KN-Breadboard-Computing/computer/schematics/final-cu/final-cu.jpg

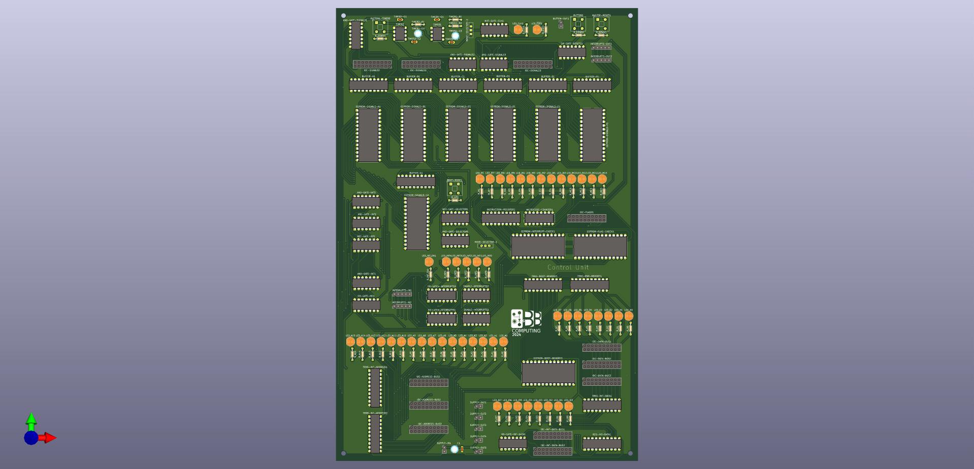
schematics/final-cu/final-cu.jpg
