KN-Breadboard-Computing/computer/schematics/final-alu/final-alu.jpg

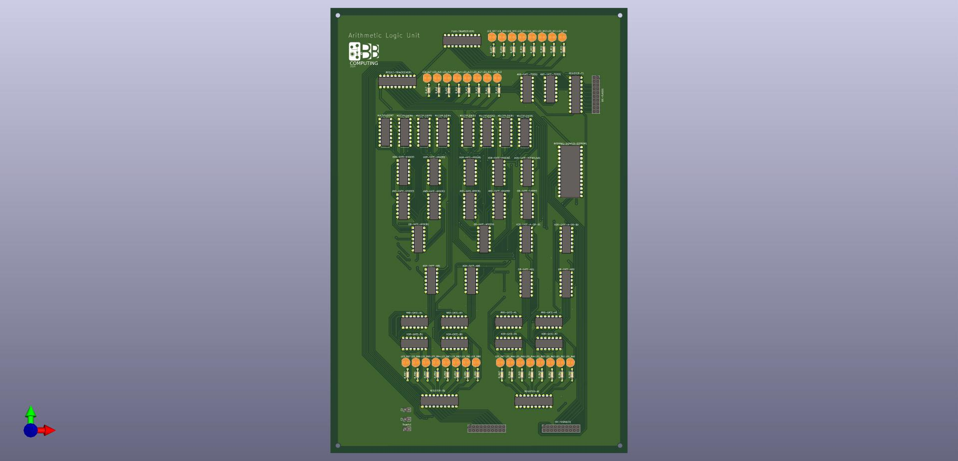
schematics/final-alu/final-alu.jpg
