KN-Breadboard-Computing/computer/eeproms-design/visualisations/MOVAIMM-MOVBA-MOVBIMM-MOVAB-MOVBIMM.html

0 | LOAD_PC_TO_MAR
1 | LOAD_MEM[MAR]_TO_IR_AND_MBR_PC++
2 | LOAD_PC_TO_MAR
3 | LOAD_MEM[MAR]_TO_A_PC++
4 | RST_MC
5 | LOAD_PC_TO_MAR
6 | LOAD_MEM[MAR]_TO_IR_AND_MBR_PC++
7 | LOAD_A_TO_B
8 | RST_MC
9 | LOAD_PC_TO_MAR
10 | LOAD_MEM[MAR]_TO_IR_AND_MBR_PC++
11 | LOAD_PC_TO_MAR
12 | LOAD_MEM[MAR]_TO_B_PC++
13 | RST_MC
14 | LOAD_PC_TO_MAR
15 | LOAD_MEM[MAR]_TO_IR_AND_MBR_PC++
16 | LOAD_B_TO_A
17 | RST_MC
18 | LOAD_PC_TO_MAR
19 | LOAD_MEM[MAR]_TO_IR_AND_MBR_PC++
20 | LOAD_PC_TO_MAR
21 | LOAD_MEM[MAR]_TO_B_PC++
22 | RST_MC

LOAD works on LOW to HIGH tick

TICK works on LOW to HIGH tick

EEPROM->REGS LATCHes are connected to CLK

signal name | init | | 0 | | | 1 | | | 2 | | | 3 | | | 4 | | | 5 | | | 6 | | | 7 | | | 8 | | | 9 | | | 10 | | | 11 | | | 12 | | | 13 | | | 14 | | | 15 | | | 16 | | | 17 | | | 18 | | | 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
CLK | L | | H | L | | H | L | | H | L | | H | L | | H | L | | H | L | | H | L | | H | L | | H | L | | H | L | | H | L | | H | L | | H | L | | H | L | | H | L | | H | L | | H | L | | H | L | | H | L | | 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
~CLK | H | | L | H | | L | H | | L | H | | L | H | | L | H | | L | H | | L | H | | L | H | | L | H | | L | H | | L | H | | L | H | | L | H | | L | H | | L | H | | L | H | | L | H | | L | H | | L | H | | 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
REG_A_LOAD (&~CLK) | L | | L | L | | L | L | | L | L | | L | H | | L | L | | L | L | | L | L | | L | L | | L | L | | L | L | | L | L | | L | L | | L | L | | L | L | | L | L | | L | L | | L | H | | L | L | | L | L | | 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
REG_B_LOAD (&~CLK) | L | | L | L | | L | L | | L | L | | L | L | | L | L | | L | L | | L | L | | L | H | | L | L | | L | L | | L | L | | L | L | | L | H | | L | L | | L | L | | L | L | | L | L | | L | L | | L | L | | 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
ALU_OPC_0 | L | | L | L | | L | L | | L | L | | L | L | | L | L | | L | L | | L | L | | L | L | | L | L | | L | L | | L | L | | L | L | | L | L | | L | L | | L | L | | L | L | | H | H | | L | L | | L | L | | 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
ALU_OPC_1 | L | | L | L | | L | L | | L | L | | L | L | | L | L | | L | L | | L | L | | L | L | | L | L | | L | L | | L | L | | L | L | | L | L | | L | L | | L | L | | L | L | | H | H | | L | L | | L | L | | 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
ALU_OPC_2 | L | | L | L | | L | L | | L | L | | L | L | | L | L | | L | L | | L | L | | H | H | | L | L | | L | L | | L | L | | L | L | | L | L | | L | L | | L | L | | L | L | | L | L | | L | L | | L | L | | 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
ALU_OPC_3 | L | | L | L | | L | L | | L | L | | L | L | | L | L | | L | L | | L | L | | L | L | | L | L | | L | L | | L | L | | L | L | | L | L | | L | L | | L | L | | L | L | | L | L | | L | L | | L | L | | 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
ALU_OPC_4 | L | | L | L | | L | L | | L | L | | L | L | | L | L | | L | L | | L | L | | L | L | | L | L | | L | L | | L | L | | L | L | | L | L | | L | L | | L | L | | L | L | | L | L | | L | L | | L | L | | 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
REG_F_LOAD (&~CLK) | L | | L | L | | L | L | | L | L | | L | L | | L | L | | L | L | | L | L | | L | L | | L | L | | L | L | | L | L | | L | L | | L | L | | L | L | | L | L | | L | L | | L | L | | L | L | | L | L | | 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
~REG_F_OUT | H | | H | H | | H | H | | H | H | | H | H | | H | H | | H | H | | H | H | | H | H | | H | H | | H | H | | H | H | | H | H | | H | H | | H | H | | H | H | | H | H | | H | H | | H | H | | H | H | | 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
~ALU_OUT | H | | H | H | | H | H | | H | H | | H | H | | H | H | | H | H | | H | H | | L | L | | H | H | | H | H | | H | H | | H | H | | H | H | | H | H | | H | H | | H | H | | L | L | | H | H | | H | H | | 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
REG_TMPH_LOAD (&~CLK) | L | | L | L | | L | L | | L | L | | L | L | | L | L | | L | L | | L | L | | L | L | | L | L | | L | L | | L | L | | L | L | | L | L | | L | L | | L | L | | L | L | | L | L | | L | L | | L | L | | 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
REG_TMPL_LOAD (&~CLK) | L | | L | L | | L | L | | L | L | | L | L | | L | L | | L | L | | L | L | | L | L | | L | L | | L | L | | L | L | | L | L | | L | L | | L | L | | L | L | | L | L | | L | L | | L | L | | L | L | | 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
~REG_TMPH_OUT | H | | H | H | | H | H | | H | H | | H | H | | H | H | | H | H | | H | H | | H | H | | H | H | | H | H | | H | H | | H | H | | H | H | | H | H | | H | H | | H | H | | H | H | | H | H | | H | H | | 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
~REG_TMPL_OUT | H | | H | H | | H | H | | H | H | | H | H | | H | H | | H | H | | H | H | | H | H | | H | H | | H | H | | H | H | | H | H | | H | H | | H | H | | H | H | | H | H | | H | H | | H | H | | H | H | | 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
~MCC_RST | H | | H | H | | H | H | | H | H | | H | H | | L | L | | H | H | | H | H | | H | H | | L | L | | H | H | | H | H | | H | H | | H | H | | L | L | | H | H | | H | H | | H | H | | L | L | | H | H | | 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
