KN-Breadboard-Computing/computer/photos/breadboards/alu-module.jpg

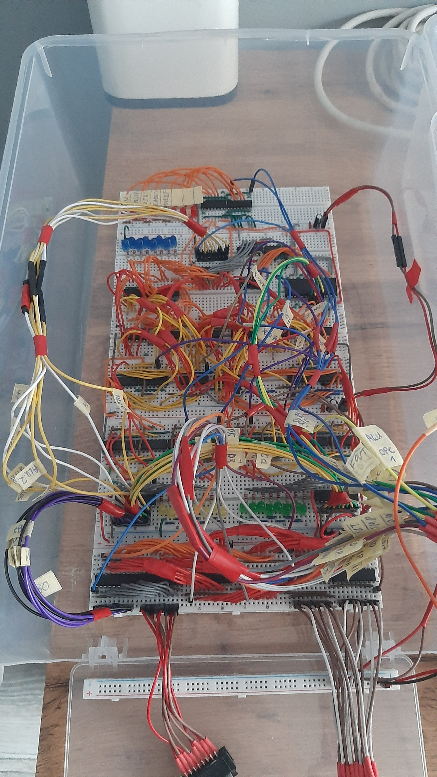
photos/breadboards/alu-module.jpg
