KN-Breadboard-Computing/computer/photos/breadboards/control-unit-clock-module.jpg

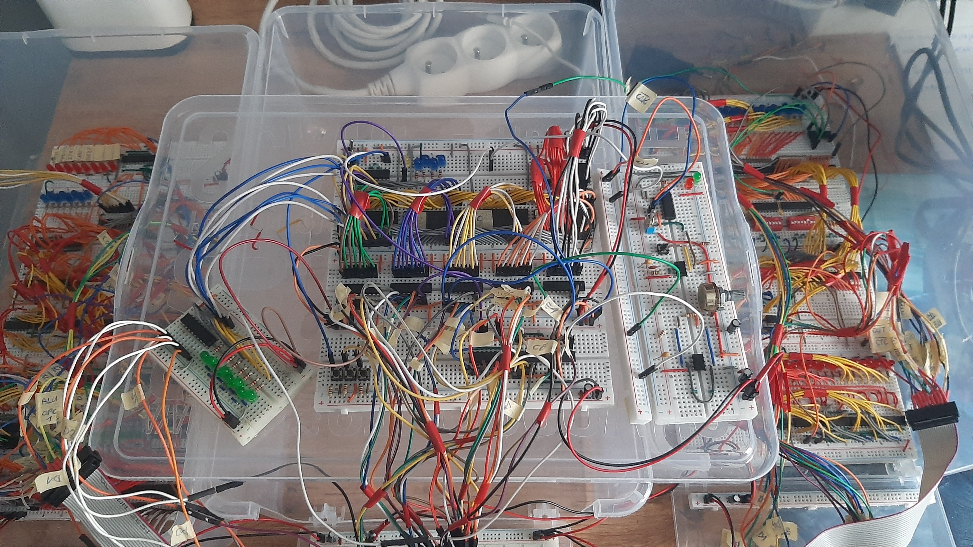
photos/breadboards/control-unit-clock-module.jpg
