KN-Breadboard-Computing/computer/photos/breadboards/linked-modules.jpg

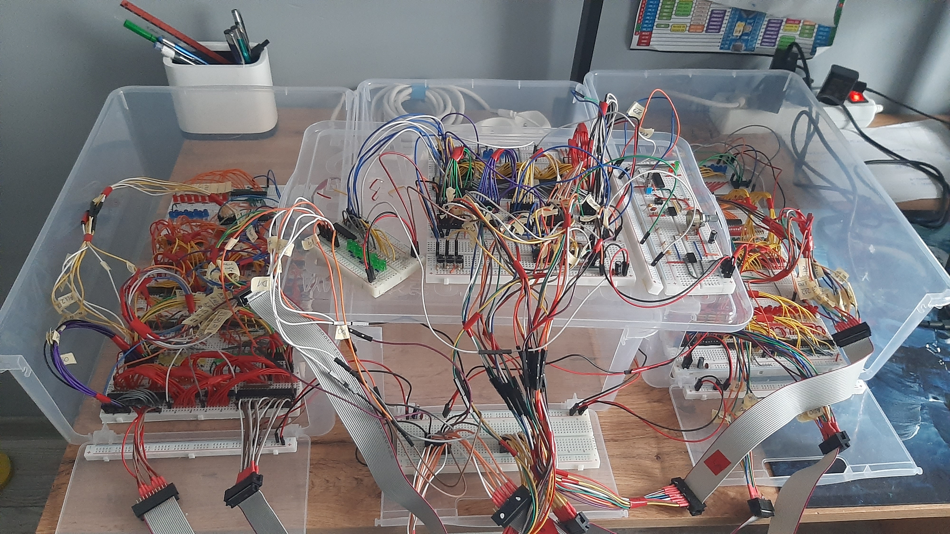
photos/breadboards/linked-modules.jpg
