KN-Breadboard-Computing/computer/photos/breadboards/memory-counters-module.jpg

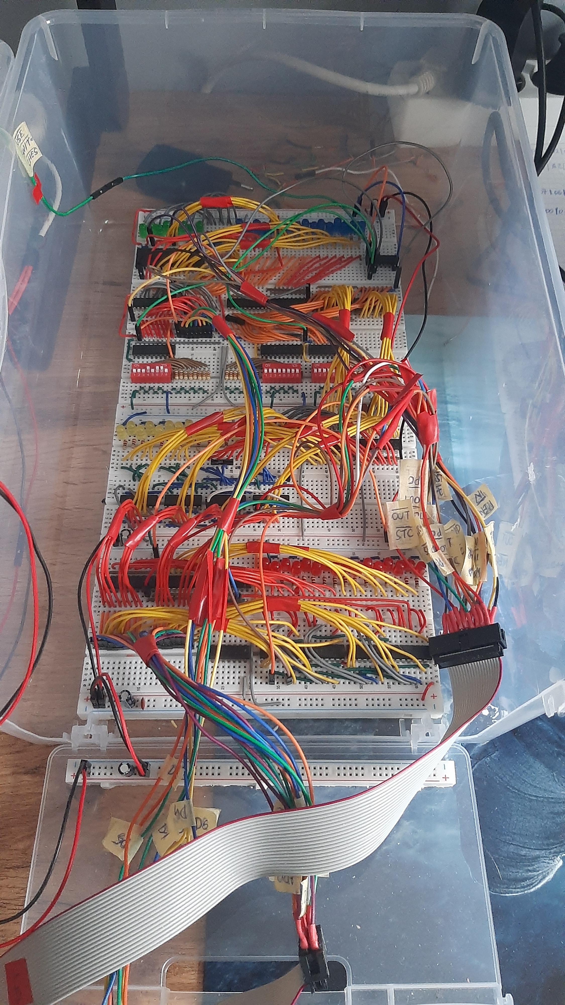
photos/breadboards/memory-counters-module.jpg
