KN-Breadboard-Computing/computer/photos/breadboards/powered-up-cpu-1.jpg

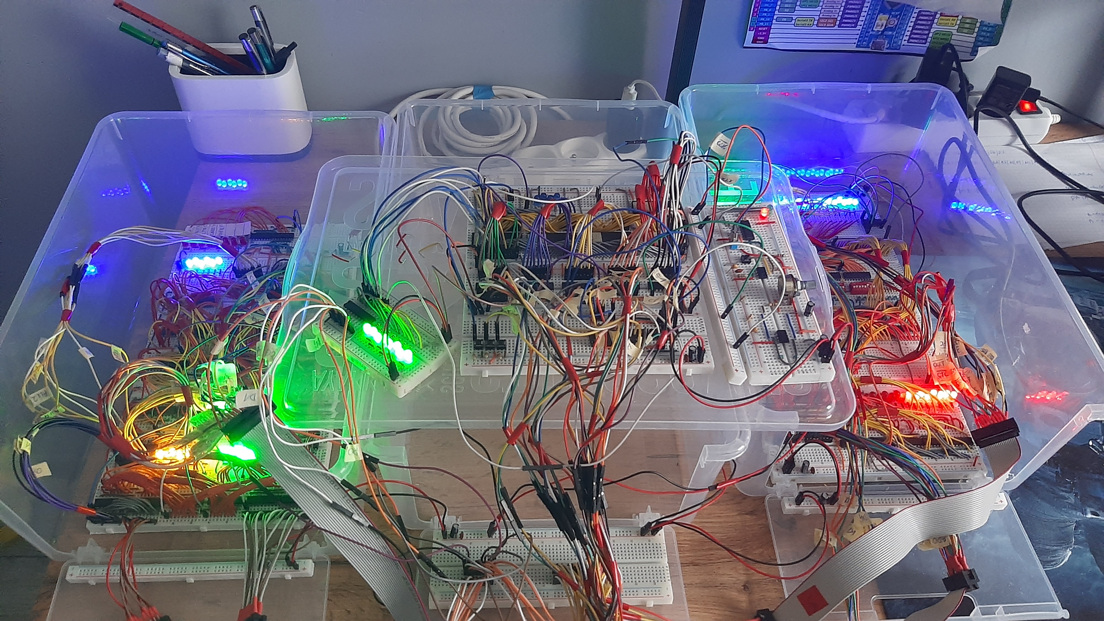
photos/breadboards/powered-up-cpu-1.jpg
