KN-Breadboard-Computing/computer/photos/breadboards/powered-up-cpu-2.jpg

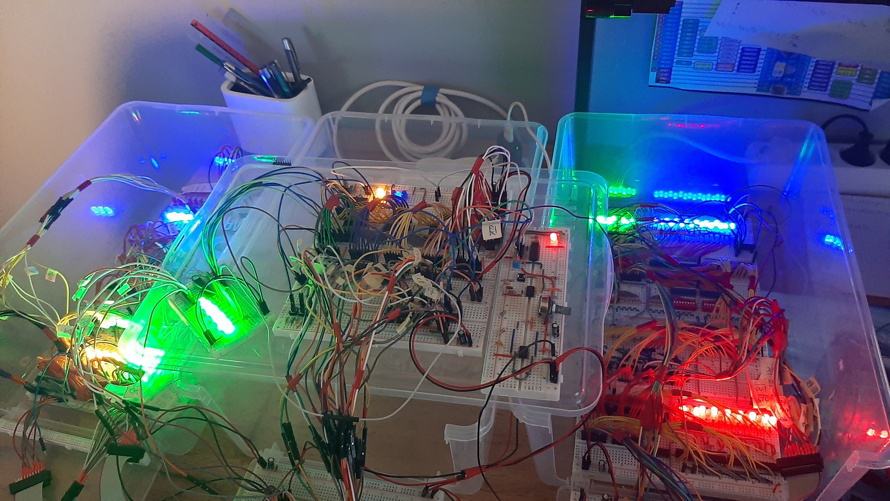
photos/breadboards/powered-up-cpu-2.jpg
