KN-Breadboard-Computing/computer/photos/diy_pcbs/20240428_120138.jpg

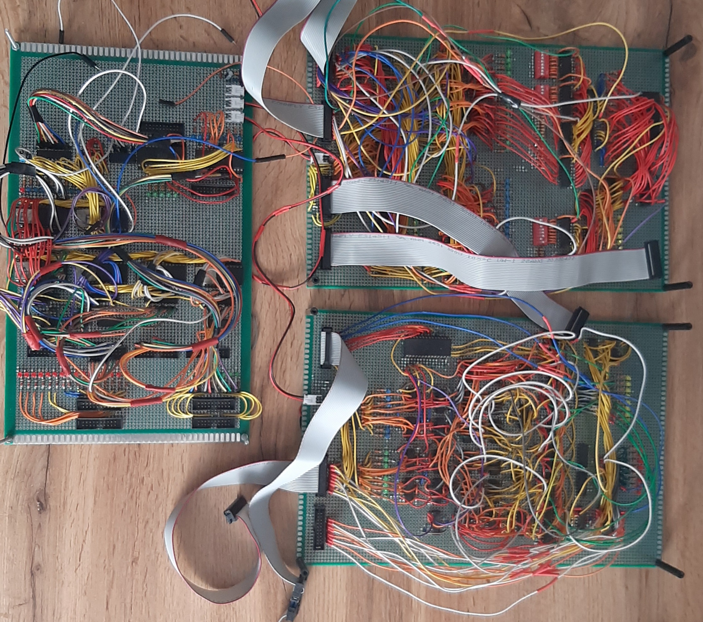
photos/diy_pcbs/20240428_120138.jpg
