KN-Breadboard-Computing/computer/photos/diy_pcbs/20240428_120143.jpg

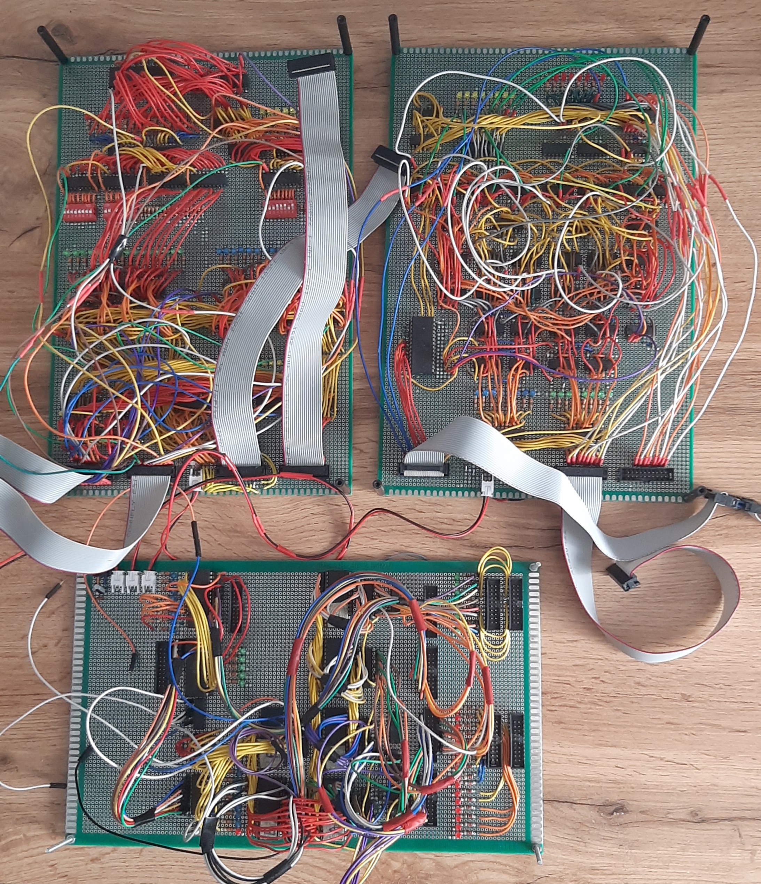
photos/diy_pcbs/20240428_120143.jpg
