KN-Breadboard-Computing/computer/photos/diy_pcbs/20240428_122211.jpg

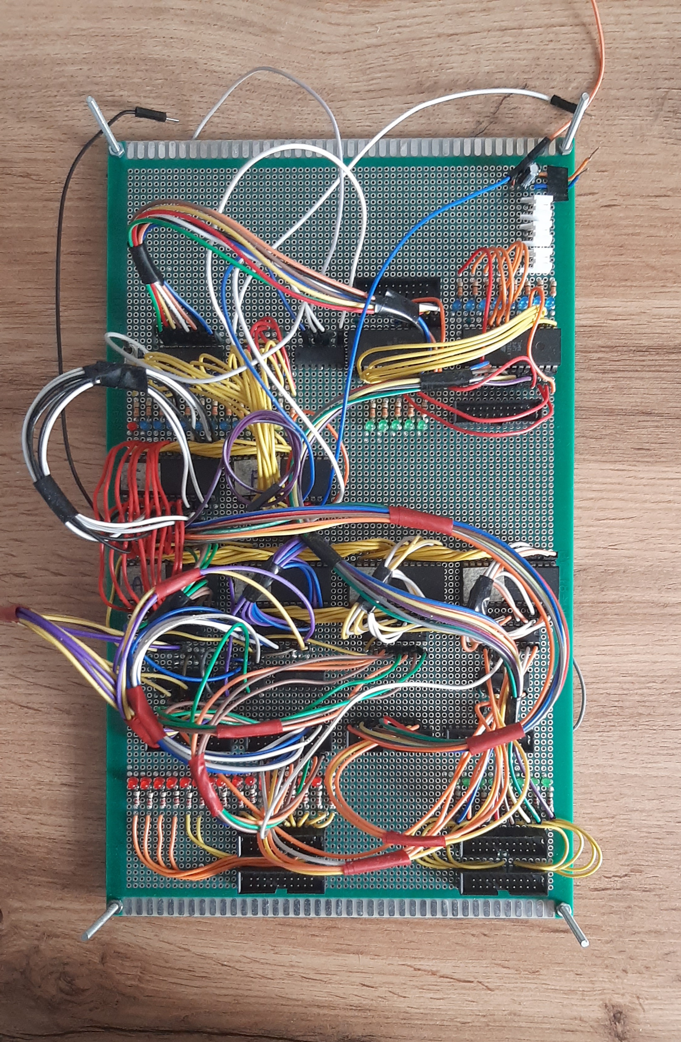
photos/diy_pcbs/20240428_122211.jpg
