KN-Breadboard-Computing/computer/schematics/additional-libraries/toggle-switch-47.snapshot.2/toggle_switch_3P.png

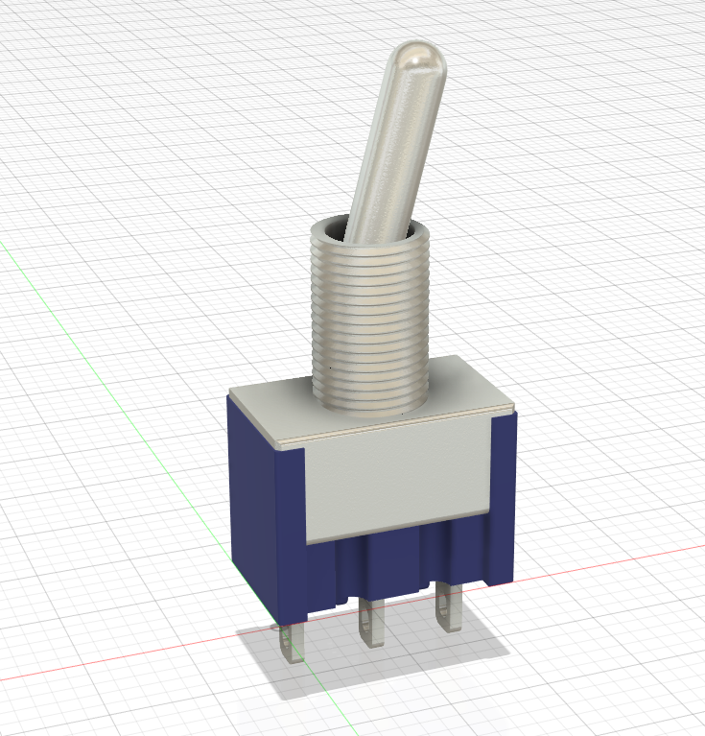
schematics/additional-libraries/toggle-switch-47.snapshot.2/toggle_switch_3P.png
