KN-Breadboard-Computing/computer/schematics/final-memory/final-memory.jpg

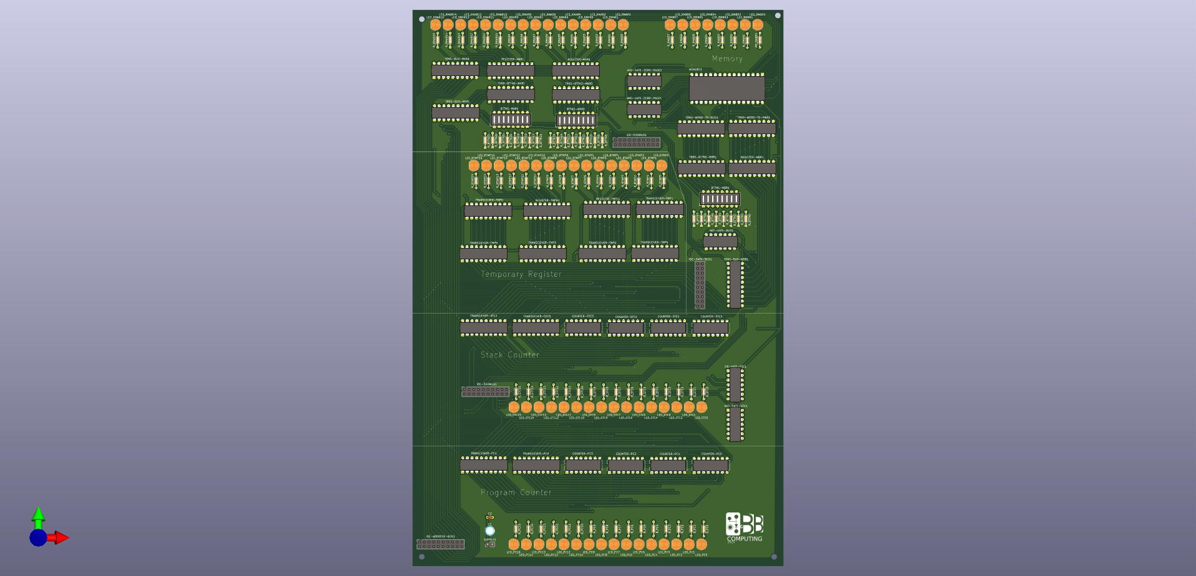
schematics/final-memory/final-memory.jpg
