KN-Breadboard-Computing/computer/schematics/additional-libraries/LIB_AT28C64B-15PU/AT28C64B-15PU/3D/AT28C64B-15PU.stp

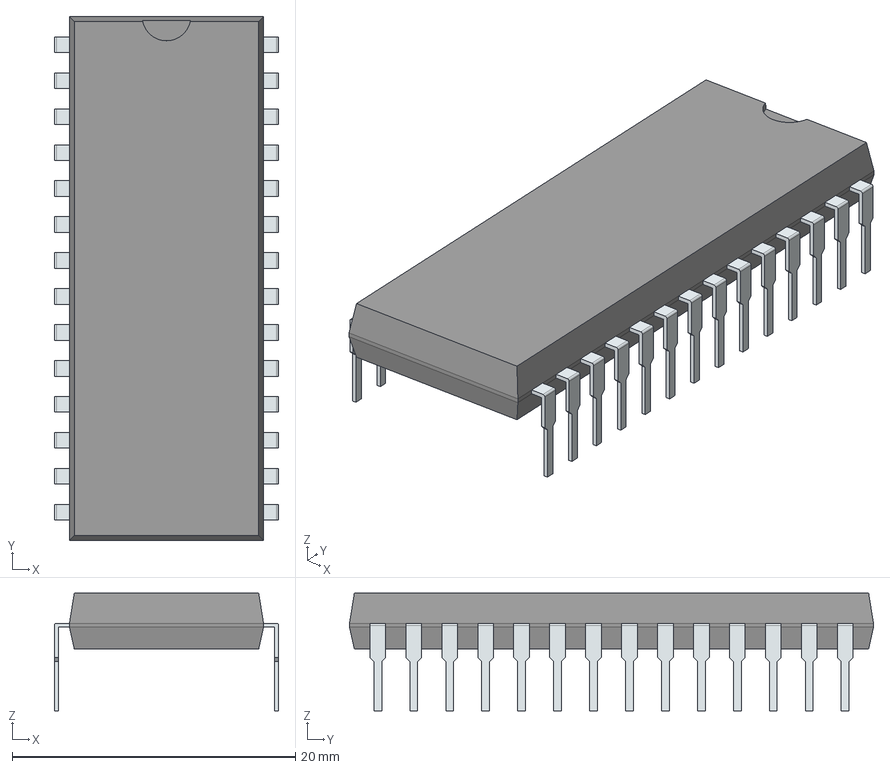
[picture p17: CAD file, 2024-05-19]
schematics/additional-libraries/LIB_AT28C64B-15PU/AT28C64B-15PU/3D/AT28C64B-15PU.stp
15.8 x 37.0 x 8.33 mm
PinsArrayLR
