KN-Breadboard-Computing/computer/schematics/additional-libraries/LIB_CD4030BEE4/CD4030BEE4/3D/CD4030BEE4.stp

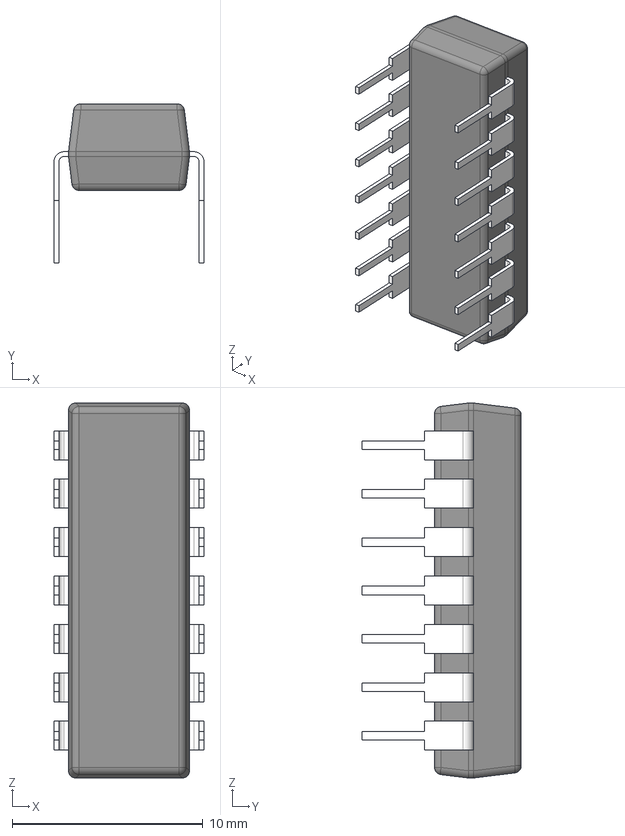
[picture p18: CAD file, 2024-05-19]
schematics/additional-libraries/LIB_CD4030BEE4/CD4030BEE4/3D/CD4030BEE4.stp
7.87 x 8.37 x 19.7 mm
BODY_N0014A_AF0
LEAD_N0014A_AF1
LEAD_N0014A x 10
LEAD_N0014A_AF3
LEAD_N0014A_AF0
LEAD_N0014A_AF2
