KN-Breadboard-Computing/computer/schematics/additional-libraries/LIB_CD4043BEE4/CD4043BEE4/3D/CD4043BEE4.stp

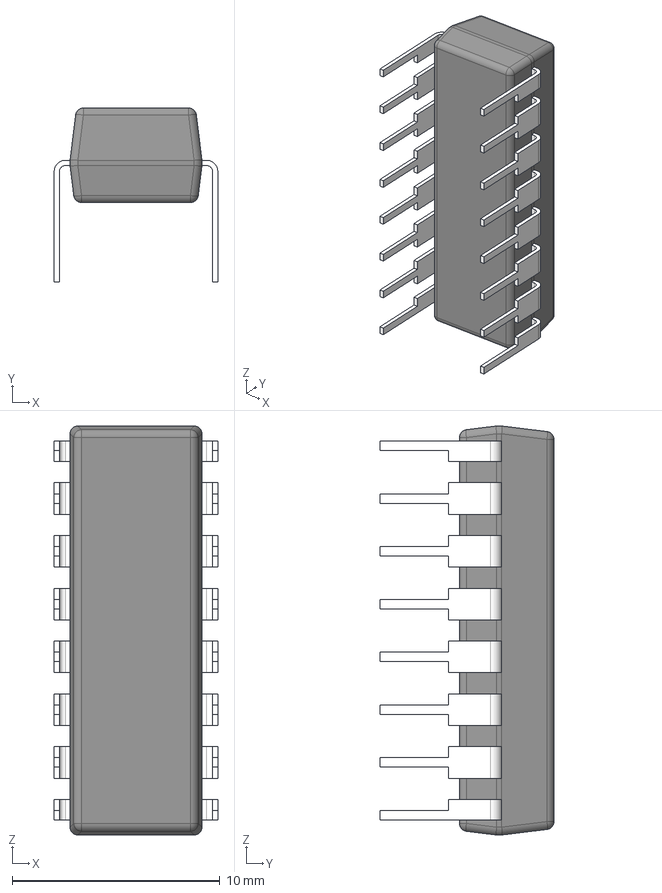
[picture p19: CAD file, 2024-05-19]
schematics/additional-libraries/LIB_CD4043BEE4/CD4043BEE4/3D/CD4043BEE4.stp
7.87 x 8.37 x 19.7 mm
BODY_N0016A_AF0
LEAD_N0016A_AF1
LEAD_N0016A x 10
LEAD_N0016A_AF3
LEAD_N0016A_AF5
LEAD_N0016A_AF0
LEAD_N0016A_AF2
LEAD_N0016A_AF4
