KN-Breadboard-Computing/computer/schematics/additional-libraries/LIB_DS1013-20SSIB1-B-0/DS1013-20SSIB1-B-0/3D/DS1013-20SSIB1-B-0.stp

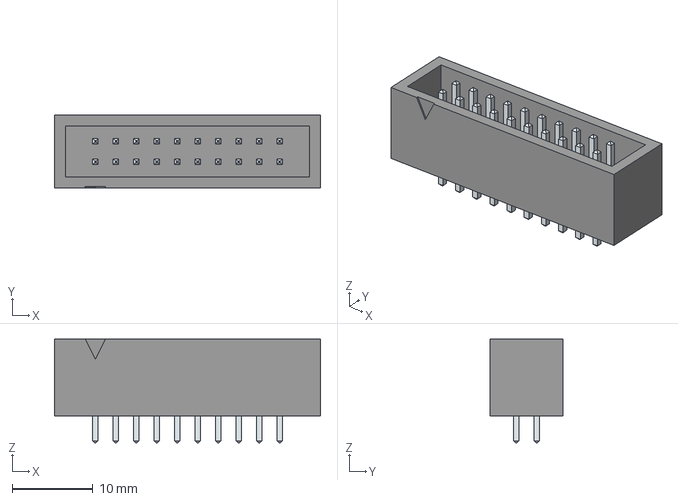
[picture p20: CAD file, 2024-05-19]
schematics/additional-libraries/LIB_DS1013-20SSIB1-B-0/DS1013-20SSIB1-B-0/3D/DS1013-20SSIB1-B-0.stp
33.0 x 9.10 x 12.9 mm
LeadsArray
