KN-Breadboard-Computing/computer/schematics/additional-libraries/LIB_SN74AC245N/SN74AC245N/3D/SN74AC245N.stp

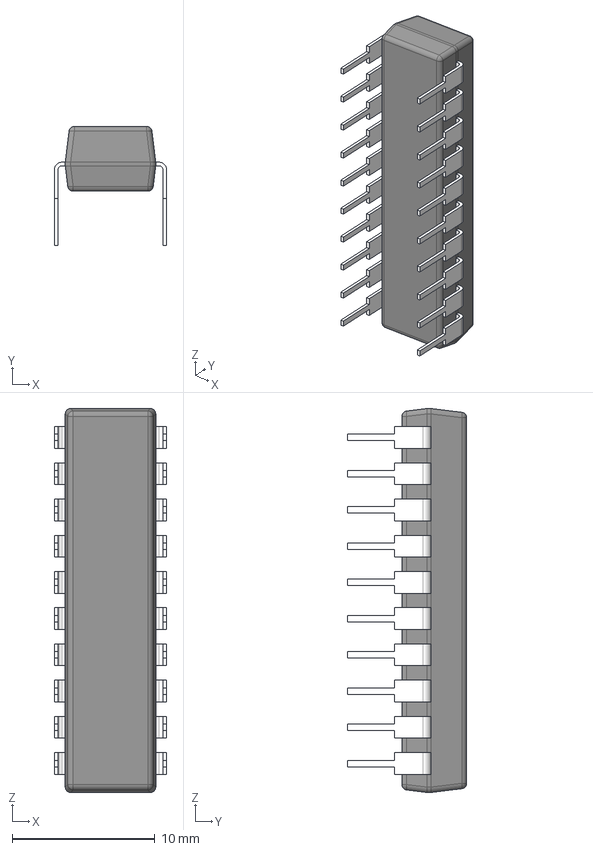
[picture p21: CAD file, 2024-05-19]
schematics/additional-libraries/LIB_SN74AC245N/SN74AC245N/3D/SN74AC245N.stp
7.87 x 8.37 x 26.9 mm
BODY_N0020A_AF0
LEAD_N0020A_AF1
LEAD_N0020A x 16
LEAD_N0020A_AF3
LEAD_N0020A_AF0
LEAD_N0020A_AF2
