KN-Breadboard-Computing/computer/schematics/additional-libraries/tactile-switches-6mm-tht-1.snapshot.2/models3d/Switches/TS6-THT_H-5.0.step

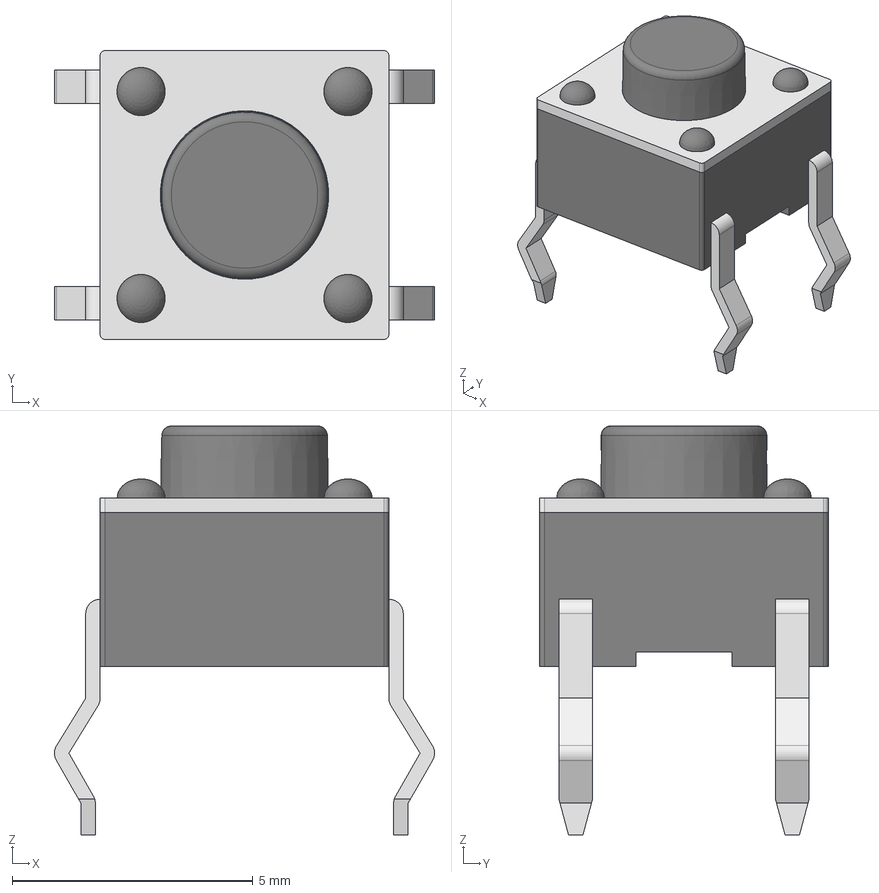
[picture p22: CAD file, 2024-05-19]
schematics/additional-libraries/tactile-switches-6mm-tht-1.snapshot.2/models3d/Switches/TS6-THT_H-5.0.step
7.90 x 6.00 x 8.50 mm
