KN-Breadboard-Computing/computer/schematics/additional-libraries/toggle-switch-47.snapshot.2/toggle_switch.step

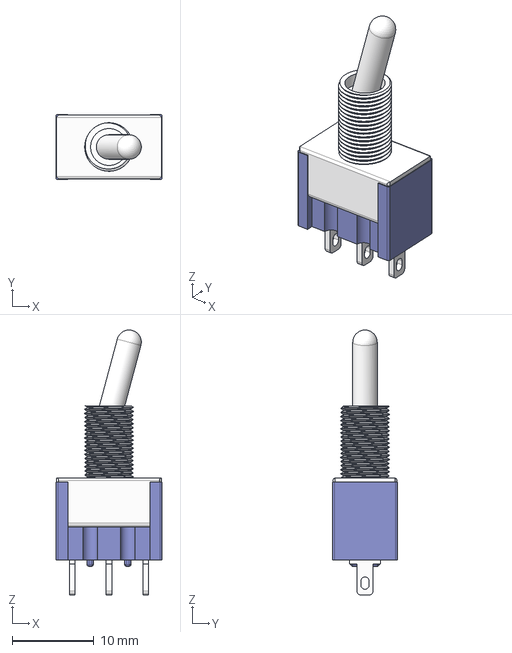
[picture p23: CAD file, 2024-05-19]
schematics/additional-libraries/toggle-switch-47.snapshot.2/toggle_switch.step
13.0 x 8.00 x 32.4 mm
