KN-Breadboard-Computing/computer/schematics/additional-libraries/tactile-switches-6mm-tht-1.snapshot.2/models3d/Switches/TS6-THT_H-20.0.step

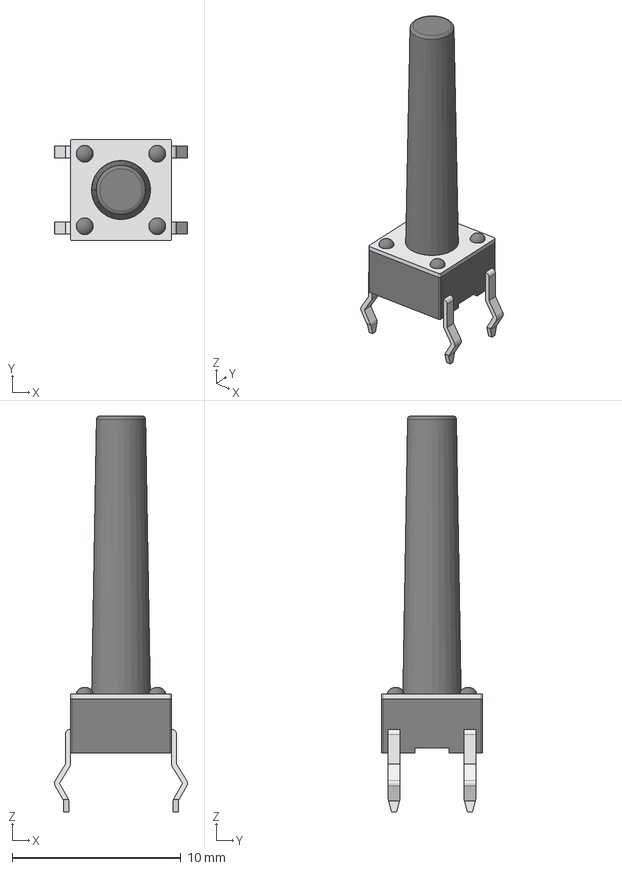
[picture p25: CAD file, 2024-05-19]
schematics/additional-libraries/tactile-switches-6mm-tht-1.snapshot.2/models3d/Switches/TS6-THT_H-20.0.step
7.90 x 6.00 x 23.5 mm
