KN-Breadboard-Computing/computer/(list of files, cad)

Other CAD files:
schematics/additional-libraries/tactile-switches-6mm-tht-1.snapshot.2/models3d/Switches/TS6-THT_H-7.5.step
schematics/additional-libraries/LIB_1825967-1/1825967-1/3D/1825967-1.stp
schematics/additional-libraries/LIB_1825967-1/1825967-1/Allegro/18259671.psm
schematics/additional-libraries/LIB_1825967-1/1825967-1/DEHDL/1825967_1/chips/chips.prt
schematics/additional-libraries/LIB_AS6C1008-55PCN/AS6C1008-55PCN/Allegro/dip254p1524x393-32.psm
schematics/additional-libraries/LIB_AS6C1008-55PCN/AS6C1008-55PCN/DEHDL/as6c1008_55pcn/chips/chips.prt
schematics/additional-libraries/LIB_AT28C64B-15PU/AT28C64B-15PU/Allegro/dip1556w56p254l3702h483q28n.psm
schematics/additional-libraries/LIB_AT28C64B-15PU/AT28C64B-15PU/DEHDL/at28c64b_15pu/chips/chips.prt
schematics/additional-libraries/LIB_CD4030BEE4/CD4030BEE4/Allegro/dip794w53p254l1930h508q14n.psm
schematics/additional-libraries/LIB_CD4030BEE4/CD4030BEE4/DEHDL/cd4030bee4/chips/chips.prt
schematics/additional-libraries/LIB_CD4043BEE4/CD4043BEE4/Allegro/dip794w53p254l1930h508q16n.psm
schematics/additional-libraries/LIB_CD4043BEE4/CD4043BEE4/DEHDL/cd4043bee4/chips/chips.prt
schematics/additional-libraries/LIB_CD4071BEE4/CD4071BEE4/Allegro/dip794w53p254l1930h508q14n.psm
schematics/additional-libraries/LIB_CD4071BEE4/CD4071BEE4/DEHDL/cd4071bee4/chips/chips.prt
schematics/additional-libraries/LIB_CD4081BEE4/CD4081BEE4/Allegro/dip794w53p254l1930h508q14n.psm
schematics/additional-libraries/LIB_CD4081BEE4/CD4081BEE4/DEHDL/cd4081bee4/chips/chips.prt
schematics/additional-libraries/LIB_CD74HC04E/CD74HC04E/Allegro/dip794w53p254l1930h508q14n.psm
schematics/additional-libraries/LIB_CD74HC04E/CD74HC04E/DEHDL/cd74hc04e/chips/chips.prt
schematics/additional-libraries/LIB_CD74HC193E/CD74HC193E/Allegro/dip794w53p254l1930h508q16n.psm
schematics/additional-libraries/LIB_CD74HC193E/CD74HC193E/DEHDL/cd74hc193e/chips/chips.prt
schematics/additional-libraries/LIB_DS1013-20SSIB1-B-0/DS1013-20SSIB1-B-0/Allegro/shdr20w69p254x254_2x10_3300x910x955p.psm
schematics/additional-libraries/LIB_DS1013-20SSIB1-B-0/DS1013-20SSIB1-B-0/DEHDL/ds1013_20ssib1_b_0/chips/chips.prt
schematics/additional-libraries/LIB_SN74AC245N/SN74AC245N/Allegro/dip794w53p254l2540h508q20n.psm
schematics/additional-libraries/LIB_SN74AC245N/SN74AC245N/DEHDL/sn74ac245n/chips/chips.prt
schematics/additional-libraries/LIB_SN74HC151N/SN74HC151N/Allegro/dip794w53p254l1930h508q16n.psm
schematics/additional-libraries/LIB_SN74HC151N/SN74HC151N/DEHDL/sn74hc151n/chips/chips.prt
schematics/additional-libraries/LIB_SN74HC574N/SN74HC574N/Allegro/dip794w53p254l2540h508q20n.psm
schematics/additional-libraries/LIB_SN74HC574N/SN74HC574N/DEHDL/sn74hc574n/chips/chips.prt
