KN-Breadboard-Computing/computer/schematics/final-cu/final-cu.pdf

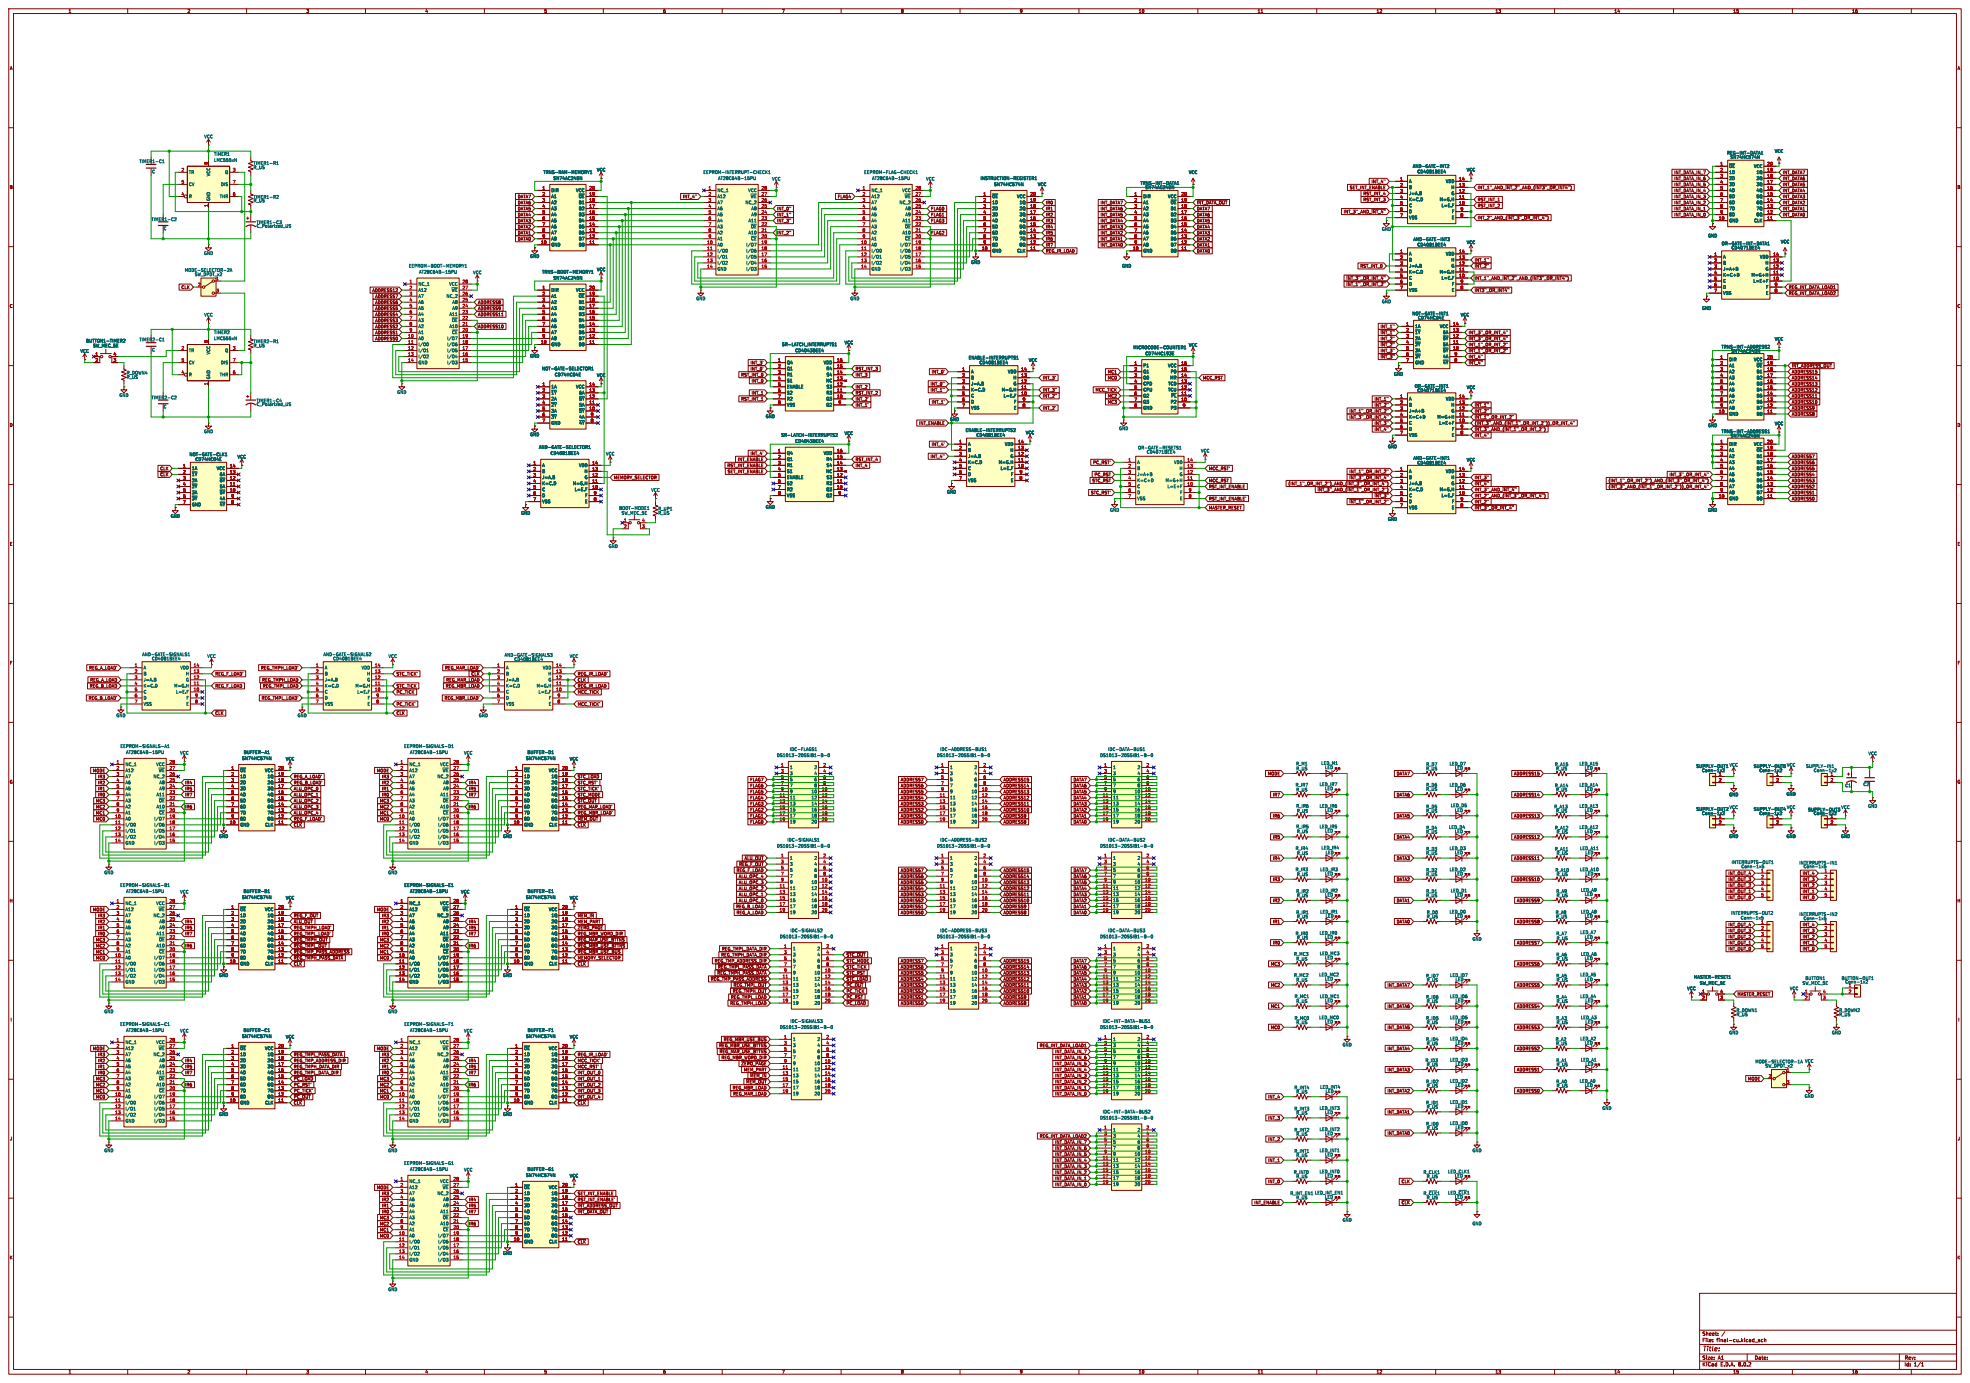
[picture p38: page 1]

9 OR-GATE-INT-DATA1 CD4071BEE4 GND

Id: 1/1 Title: File: final-cu.kicad_sch Sheet: /
