KN-Breadboard-Computing/computer/schematics/final-alu/final-alu.pdf

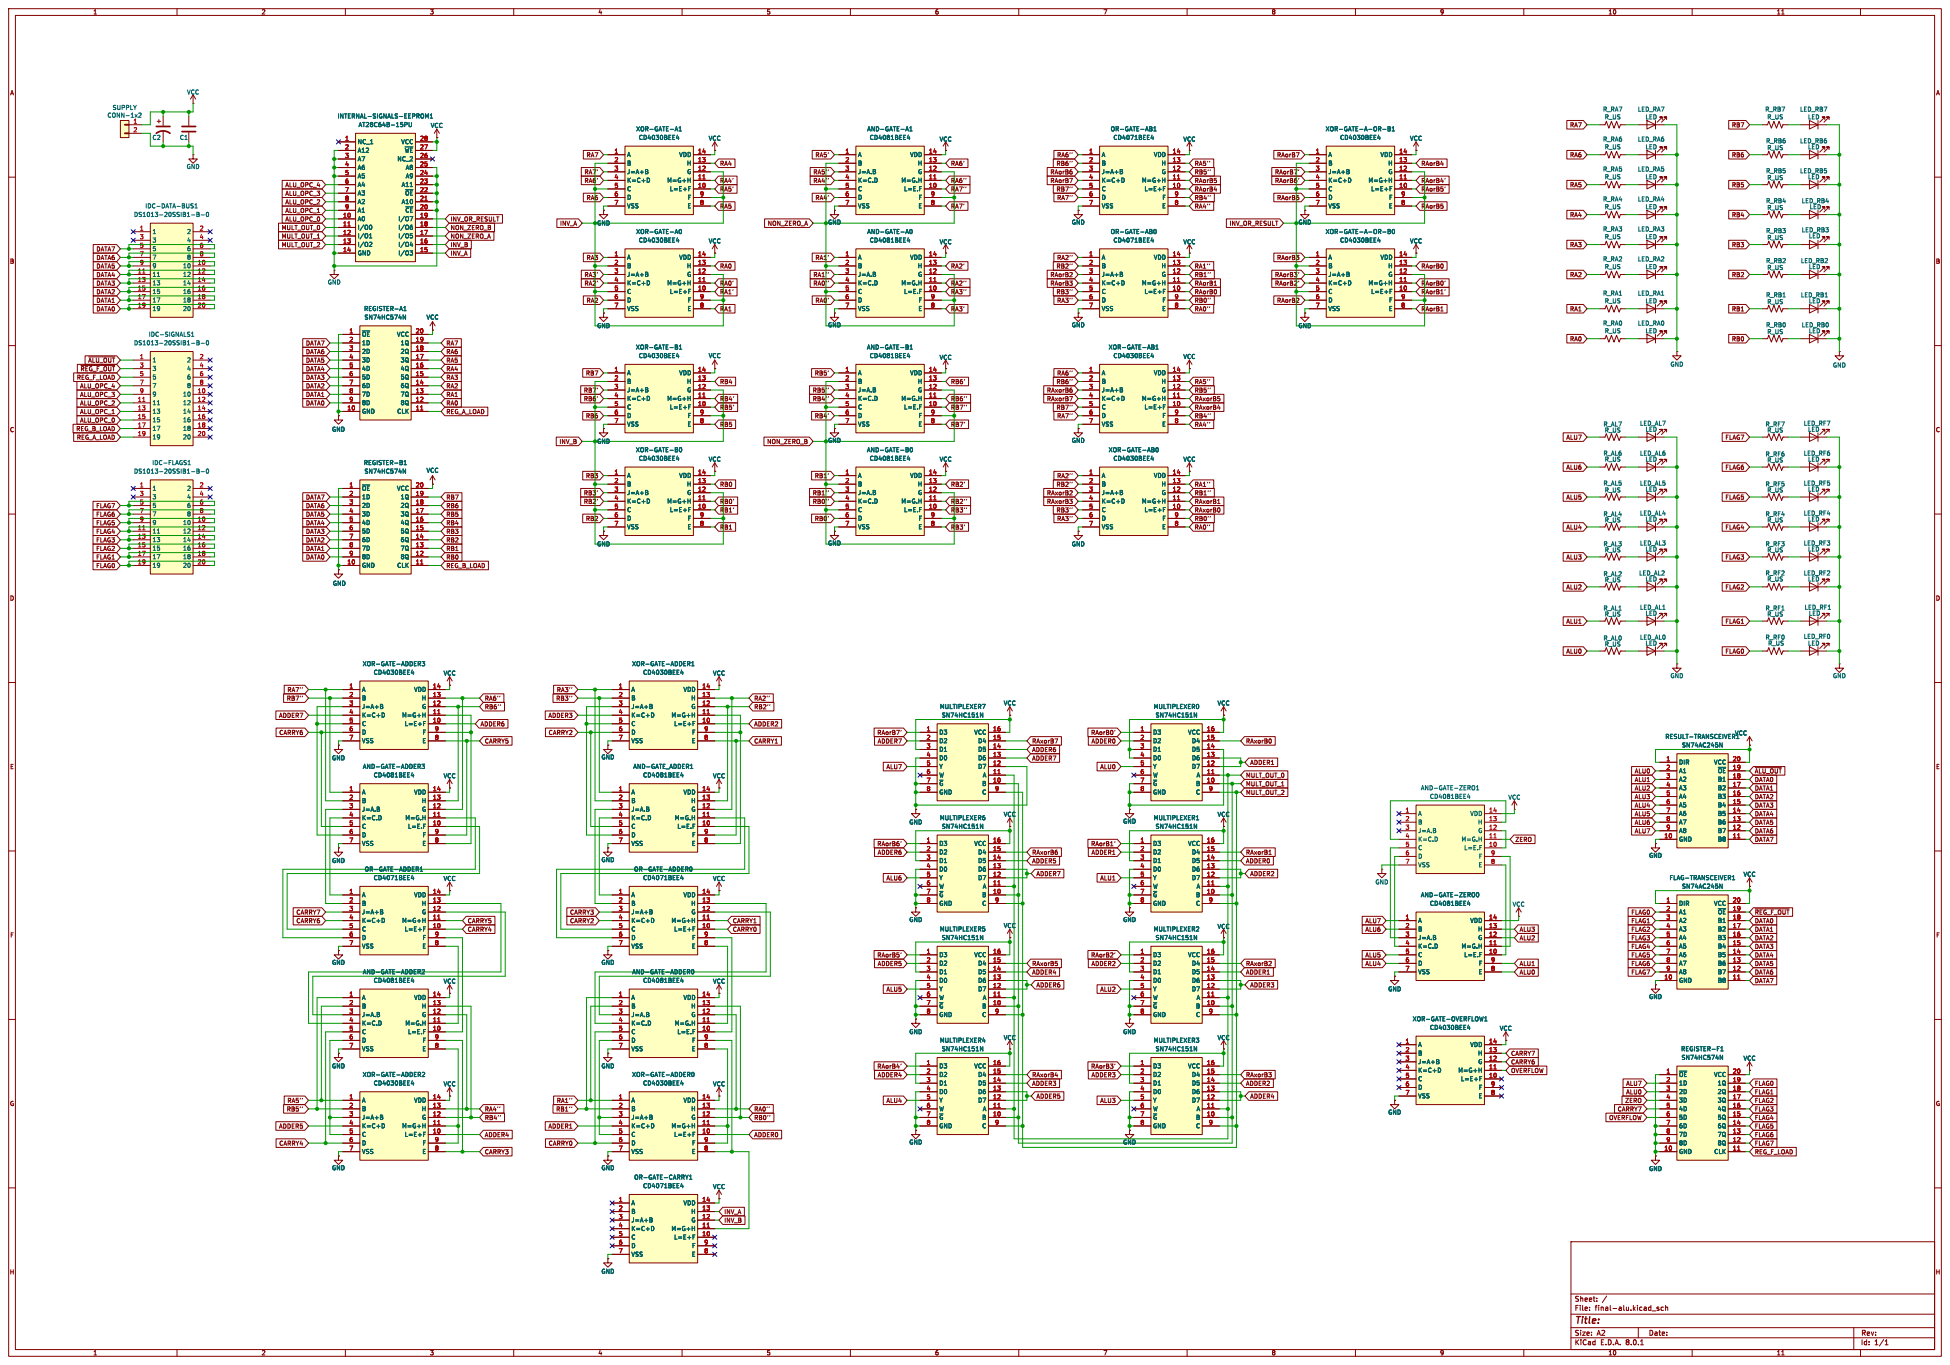
[picture p39: page 1]
