KN-Breadboard-Computing/computer/schematics/final-memory/final-memory.pdf

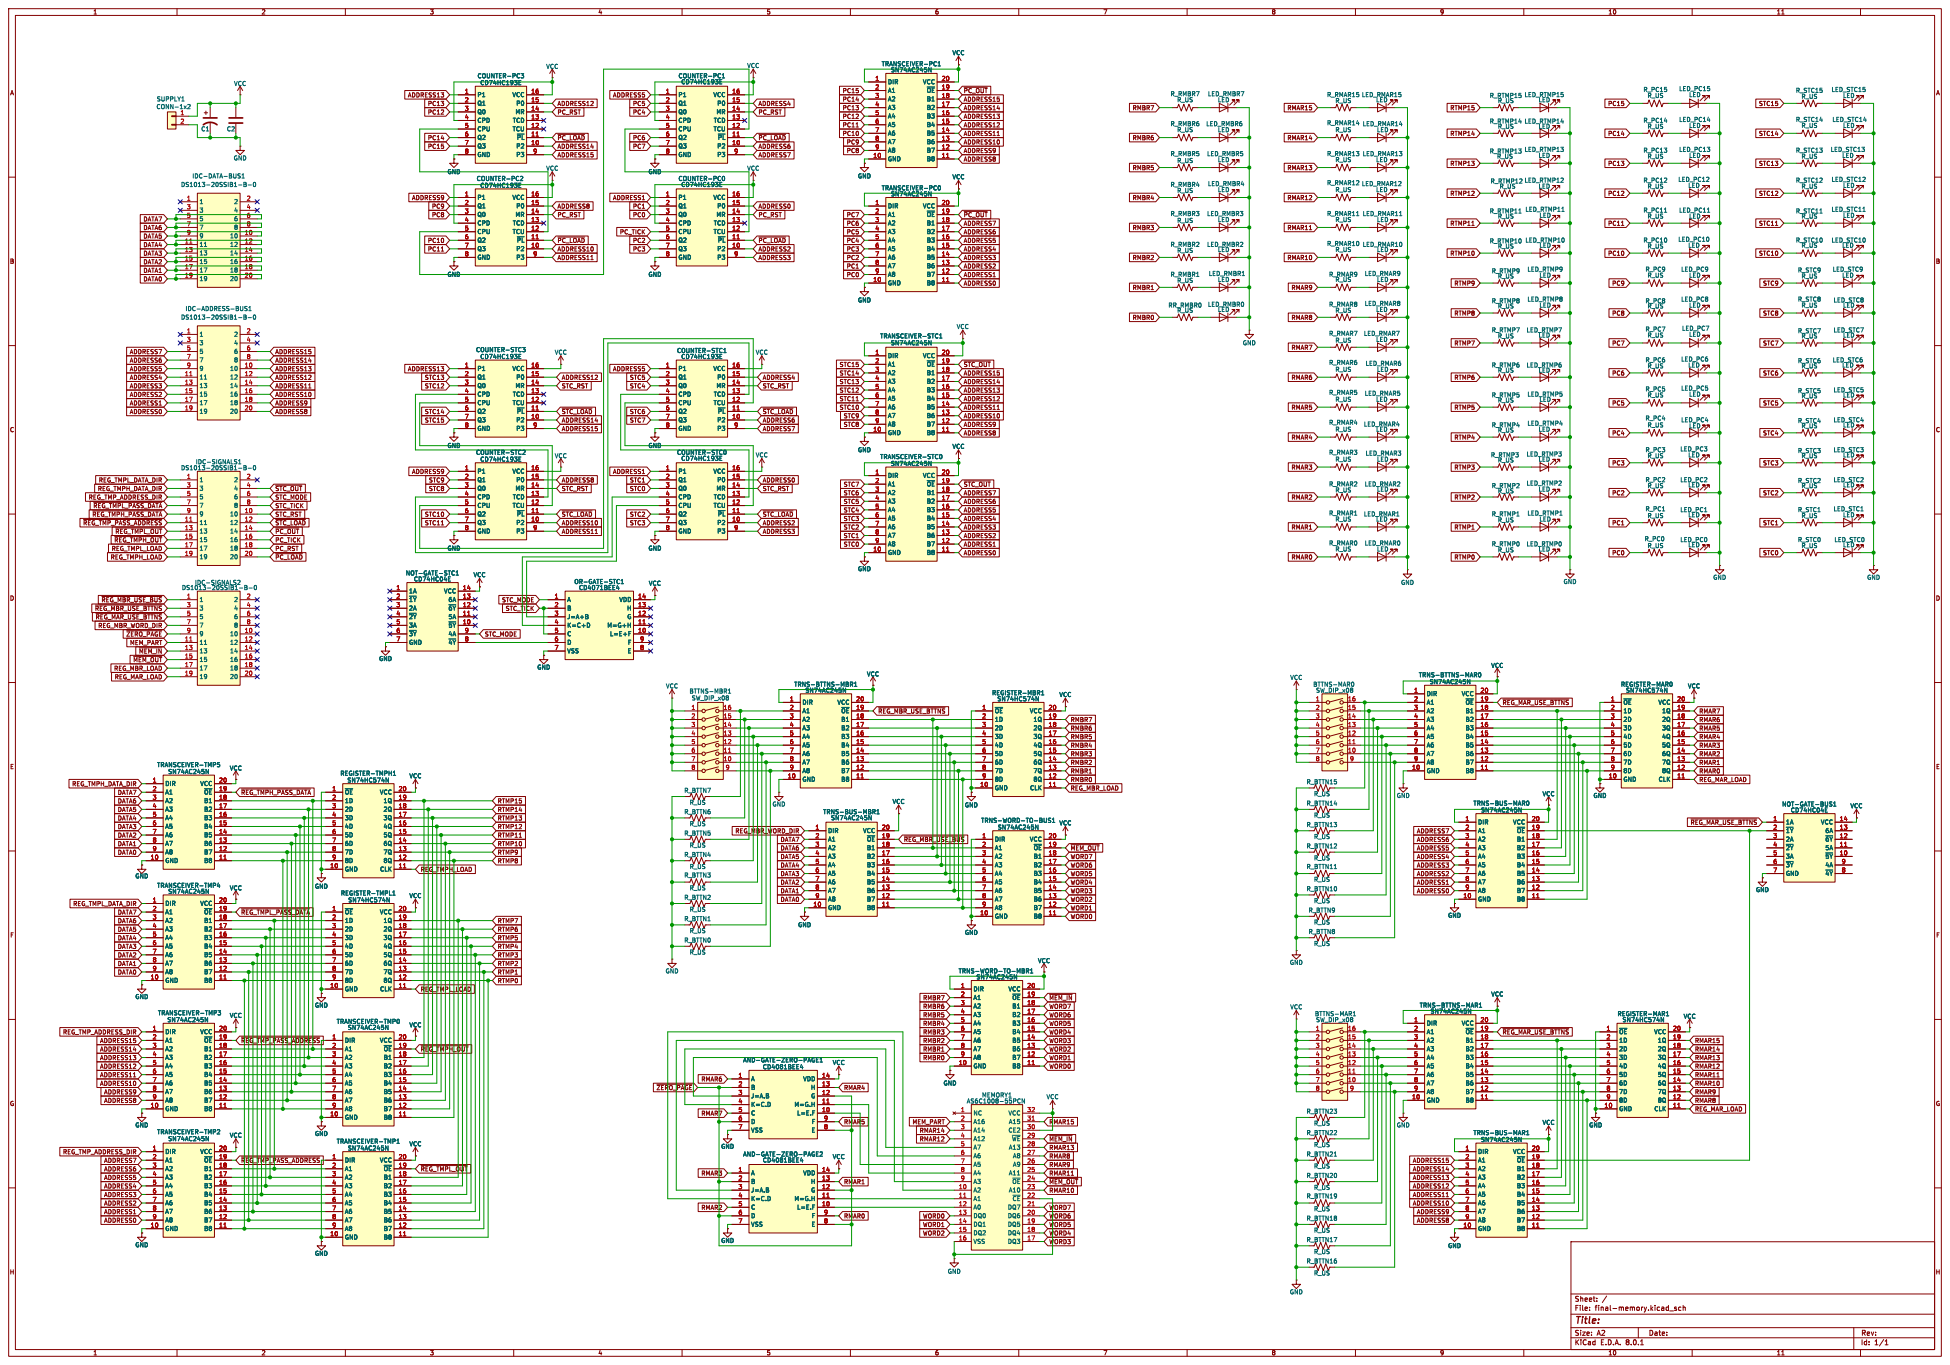
[picture p40: page 1]
