KN-Breadboard-Computing/computer/(list of files, drawings)

Other design files:
schematics/additional-libraries/LIB_AT28C64B-15PU/AT28C64B-15PU/Altium/AT28C64B-15PU.SchLib
schematics/additional-libraries/LIB_AT28C64B-15PU/AT28C64B-15PU/Altium/DIP1556W56P254L3702H483Q28N.PcbLib
schematics/additional-libraries/LIB_CD74HC04E/CD74HC04E/Altium/CD74HC04E.SchLib
schematics/additional-libraries/LIB_CD74HC04E/CD74HC04E/Altium/DIP794W53P254L1930H508Q14N.PcbLib
schematics/additional-libraries/LIB_CD4030BEE4/CD4030BEE4/Altium/CD4030BEE4.SchLib
schematics/additional-libraries/LIB_CD4030BEE4/CD4030BEE4/Altium/DIP794W53P254L1930H508Q14N.PcbLib
schematics/additional-libraries/LIB_CD4071BEE4/CD4071BEE4/Altium/CD4071BEE4.SchLib
schematics/additional-libraries/LIB_CD4071BEE4/CD4071BEE4/Altium/DIP794W53P254L1930H508Q14N.PcbLib
schematics/additional-libraries/LIB_CD4081BEE4/CD4081BEE4/Altium/CD4081BEE4.SchLib
schematics/additional-libraries/LIB_CD4081BEE4/CD4081BEE4/Altium/DIP794W53P254L1930H508Q14N.PcbLib
schematics/additional-libraries/LIB_DS1013-20SSIB1-B-0/DS1013-20SSIB1-B-0/Altium/DS1013-20SSIB1-B-0.SchLib
schematics/additional-libraries/LIB_DS1013-20SSIB1-B-0/DS1013-20SSIB1-B-0/Altium/SHDR20W69P254X254_2X10_3300X910X955P.PcbLib
schematics/additional-libraries/LIB_SN74AC245N/SN74AC245N/Altium/DIP794W53P254L2540H508Q20N.PcbLib
schematics/additional-libraries/LIB_SN74AC245N/SN74AC245N/Altium/SN74AC245N.SchLib
schematics/additional-libraries/LIB_SN74HC151N/SN74HC151N/Altium/DIP794W53P254L1930H508Q16N.PcbLib
schematics/additional-libraries/LIB_SN74HC151N/SN74HC151N/Altium/SN74HC151N.SchLib
schematics/additional-libraries/LIB_SN74HC574N/SN74HC574N/Altium/DIP794W53P254L2540H508Q20N.PcbLib
schematics/additional-libraries/LIB_SN74HC574N/SN74HC574N/Altium/SN74HC574N.SchLib
