KN-Breadboard-Computing/computer/schematics/final-alu/final-alu.kicad_pcb

## KiCad design schematics/final-alu/final-alu.kicad_pcb (2024-05-23)

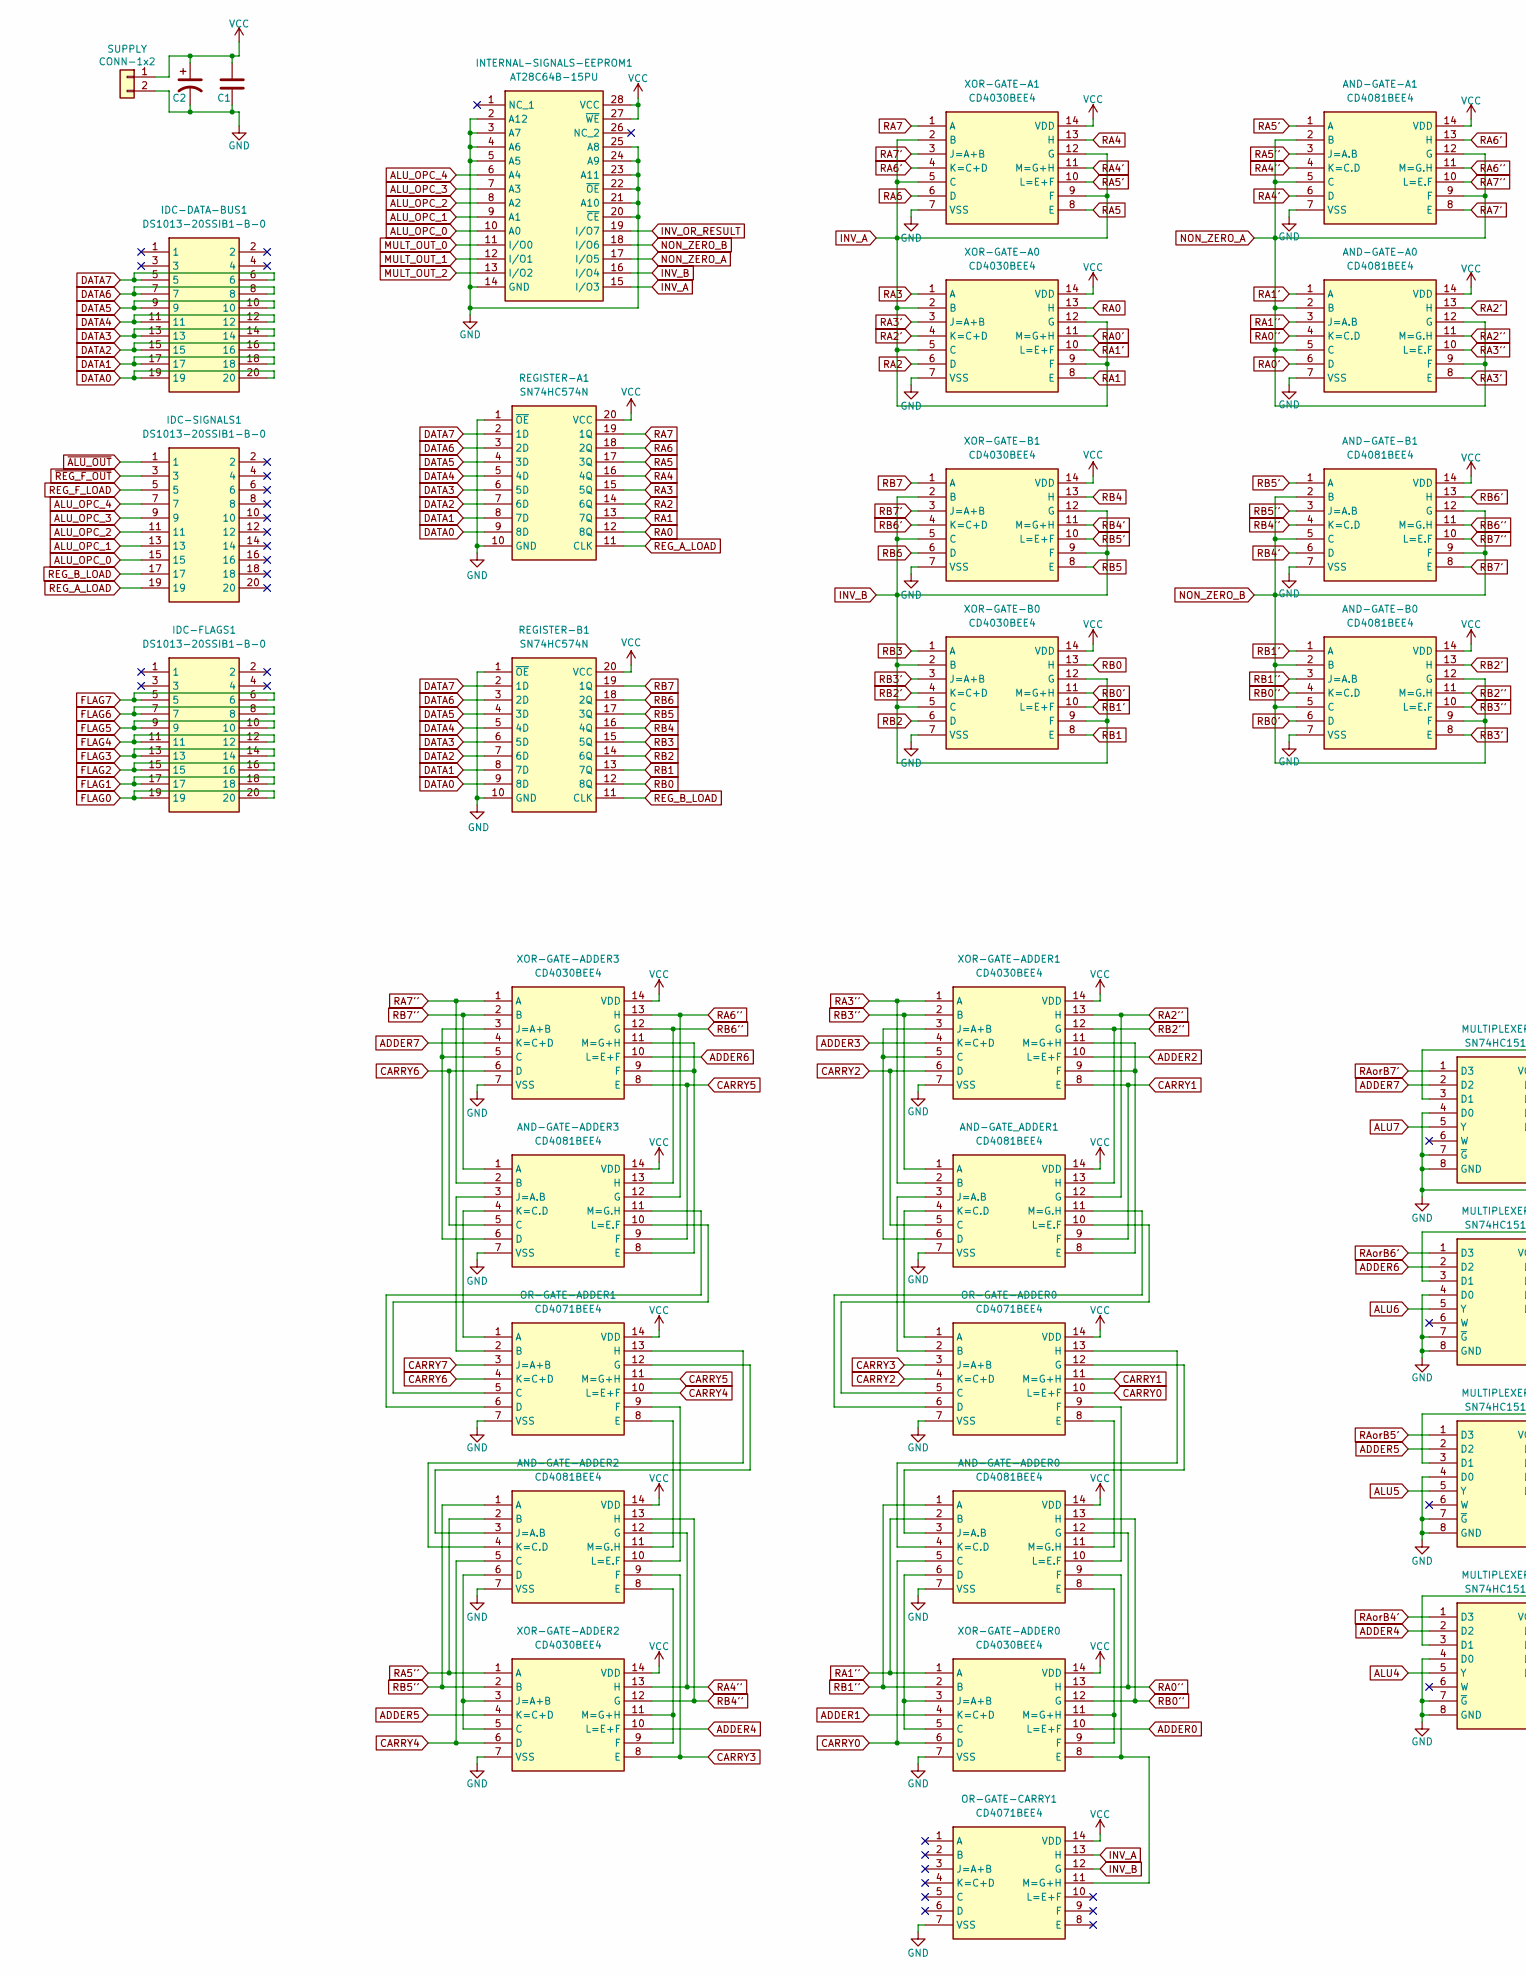
[picture p41: schematic final-alu.kicad_sch, part in row 1, column 1]

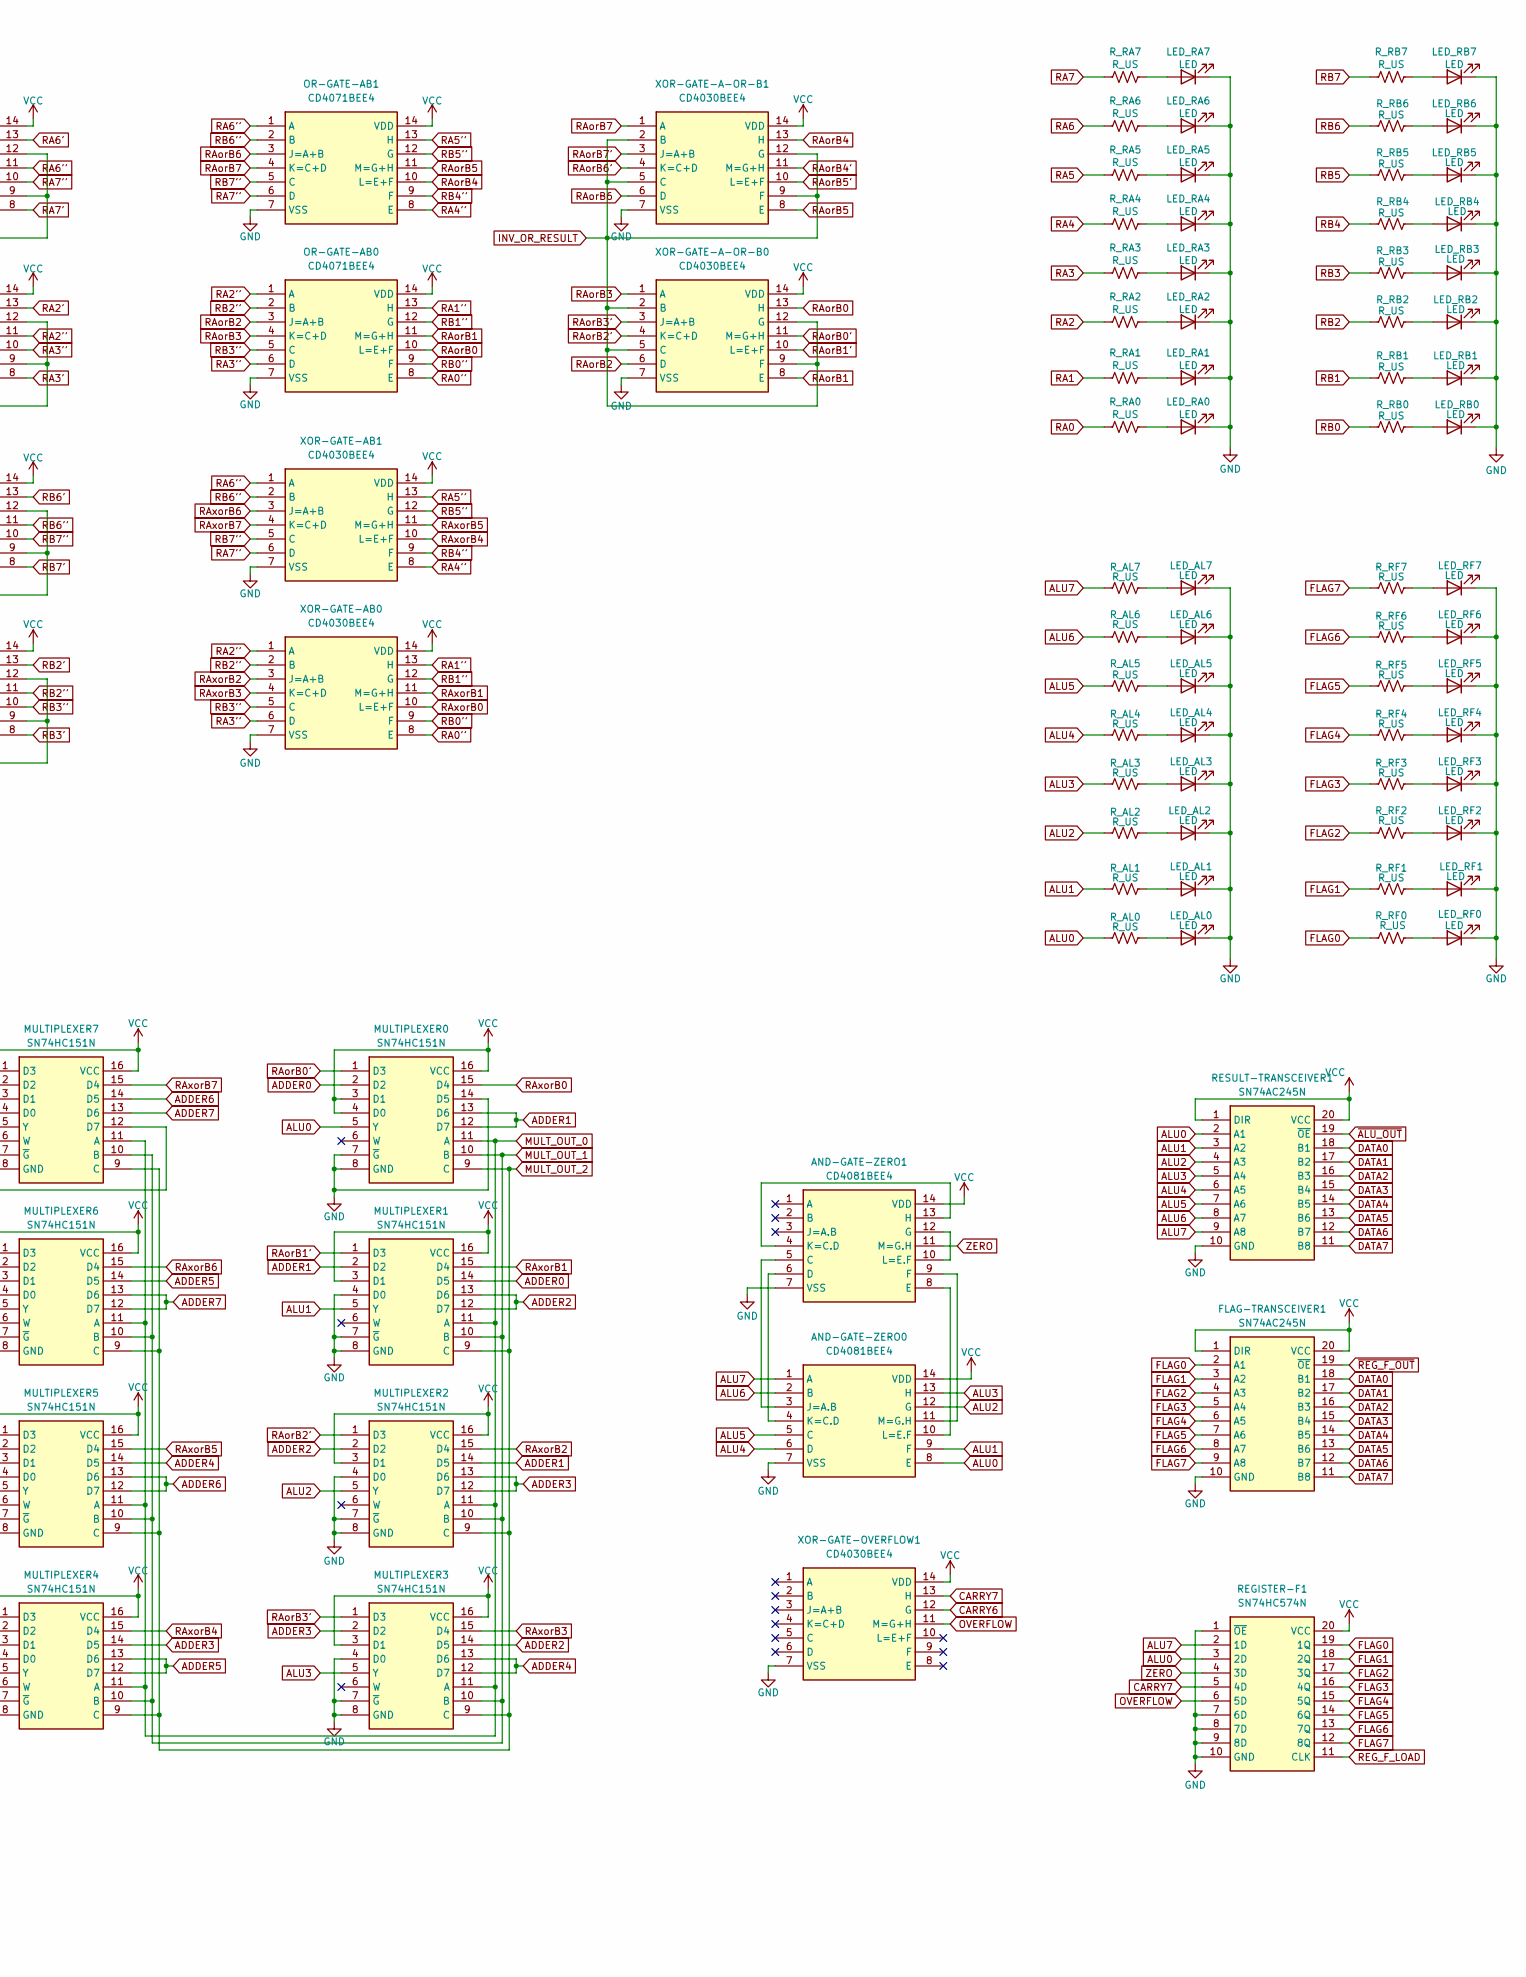
[picture p42: schematic final-alu.kicad_sch, part in row 1, column 2]

Parts:
AND-GATE-A0, AND-GATE-A1: CD4081BEE4; DIP-14_W7.62mm; Mouser Part Number 595-CD4081BEE4
AND-GATE-ADDER0, AND-GATE-ADDER2, AND-GATE-ADDER3: CD4081BEE4; DIP-14_W7.62mm; Mouser Part Number 595-CD4081BEE4
AND-GATE-B0, AND-GATE-B1: CD4081BEE4; DIP-14_W7.62mm; Mouser Part Number 595-CD4081BEE4
AND-GATE-ZERO0, AND-GATE-ZERO1: CD4081BEE4; DIP-14_W7.62mm; Mouser Part Number 595-CD4081BEE4
AND-GATE_ADDER1: CD4081BEE4; DIP-14_W7.62mm; Mouser Part Number 595-CD4081BEE4
C1: C_Disc_D3.0mm_W1.6mm_P2.50mm
C2: CP_Radial_D5.0mm_P2.50mm
FLAG-TRANSCEIVER1: SN74AC245N; DIP-20_W7.62mm; Mouser Part Number 595-SN74AC245N
IDC-DATA-BUS1: DS1013-20SSIB1-B-0; PinSocket_2x10_P2.54mm_Vertical; Manufacturer_Part_Number DS1013-20SSIB1-B-0
IDC-FLAGS1: DS1013-20SSIB1-B-0; PinSocket_2x10_P2.54mm_Vertical; Manufacturer_Part_Number DS1013-20SSIB1-B-0
IDC-SIGNALS1: DS1013-20SSIB1-B-0; PinSocket_2x10_P2.54mm_Vertical; Manufacturer_Part_Number DS1013-20SSIB1-B-0
INTERNAL-SIGNALS-EEPROM1: AT28C64B-15PU; DIP-28_W15.24mm; Mouser Part Number 556-AT28C64B15PU
LED_AL0, LED_AL1, LED_AL2, LED_AL3, LED_AL4, LED_AL5, LED_AL6, LED_AL7: LED; LED_D5.0mm_FlatTop
LED_RA0, LED_RA1, LED_RA2, LED_RA3, LED_RA4, LED_RA5, LED_RA6, LED_RA7: LED; LED_D5.0mm_FlatTop
LED_RB0, LED_RB1, LED_RB2, LED_RB3, LED_RB4, LED_RB5, LED_RB6, LED_RB7: LED; LED_D5.0mm_FlatTop
LED_RF0, LED_RF1, LED_RF2, LED_RF3, LED_RF4, LED_RF5, LED_RF6, LED_RF7: LED; LED_D5.0mm_FlatTop
MULTIPLEXER0, MULTIPLEXER1, MULTIPLEXER2, MULTIPLEXER3, MULTIPLEXER4, MULTIPLEXER5, MULTIPLEXER6, MULTIPLEXER7: SN74HC151N; DIP-16_W7.62mm; Mouser Part Number 595-SN74HC151N
OR-GATE-AB0, OR-GATE-AB1: CD4071BEE4; DIP-14_W7.62mm; Mouser Part Number 595-CD4071BEE4
OR-GATE-ADDER0, OR-GATE-ADDER1: CD4071BEE4; DIP-14_W7.62mm; Mouser Part Number 595-CD4071BEE4
OR-GATE-CARRY1: CD4071BEE4; DIP-14_W7.62mm; Mouser Part Number 595-CD4071BEE4
REGISTER-A1: SN74HC574N; DIP-20_W7.62mm; Mouser Part Number 595-SN74HC574N
REGISTER-B1: SN74HC574N; DIP-20_W7.62mm; Mouser Part Number 595-SN74HC574N
REGISTER-F1: SN74HC574N; DIP-20_W7.62mm; Mouser Part Number 595-SN74HC574N
RESULT-TRANSCEIVER1: SN74AC245N; DIP-20_W7.62mm; Mouser Part Number 595-SN74AC245N
R_AL0, R_AL1, R_AL2, R_AL3, R_AL4, R_AL5, R_AL6, R_AL7: R_US; R_Axial_DIN0204_L3.6mm_D1.6mm_P7.62mm_Horizontal
R_RA0, R_RA1, R_RA2, R_RA3, R_RA4, R_RA5, R_RA6, R_RA7: R_US; R_Axial_DIN0204_L3.6mm_D1.6mm_P7.62mm_Horizontal
R_RB0, R_RB1, R_RB2, R_RB3, R_RB4, R_RB5, R_RB6, R_RB7: R_US; R_Axial_DIN0204_L3.6mm_D1.6mm_P7.62mm_Horizontal
R_RF0, R_RF1, R_RF2, R_RF3, R_RF4, R_RF5, R_RF6, R_RF7: R_US; R_Axial_DIN0204_L3.6mm_D1.6mm_P7.62mm_Horizontal
SUPPLY: CONN-1x2; PinHeader_1x02_P2.54mm_Vertical
XOR-GATE-A0, XOR-GATE-A1: CD4030BEE4; DIP-14_W7.62mm; Mouser Part Number 595-CD4030BEE4
XOR-GATE-A-OR-B0, XOR-GATE-A-OR-B1: CD4030BEE4; DIP-14_W7.62mm; Mouser Part Number 595-CD4030BEE4
XOR-GATE-AB0, XOR-GATE-AB1: CD4030BEE4; DIP-14_W7.62mm; Mouser Part Number 595-CD4030BEE4
XOR-GATE-ADDER0, XOR-GATE-ADDER1, XOR-GATE-ADDER2, XOR-GATE-ADDER3: CD4030BEE4; DIP-14_W7.62mm; Mouser Part Number 595-CD4030BEE4
XOR-GATE-B0, XOR-GATE-B1: CD4030BEE4; DIP-14_W7.62mm; Mouser Part Number 595-CD4030BEE4
XOR-GATE-OVERFLOW1: CD4030BEE4; DIP-14_W7.62mm; Mouser Part Number 595-CD4030BEE4

Connections:
ADDER0: MULTIPLEXER0.2 (D2), MULTIPLEXER1.14 (D5), XOR-GATE-ADDER0.10 (L=E+F)
ADDER1: MULTIPLEXER0.12 (D7), MULTIPLEXER0.13 (D6), MULTIPLEXER1.2 (D2), MULTIPLEXER2.14 (D5), XOR-GATE-ADDER0.4 (K=C+D)
ADDER2: MULTIPLEXER1.12 (D7), MULTIPLEXER1.13 (D6), MULTIPLEXER2.2 (D2), MULTIPLEXER3.14 (D5), XOR-GATE-ADDER1.10 (L=E+F)
ADDER3: MULTIPLEXER2.12 (D7), MULTIPLEXER2.13 (D6), MULTIPLEXER3.2 (D2), MULTIPLEXER4.14 (D5), XOR-GATE-ADDER1.4 (K=C+D)
ADDER4: MULTIPLEXER3.12 (D7), MULTIPLEXER3.13 (D6), MULTIPLEXER4.2 (D2), MULTIPLEXER5.14 (D5), XOR-GATE-ADDER2.10 (L=E+F)
ADDER5: MULTIPLEXER4.12 (D7), MULTIPLEXER4.13 (D6), MULTIPLEXER5.2 (D2), MULTIPLEXER6.14 (D5), XOR-GATE-ADDER2.4 (K=C+D)
ADDER6: MULTIPLEXER5.12 (D7), MULTIPLEXER5.13 (D6), MULTIPLEXER6.2 (D2), MULTIPLEXER7.14 (D5), XOR-GATE-ADDER3.10 (L=E+F)
ADDER7: MULTIPLEXER6.12 (D7), MULTIPLEXER6.13 (D6), MULTIPLEXER7.2 (D2), MULTIPLEXER7.13 (D6), XOR-GATE-ADDER3.4 (K=C+D)
ALU0: AND-GATE-ZERO0.8 (E), MULTIPLEXER0.5 (Y), REGISTER-F1.3 (2D), RESULT-TRANSCEIVER1.2 (A1), R_AL0.1
ALU1: AND-GATE-ZERO0.9 (F), MULTIPLEXER1.5 (Y), RESULT-TRANSCEIVER1.3 (A2), R_AL1.1
ALU2: AND-GATE-ZERO0.12 (G), MULTIPLEXER2.5 (Y), RESULT-TRANSCEIVER1.4 (A3), R_AL2.1
ALU3: AND-GATE-ZERO0.13 (H), MULTIPLEXER3.5 (Y), RESULT-TRANSCEIVER1.5 (A4), R_AL3.1
ALU4: AND-GATE-ZERO0.6 (D), MULTIPLEXER4.5 (Y), RESULT-TRANSCEIVER1.6 (A5), R_AL4.1
ALU5: AND-GATE-ZERO0.5 (C), MULTIPLEXER5.5 (Y), RESULT-TRANSCEIVER1.7 (A6), R_AL5.1
ALU6: AND-GATE-ZERO0.2 (B), MULTIPLEXER6.5 (Y), RESULT-TRANSCEIVER1.8 (A7), R_AL6.1
ALU7: AND-GATE-ZERO0.1 (A), MULTIPLEXER7.5 (Y), REGISTER-F1.2 (1D), RESULT-TRANSCEIVER1.9 (A8), R_AL7.2
ALU_OPC_0: IDC-SIGNALS1.15, INTERNAL-SIGNALS-EEPROM1.10 (A0)
ALU_OPC_1: IDC-SIGNALS1.13, INTERNAL-SIGNALS-EEPROM1.9 (A1)
ALU_OPC_2: IDC-SIGNALS1.11, INTERNAL-SIGNALS-EEPROM1.8 (A2)
ALU_OPC_3: IDC-SIGNALS1.9, INTERNAL-SIGNALS-EEPROM1.7 (A3)
ALU_OPC_4: IDC-SIGNALS1.7, INTERNAL-SIGNALS-EEPROM1.6 (A4)
CARRY0: AND-GATE-ADDER0.5 (C), OR-GATE-ADDER0.10 (L=E+F), XOR-GATE-ADDER0.6 (D)
CARRY1: AND-GATE_ADDER1.9 (F), OR-GATE-ADDER0.11 (M=G+H), XOR-GATE-ADDER1.8 (E)
CARRY2: AND-GATE_ADDER1.5 (C), OR-GATE-ADDER0.4 (K=C+D), XOR-GATE-ADDER1.6 (D)
CARRY3: AND-GATE-ADDER2.9 (F), OR-GATE-ADDER0.3 (J=A+B), XOR-GATE-ADDER2.8 (E)
CARRY4: AND-GATE-ADDER2.5 (C), OR-GATE-ADDER1.10 (L=E+F), XOR-GATE-ADDER2.6 (D)
CARRY5: AND-GATE-ADDER3.9 (F), OR-GATE-ADDER1.11 (M=G+H), XOR-GATE-ADDER3.8 (E)
CARRY6: AND-GATE-ADDER3.5 (C), OR-GATE-ADDER1.4 (K=C+D), XOR-GATE-ADDER3.6 (D), XOR-GATE-OVERFLOW1.12 (G)
CARRY7: OR-GATE-ADDER1.3 (J=A+B), REGISTER-F1.5 (4D), XOR-GATE-OVERFLOW1.13 (H)
DATA0: FLAG-TRANSCEIVER1.18 (B1), IDC-DATA-BUS1.19, IDC-DATA-BUS1.20, REGISTER-A1.9 (8D), REGISTER-B1.9 (8D), RESULT-TRANSCEIVER1.18 (B1)
DATA1: FLAG-TRANSCEIVER1.17 (B2), IDC-DATA-BUS1.17, IDC-DATA-BUS1.18, REGISTER-A1.8 (7D), REGISTER-B1.8 (7D), RESULT-TRANSCEIVER1.17 (B2)
DATA2: FLAG-TRANSCEIVER1.16 (B3), IDC-DATA-BUS1.15, IDC-DATA-BUS1.16, REGISTER-A1.7 (6D), REGISTER-B1.7 (6D), RESULT-TRANSCEIVER1.16 (B3)
DATA3: FLAG-TRANSCEIVER1.15 (B4), IDC-DATA-BUS1.13, IDC-DATA-BUS1.14, REGISTER-A1.6 (5D), REGISTER-B1.6 (5D), RESULT-TRANSCEIVER1.15 (B4)
DATA4: FLAG-TRANSCEIVER1.14 (B5), IDC-DATA-BUS1.11, IDC-DATA-BUS1.12, REGISTER-A1.5 (4D), REGISTER-B1.5 (4D), RESULT-TRANSCEIVER1.14 (B5)
DATA5: FLAG-TRANSCEIVER1.13 (B6), IDC-DATA-BUS1.9, IDC-DATA-BUS1.10, REGISTER-A1.4 (3D), REGISTER-B1.4 (3D), RESULT-TRANSCEIVER1.13 (B6)
DATA6: FLAG-TRANSCEIVER1.12 (B7), IDC-DATA-BUS1.7, IDC-DATA-BUS1.8, REGISTER-A1.3 (2D), REGISTER-B1.3 (2D), RESULT-TRANSCEIVER1.12 (B7)
DATA7: FLAG-TRANSCEIVER1.11 (B8), IDC-DATA-BUS1.5, IDC-DATA-BUS1.6, REGISTER-A1.2 (1D), REGISTER-B1.2 (1D), RESULT-TRANSCEIVER1.11 (B8)
GND: AND-GATE-A0.7 (VSS), AND-GATE-A1.7 (VSS), AND-GATE-ADDER0.7 (VSS), AND-GATE-ADDER2.7 (VSS), AND-GATE-ADDER3.7 (VSS), AND-GATE-B0.7 (VSS), AND-GATE-B1.7 (VSS), AND-GATE-ZERO0.7 (VSS), AND-GATE-ZERO1.7 (VSS), AND-GATE_ADDER1.7 (VSS), C1.2, C2.2, FLAG-TRANSCEIVER1.10 (GND), INTERNAL-SIGNALS-EEPROM1.2 (A12), INTERNAL-SIGNALS-EEPROM1.3 (A7), INTERNAL-SIGNALS-EEPROM1.4 (A6), INTERNAL-SIGNALS-EEPROM1.5 (A5), INTERNAL-SIGNALS-EEPROM1.14 (GND), INTERNAL-SIGNALS-EEPROM1.20 (~CE), INTERNAL-SIGNALS-EEPROM1.21 (A10), INTERNAL-SIGNALS-EEPROM1.22 (~OE), INTERNAL-SIGNALS-EEPROM1.23 (A11), INTERNAL-SIGNALS-EEPROM1.24 (A9), INTERNAL-SIGNALS-EEPROM1.25 (A8), LED_AL0.1 (K), LED_AL1.1 (K), LED_AL2.1 (K), LED_AL3.1 (K), LED_AL4.1 (K), LED_AL5.1 (K), LED_AL6.1 (K), LED_AL7.1 (K), LED_RA0.1 (K), LED_RA1.1 (K), LED_RA2.1 (K), LED_RA3.1 (K), LED_RA4.1 (K), LED_RA5.1 (K), LED_RA6.1 (K), LED_RA7.1 (K), LED_RB0.1 (K), LED_RB1.1 (K), LED_RB2.1 (K), LED_RB3.1 (K), LED_RB4.1 (K), LED_RB5.1 (K), LED_RB6.1 (K), LED_RB7.1 (K), LED_RF0.1 (K), LED_RF1.1 (K), LED_RF2.1 (K), LED_RF3.1 (K), LED_RF4.1 (K), LED_RF5.1 (K), LED_RF6.1 (K), LED_RF7.1 (K), MULTIPLEXER0.7 (~G), MULTIPLEXER0.8 (GND), MULTIPLEXER0.14 (D5), MULTIPLEXER1.4 (D0), MULTIPLEXER1.7 (~G), MULTIPLEXER1.8 (GND), MULTIPLEXER2.4 (D0), MULTIPLEXER2.7 (~G), MULTIPLEXER2.8 (GND), MULTIPLEXER3.4 (D0), MULTIPLEXER3.7 (~G), MULTIPLEXER3.8 (GND), MULTIPLEXER4.4 (D0), MULTIPLEXER4.7 (~G), MULTIPLEXER4.8 (GND), MULTIPLEXER5.4 (D0), MULTIPLEXER5.7 (~G), MULTIPLEXER5.8 (GND), MULTIPLEXER6.4 (D0), MULTIPLEXER6.7 (~G), MULTIPLEXER6.8 (GND), MULTIPLEXER7.4 (D0), MULTIPLEXER7.7 (~G), MULTIPLEXER7.8 (GND), MULTIPLEXER7.12 (D7), OR-GATE-AB0.7 (VSS), OR-GATE-AB1.7 (VSS), OR-GATE-ADDER0.7 (VSS), OR-GATE-ADDER1.7 (VSS), OR-GATE-CARRY1.7 (VSS), REGISTER-A1.1 (~OE), REGISTER-A1.10 (GND), REGISTER-B1.1 (~OE), REGISTER-B1.10 (GND), REGISTER-F1.1 (~OE), REGISTER-F1.7 (6D), REGISTER-F1.8 (7D), REGISTER-F1.9 (8D), REGISTER-F1.10 (GND), RESULT-TRANSCEIVER1.10 (GND), SUPPLY.2, XOR-GATE-A0.7 (VSS), XOR-GATE-A1.7 (VSS), XOR-GATE-A-OR-B0.7 (VSS), XOR-GATE-A-OR-B1.7 (VSS), XOR-GATE-AB0.7 (VSS), XOR-GATE-AB1.7 (VSS), XOR-GATE-ADDER0.7 (VSS), XOR-GATE-ADDER1.7 (VSS), XOR-GATE-ADDER2.7 (VSS), XOR-GATE-ADDER3.7 (VSS), XOR-GATE-B0.7 (VSS), XOR-GATE-B1.7 (VSS), XOR-GATE-OVERFLOW1.7 (VSS); also elsewhere on the board
INV_A: INTERNAL-SIGNALS-EEPROM1.15 (I/O3), OR-GATE-CARRY1.13 (H), XOR-GATE-A0.2 (B), XOR-GATE-A0.5 (C), XOR-GATE-A0.9 (F), XOR-GATE-A0.12 (G), XOR-GATE-A1.2 (B), XOR-GATE-A1.5 (C), XOR-GATE-A1.9 (F), XOR-GATE-A1.12 (G)
INV_B: INTERNAL-SIGNALS-EEPROM1.16 (I/O4), OR-GATE-CARRY1.12 (G), XOR-GATE-B0.2 (B), XOR-GATE-B0.5 (C), XOR-GATE-B0.9 (F), XOR-GATE-B0.12 (G), XOR-GATE-B1.2 (B), XOR-GATE-B1.5 (C), XOR-GATE-B1.9 (F), XOR-GATE-B1.12 (G)
INV_OR_RESULT: INTERNAL-SIGNALS-EEPROM1.19 (I/O7), XOR-GATE-A-OR-B0.2 (B), XOR-GATE-A-OR-B0.5 (C), XOR-GATE-A-OR-B0.9 (F), XOR-GATE-A-OR-B0.12 (G), XOR-GATE-A-OR-B1.2 (B), XOR-GATE-A-OR-B1.5 (C), XOR-GATE-A-OR-B1.9 (F), XOR-GATE-A-OR-B1.12 (G)
MULT_OUT_0: INTERNAL-SIGNALS-EEPROM1.11 (I/O0), MULTIPLEXER0.11 (A), MULTIPLEXER1.11 (A), MULTIPLEXER2.11 (A), MULTIPLEXER3.11 (A), MULTIPLEXER4.11 (A), MULTIPLEXER5.11 (A), MULTIPLEXER6.11 (A), MULTIPLEXER7.11 (A)
MULT_OUT_1: INTERNAL-SIGNALS-EEPROM1.12 (I/O1), MULTIPLEXER0.10 (B), MULTIPLEXER1.10 (B), MULTIPLEXER2.10 (B), MULTIPLEXER3.10 (B), MULTIPLEXER4.10 (B), MULTIPLEXER5.10 (B), MULTIPLEXER6.10 (B), MULTIPLEXER7.10 (B)
MULT_OUT_2: INTERNAL-SIGNALS-EEPROM1.13 (I/O2), MULTIPLEXER0.9 (C), MULTIPLEXER1.9 (C), MULTIPLEXER2.9 (C), MULTIPLEXER3.9 (C), MULTIPLEXER4.9 (C), MULTIPLEXER5.9 (C), MULTIPLEXER6.9 (C), MULTIPLEXER7.9 (C)
NON_ZERO_A: AND-GATE-A0.2 (B), AND-GATE-A0.5 (C), AND-GATE-A0.9 (F), AND-GATE-A0.12 (G), AND-GATE-A1.2 (B), AND-GATE-A1.5 (C), AND-GATE-A1.9 (F), AND-GATE-A1.12 (G), INTERNAL-SIGNALS-EEPROM1.17 (I/O5)
NON_ZERO_B: AND-GATE-B0.2 (B), AND-GATE-B0.5 (C), AND-GATE-B0.9 (F), AND-GATE-B0.12 (G), AND-GATE-B1.2 (B), AND-GATE-B1.5 (C), AND-GATE-B1.9 (F), AND-GATE-B1.12 (G), INTERNAL-SIGNALS-EEPROM1.18 (I/O6)
unnamed: AND-GATE-ADDER0.6 (D), XOR-GATE-ADDER0.3 (J=A+B), XOR-GATE-ADDER0.5 (C)
unnamed: AND-GATE-ADDER0.8 (E), XOR-GATE-ADDER0.9 (F), XOR-GATE-ADDER0.11 (M=G+H)
unnamed: AND-GATE-ADDER0.9 (F), OR-GATE-CARRY1.11 (M=G+H), XOR-GATE-ADDER0.8 (E)
unnamed: AND-GATE-ADDER0.3 (J=A.B), OR-GATE-ADDER0.12 (G)
unnamed: AND-GATE-ADDER0.4 (K=C.D), OR-GATE-ADDER0.13 (H)
unnamed: AND-GATE-ADDER0.10 (L=E.F), OR-GATE-ADDER0.9 (F)
unnamed: AND-GATE-ADDER0.11 (M=G.H), OR-GATE-ADDER0.8 (E)
unnamed: AND-GATE-ADDER2.6 (D), XOR-GATE-ADDER2.3 (J=A+B), XOR-GATE-ADDER2.5 (C)
unnamed: AND-GATE-ADDER2.8 (E), XOR-GATE-ADDER2.9 (F), XOR-GATE-ADDER2.11 (M=G+H)
unnamed: AND-GATE-ADDER2.3 (J=A.B), OR-GATE-ADDER1.12 (G)
unnamed: AND-GATE-ADDER2.4 (K=C.D), OR-GATE-ADDER1.13 (H)
unnamed: AND-GATE-ADDER2.10 (L=E.F), OR-GATE-ADDER1.9 (F)
unnamed: AND-GATE-ADDER2.11 (M=G.H), OR-GATE-ADDER1.8 (E)
unnamed: AND-GATE-ADDER3.6 (D), XOR-GATE-ADDER3.3 (J=A+B), XOR-GATE-ADDER3.5 (C)
unnamed: AND-GATE-ADDER3.8 (E), XOR-GATE-ADDER3.9 (F), XOR-GATE-ADDER3.11 (M=G+H)
unnamed: AND-GATE-ADDER3.3 (J=A.B), OR-GATE-ADDER1.2 (B)
unnamed: AND-GATE-ADDER3.4 (K=C.D), OR-GATE-ADDER1.1 (A)
unnamed: AND-GATE-ADDER3.10 (L=E.F), OR-GATE-ADDER1.5 (C)
unnamed: AND-GATE-ADDER3.11 (M=G.H), OR-GATE-ADDER1.6 (D)
unnamed: AND-GATE-ZERO0.3 (J=A.B), AND-GATE-ZERO1.5 (C)
unnamed: AND-GATE-ZERO0.4 (K=C.D), AND-GATE-ZERO1.6 (D)
unnamed: AND-GATE-ZERO0.10 (L=E.F), AND-GATE-ZERO1.8 (E)
unnamed: AND-GATE-ZERO0.11 (M=G.H), AND-GATE-ZERO1.9 (F)
unnamed: AND-GATE-ZERO1.10 (L=E.F), AND-GATE-ZERO1.12 (G)
unnamed: AND-GATE-ZERO1.4 (K=C.D), AND-GATE-ZERO1.13 (H)
unnamed: AND-GATE_ADDER1.6 (D), XOR-GATE-ADDER1.3 (J=A+B), XOR-GATE-ADDER1.5 (C)
unnamed: AND-GATE_ADDER1.8 (E), XOR-GATE-ADDER1.9 (F), XOR-GATE-ADDER1.11 (M=G+H)
unnamed: AND-GATE_ADDER1.3 (J=A.B), OR-GATE-ADDER0.2 (B)
unnamed: AND-GATE_ADDER1.4 (K=C.D), OR-GATE-ADDER0.1 (A)
unnamed: AND-GATE_ADDER1.10 (L=E.F), OR-GATE-ADDER0.5 (C)
unnamed: AND-GATE_ADDER1.11 (M=G.H), OR-GATE-ADDER0.6 (D)
unnamed: LED_AL0.2 (A), R_AL0.2
unnamed: LED_AL1.2 (A), R_AL1.2
unnamed: LED_AL2.2 (A), R_AL2.2
unnamed: LED_AL3.2 (A), R_AL3.2
unnamed: LED_AL4.2 (A), R_AL4.2
unnamed: LED_AL5.2 (A), R_AL5.2
unnamed: LED_AL6.2 (A), R_AL6.2
unnamed: LED_AL7.2 (A), R_AL7.1
unnamed: LED_RA0.2 (A), R_RA0.2
unnamed: LED_RA1.2 (A), R_RA1.2
unnamed: LED_RA2.2 (A), R_RA2.2
unnamed: LED_RA3.2 (A), R_RA3.2
unnamed: LED_RA4.2 (A), R_RA4.2
unnamed: LED_RA5.2 (A), R_RA5.2
unnamed: LED_RA6.2 (A), R_RA6.2
unnamed: LED_RA7.2 (A), R_RA7.2
unnamed: LED_RB0.2 (A), R_RB0.2
unnamed: LED_RB1.2 (A), R_RB1.2
unnamed: LED_RB2.2 (A), R_RB2.2
unnamed: LED_RB3.2 (A), R_RB3.2
unnamed: LED_RB4.2 (A), R_RB4.2
unnamed: LED_RB5.2 (A), R_RB5.2
unnamed: LED_RB6.2 (A), R_RB6.2
unnamed: LED_RB7.2 (A), R_RB7.2
unnamed: LED_RF0.2 (A), R_RF0.2
unnamed: LED_RF1.2 (A), R_RF1.2
unnamed: LED_RF2.2 (A), R_RF2.2
unnamed: LED_RF3.2 (A), R_RF3.2
unnamed: LED_RF4.2 (A), R_RF4.1
unnamed: LED_RF5.2 (A), R_RF5.2
unnamed: LED_RF6.2 (A), R_RF6.1
unnamed: LED_RF7.2 (A), R_RF7.2
OVERFLOW: REGISTER-F1.6 (5D), XOR-GATE-OVERFLOW1.11 (M=G+H)
RA0: REGISTER-A1.12 (8Q), R_RA0.1, XOR-GATE-A0.13 (H)
RA0': AND-GATE-A0.6 (D), XOR-GATE-A0.11 (M=G+H)
RA0'': AND-GATE-A0.4 (K=C.D), AND-GATE-ADDER0.12 (G), OR-GATE-AB0.8 (E), XOR-GATE-AB0.8 (E), XOR-GATE-ADDER0.13 (H)
RA1: REGISTER-A1.13 (7Q), R_RA1.1, XOR-GATE-A0.8 (E)
RA1': AND-GATE-A0.1 (A), XOR-GATE-A0.10 (L=E+F)
RA1'': AND-GATE-A0.3 (J=A.B), AND-GATE-ADDER0.2 (B), OR-GATE-AB0.13 (H), XOR-GATE-AB0.13 (H), XOR-GATE-ADDER0.1 (A)
RA2: REGISTER-A1.14 (6Q), R_RA2.1, XOR-GATE-A0.6 (D)
RA2': AND-GATE-A0.13 (H), XOR-GATE-A0.4 (K=C+D)
RA2'': AND-GATE-A0.11 (M=G.H), AND-GATE_ADDER1.12 (G), OR-GATE-AB0.1 (A), XOR-GATE-AB0.1 (A), XOR-GATE-ADDER1.13 (H)
RA3: REGISTER-A1.15 (5Q), R_RA3.1, XOR-GATE-A0.1 (A)
RA3': AND-GATE-A0.8 (E), XOR-GATE-A0.3 (J=A+B)
RA3'': AND-GATE-A0.10 (L=E.F), AND-GATE_ADDER1.2 (B), OR-GATE-AB0.6 (D), XOR-GATE-AB0.6 (D), XOR-GATE-ADDER1.1 (A)
RA4: REGISTER-A1.16 (4Q), R_RA4.1, XOR-GATE-A1.13 (H)
RA4': AND-GATE-A1.6 (D), XOR-GATE-A1.11 (M=G+H)
RA4'': AND-GATE-A1.4 (K=C.D), AND-GATE-ADDER2.12 (G), OR-GATE-AB1.8 (E), XOR-GATE-AB1.8 (E), XOR-GATE-ADDER2.13 (H)
RA5: REGISTER-A1.17 (3Q), R_RA5.1, XOR-GATE-A1.8 (E)
RA5': AND-GATE-A1.1 (A), XOR-GATE-A1.10 (L=E+F)
RA5'': AND-GATE-A1.3 (J=A.B), AND-GATE-ADDER2.2 (B), OR-GATE-AB1.13 (H), XOR-GATE-AB1.13 (H), XOR-GATE-ADDER2.1 (A)
RA6: REGISTER-A1.18 (2Q), R_RA6.1, XOR-GATE-A1.6 (D)
RA6': AND-GATE-A1.13 (H), XOR-GATE-A1.4 (K=C+D)
RA6'': AND-GATE-A1.11 (M=G.H), AND-GATE-ADDER3.12 (G), OR-GATE-AB1.1 (A), XOR-GATE-AB1.1 (A), XOR-GATE-ADDER3.13 (H)
RA7: REGISTER-A1.19 (1Q), R_RA7.1, XOR-GATE-A1.1 (A)
RA7': AND-GATE-A1.8 (E), XOR-GATE-A1.3 (J=A+B)
RA7'': AND-GATE-A1.10 (L=E.F), AND-GATE-ADDER3.2 (B), OR-GATE-AB1.6 (D), XOR-GATE-AB1.6 (D), XOR-GATE-ADDER3.1 (A)
RAorB0: OR-GATE-AB0.10 (L=E+F), XOR-GATE-A-OR-B0.13 (H)
RAorB0': MULTIPLEXER0.1 (D3), XOR-GATE-A-OR-B0.11 (M=G+H)
RAorB1: OR-GATE-AB0.11 (M=G+H), XOR-GATE-A-OR-B0.8 (E)
RAorB1': MULTIPLEXER1.1 (D3), XOR-GATE-A-OR-B0.10 (L=E+F)
RAorB2: OR-GATE-AB0.3 (J=A+B), XOR-GATE-A-OR-B0.6 (D)
RAorB2': MULTIPLEXER2.1 (D3), XOR-GATE-A-OR-B0.4 (K=C+D)
RAorB3: OR-GATE-AB0.4 (K=C+D), XOR-GATE-A-OR-B0.1 (A)
RAorB3': MULTIPLEXER3.1 (D3), XOR-GATE-A-OR-B0.3 (J=A+B)
RAorB4: OR-GATE-AB1.10 (L=E+F), XOR-GATE-A-OR-B1.13 (H)
RAorB4': MULTIPLEXER4.1 (D3), XOR-GATE-A-OR-B1.11 (M=G+H)
RAorB5: OR-GATE-AB1.11 (M=G+H), XOR-GATE-A-OR-B1.8 (E)
RAorB5': MULTIPLEXER5.1 (D3), XOR-GATE-A-OR-B1.10 (L=E+F)
RAorB6: OR-GATE-AB1.3 (J=A+B), XOR-GATE-A-OR-B1.6 (D)
RAorB6': MULTIPLEXER6.1 (D3), XOR-GATE-A-OR-B1.4 (K=C+D)
RAorB7: OR-GATE-AB1.4 (K=C+D), XOR-GATE-A-OR-B1.1 (A)
RAorB7': MULTIPLEXER7.1 (D3), XOR-GATE-A-OR-B1.3 (J=A+B)
RAxorB0: MULTIPLEXER0.15 (D4), XOR-GATE-AB0.10 (L=E+F)
RAxorB1: MULTIPLEXER1.15 (D4), XOR-GATE-AB0.11 (M=G+H)
RAxorB2: MULTIPLEXER2.15 (D4), XOR-GATE-AB0.3 (J=A+B)
RAxorB3: MULTIPLEXER3.15 (D4), XOR-GATE-AB0.4 (K=C+D)
RAxorB4: MULTIPLEXER4.15 (D4), XOR-GATE-AB1.10 (L=E+F)
RAxorB5: MULTIPLEXER5.15 (D4), XOR-GATE-AB1.11 (M=G+H)
RAxorB6: MULTIPLEXER6.15 (D4), XOR-GATE-AB1.3 (J=A+B)
RAxorB7: MULTIPLEXER7.15 (D4), XOR-GATE-AB1.4 (K=C+D)
RB0: REGISTER-B1.12 (8Q), R_RB0.1, XOR-GATE-B0.13 (H)
RB0': AND-GATE-B0.6 (D), XOR-GATE-B0.11 (M=G+H)
RB0'': AND-GATE-ADDER0.13 (H), AND-GATE-B0.4 (K=C.D), OR-GATE-AB0.9 (F), XOR-GATE-AB0.9 (F), XOR-GATE-ADDER0.12 (G)
RB1: REGISTER-B1.13 (7Q), R_RB1.1, XOR-GATE-B0.8 (E)
RB1': AND-GATE-B0.1 (A), XOR-GATE-B0.10 (L=E+F)
RB1'': AND-GATE-ADDER0.1 (A), AND-GATE-B0.3 (J=A.B), OR-GATE-AB0.12 (G), XOR-GATE-AB0.12 (G), XOR-GATE-ADDER0.2 (B)
RB2: REGISTER-B1.14 (6Q), R_RB2.1, XOR-GATE-B0.6 (D)
RB2': AND-GATE-B0.13 (H), XOR-GATE-B0.4 (K=C+D)
RB2'': AND-GATE-B0.11 (M=G.H), AND-GATE_ADDER1.13 (H), OR-GATE-AB0.2 (B), XOR-GATE-AB0.2 (B), XOR-GATE-ADDER1.12 (G)
RB3: REGISTER-B1.15 (5Q), R_RB3.1, XOR-GATE-B0.1 (A)
RB3': AND-GATE-B0.8 (E), XOR-GATE-B0.3 (J=A+B)
RB3'': AND-GATE-B0.10 (L=E.F), AND-GATE_ADDER1.1 (A), OR-GATE-AB0.5 (C), XOR-GATE-AB0.5 (C), XOR-GATE-ADDER1.2 (B)
RB4: REGISTER-B1.16 (4Q), R_RB4.1, XOR-GATE-B1.13 (H)
RB4': AND-GATE-B1.6 (D), XOR-GATE-B1.11 (M=G+H)
RB4'': AND-GATE-ADDER2.13 (H), AND-GATE-B1.4 (K=C.D), OR-GATE-AB1.9 (F), XOR-GATE-AB1.9 (F), XOR-GATE-ADDER2.12 (G)
RB5: REGISTER-B1.17 (3Q), R_RB5.1, XOR-GATE-B1.8 (E)
RB5': AND-GATE-B1.1 (A), XOR-GATE-B1.10 (L=E+F)
RB5'': AND-GATE-ADDER2.1 (A), AND-GATE-B1.3 (J=A.B), OR-GATE-AB1.12 (G), XOR-GATE-AB1.12 (G), XOR-GATE-ADDER2.2 (B)
RB6: REGISTER-B1.18 (2Q), R_RB6.1, XOR-GATE-B1.6 (D)
RB6': AND-GATE-B1.13 (H), XOR-GATE-B1.4 (K=C+D)
RB6'': AND-GATE-ADDER3.13 (H), AND-GATE-B1.11 (M=G.H), OR-GATE-AB1.2 (B), XOR-GATE-AB1.2 (B), XOR-GATE-ADDER3.12 (G)
RB7: REGISTER-B1.19 (1Q), R_RB7.1, XOR-GATE-B1.1 (A)
RB7': AND-GATE-B1.8 (E), XOR-GATE-B1.3 (J=A+B)
RB7'': AND-GATE-ADDER3.1 (A), AND-GATE-B1.10 (L=E.F), OR-GATE-AB1.5 (C), XOR-GATE-AB1.5 (C), XOR-GATE-ADDER3.2 (B)
REG_A_LOAD: IDC-SIGNALS1.19, REGISTER-A1.11 (CLK)
REG_B_LOAD: IDC-SIGNALS1.17, REGISTER-B1.11 (CLK)
REG_F_LOAD: IDC-SIGNALS1.5, REGISTER-F1.11 (CLK)
VCC: AND-GATE-A0.14 (VDD), AND-GATE-A1.14 (VDD), AND-GATE-ADDER0.14 (VDD), AND-GATE-ADDER2.14 (VDD), AND-GATE-ADDER3.14 (VDD), AND-GATE-B0.14 (VDD), AND-GATE-B1.14 (VDD), AND-GATE-ZERO0.14 (VDD), AND-GATE-ZERO1.14 (VDD), AND-GATE_ADDER1.14 (VDD), C1.1, C2.1, FLAG-TRANSCEIVER1.1 (DIR), FLAG-TRANSCEIVER1.20 (VCC), INTERNAL-SIGNALS-EEPROM1.27 (~WE), INTERNAL-SIGNALS-EEPROM1.28 (VCC), MULTIPLEXER0.3 (D1), MULTIPLEXER0.4 (D0), MULTIPLEXER0.16 (VCC), MULTIPLEXER1.3 (D1), MULTIPLEXER1.16 (VCC), MULTIPLEXER2.3 (D1), MULTIPLEXER2.16 (VCC), MULTIPLEXER3.3 (D1), MULTIPLEXER3.16 (VCC), MULTIPLEXER4.3 (D1), MULTIPLEXER4.16 (VCC), MULTIPLEXER5.3 (D1), MULTIPLEXER5.16 (VCC), MULTIPLEXER6.3 (D1), MULTIPLEXER6.16 (VCC), MULTIPLEXER7.3 (D1), MULTIPLEXER7.16 (VCC), OR-GATE-AB0.14 (VDD), OR-GATE-AB1.14 (VDD), OR-GATE-ADDER0.14 (VDD), OR-GATE-ADDER1.14 (VDD), OR-GATE-CARRY1.14 (VDD), REGISTER-A1.20 (VCC), REGISTER-B1.20 (VCC), REGISTER-F1.20 (VCC), RESULT-TRANSCEIVER1.1 (DIR), RESULT-TRANSCEIVER1.20 (VCC), SUPPLY.1, XOR-GATE-A0.14 (VDD), XOR-GATE-A1.14 (VDD), XOR-GATE-A-OR-B0.14 (VDD), XOR-GATE-A-OR-B1.14 (VDD), XOR-GATE-AB0.14 (VDD), XOR-GATE-AB1.14 (VDD), XOR-GATE-ADDER0.14 (VDD), XOR-GATE-ADDER1.14 (VDD), XOR-GATE-ADDER2.14 (VDD), XOR-GATE-ADDER3.14 (VDD), XOR-GATE-B0.14 (VDD), XOR-GATE-B1.14 (VDD), XOR-GATE-OVERFLOW1.14 (VDD); also elsewhere on the board
ZERO: AND-GATE-ZERO1.11 (M=G.H), REGISTER-F1.4 (3D)
~ALU_OUT: IDC-SIGNALS1.1, RESULT-TRANSCEIVER1.19 (~OE)
~REG_F_OUT: FLAG-TRANSCEIVER1.19 (~OE), IDC-SIGNALS1.3

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
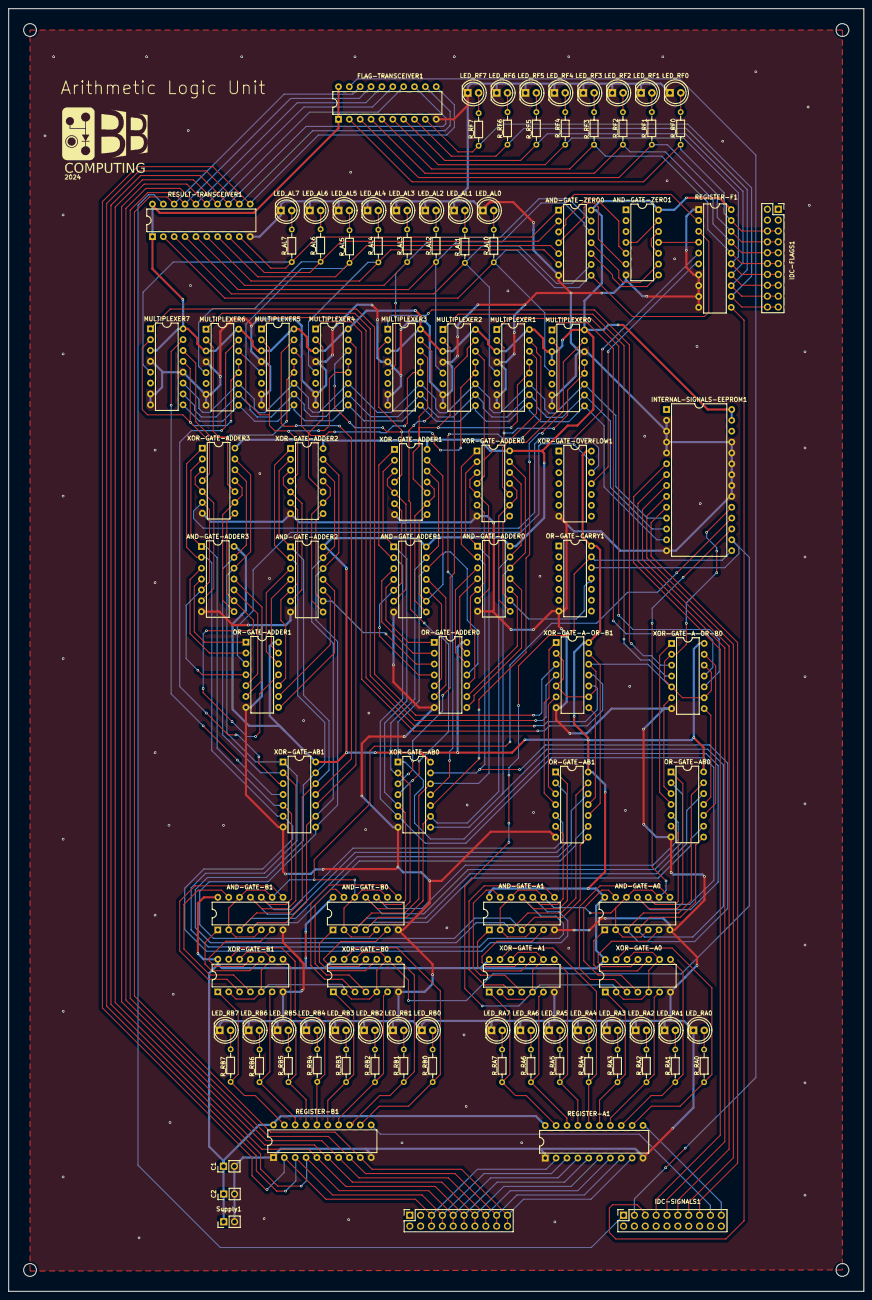
[picture p43: board final-alu.kicad_pcb from above]

Board: 2 copper layers, 200.0 x 300.0 mm, 112 parts (0 on the bottom side), 197 nets.

Other parts of the board:
Supply1: Conn2; PinHeader_1x02_P2.54mm_Vertical

Their connections:
GND: Supply1.2; also elsewhere on the board
VCC: Supply1.1; also elsewhere on the board
