KN-Breadboard-Computing/computer/schematics/final-cu/final-cu.kicad_pcb

## KiCad design schematics/final-cu/final-cu.kicad_pcb (2024-05-09)

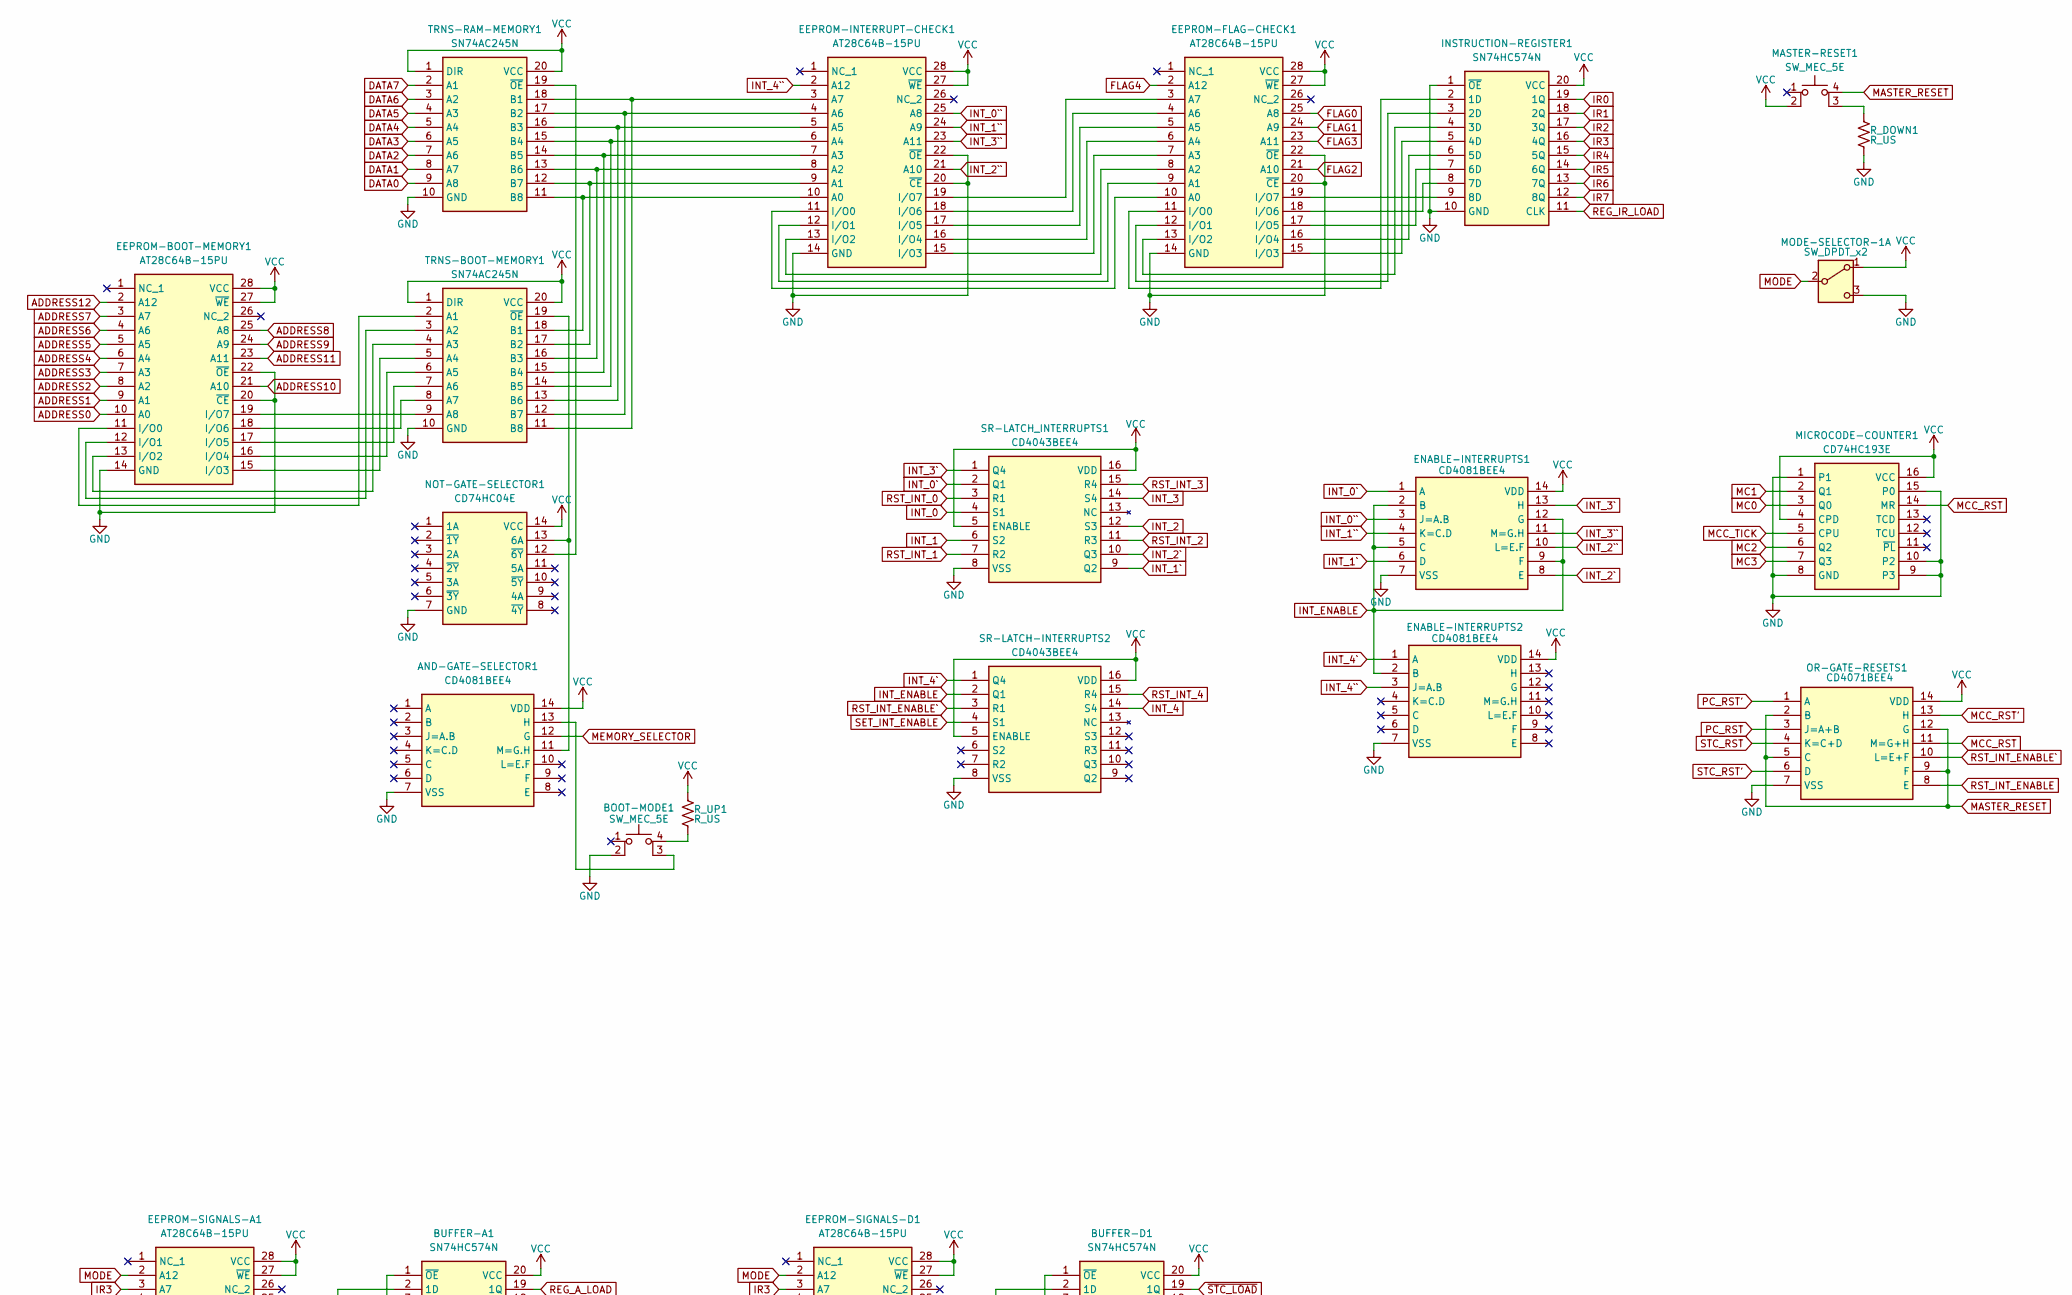
[picture p44: schematic final-cu.kicad_sch, part in row 1, column 1]

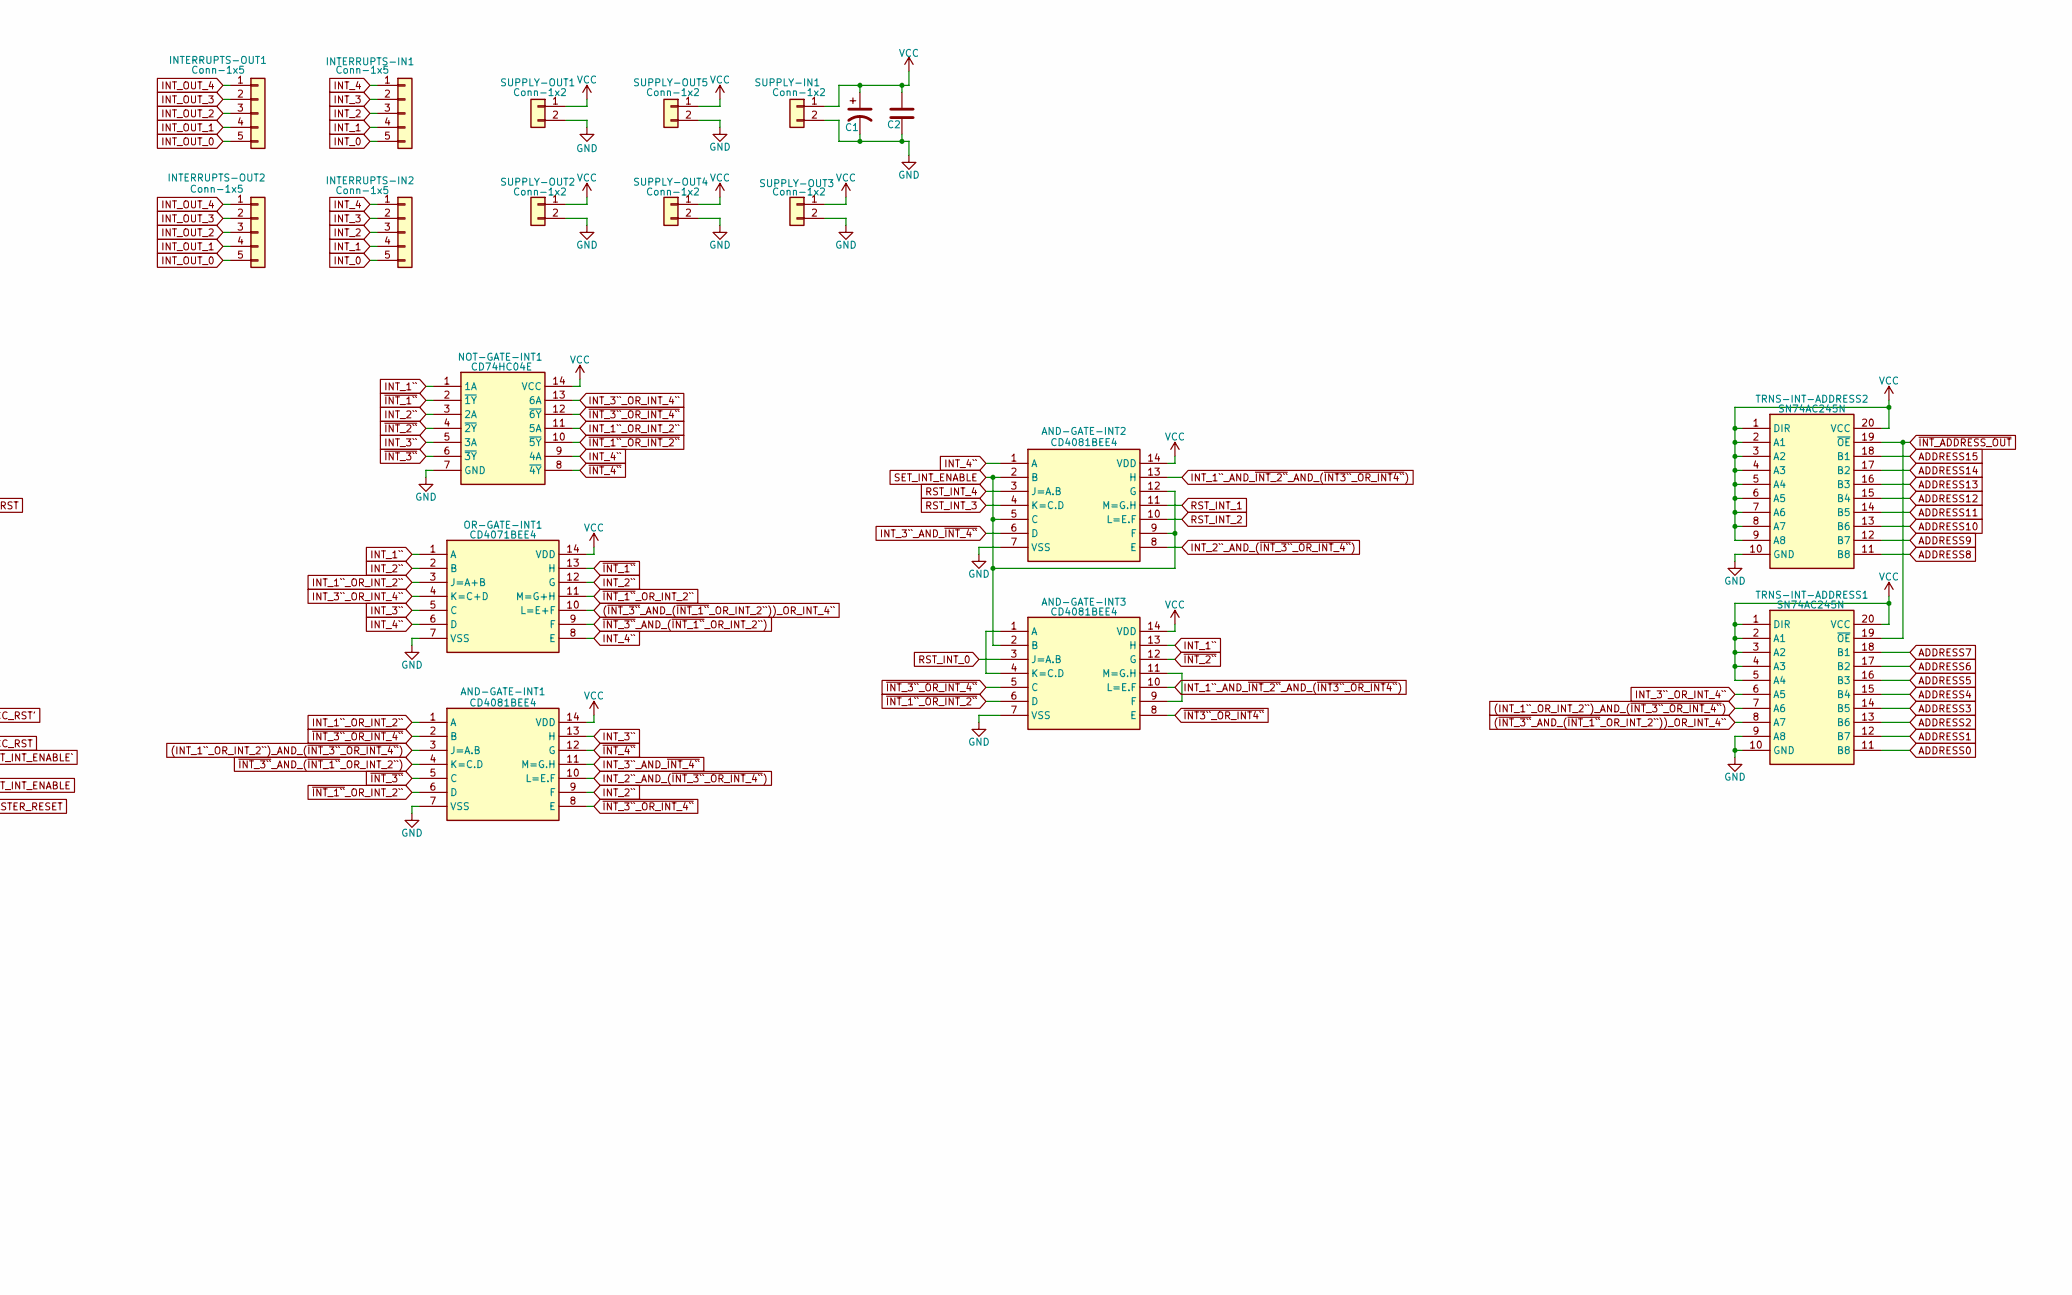
[picture p45: schematic final-cu.kicad_sch, part in row 1, column 2]

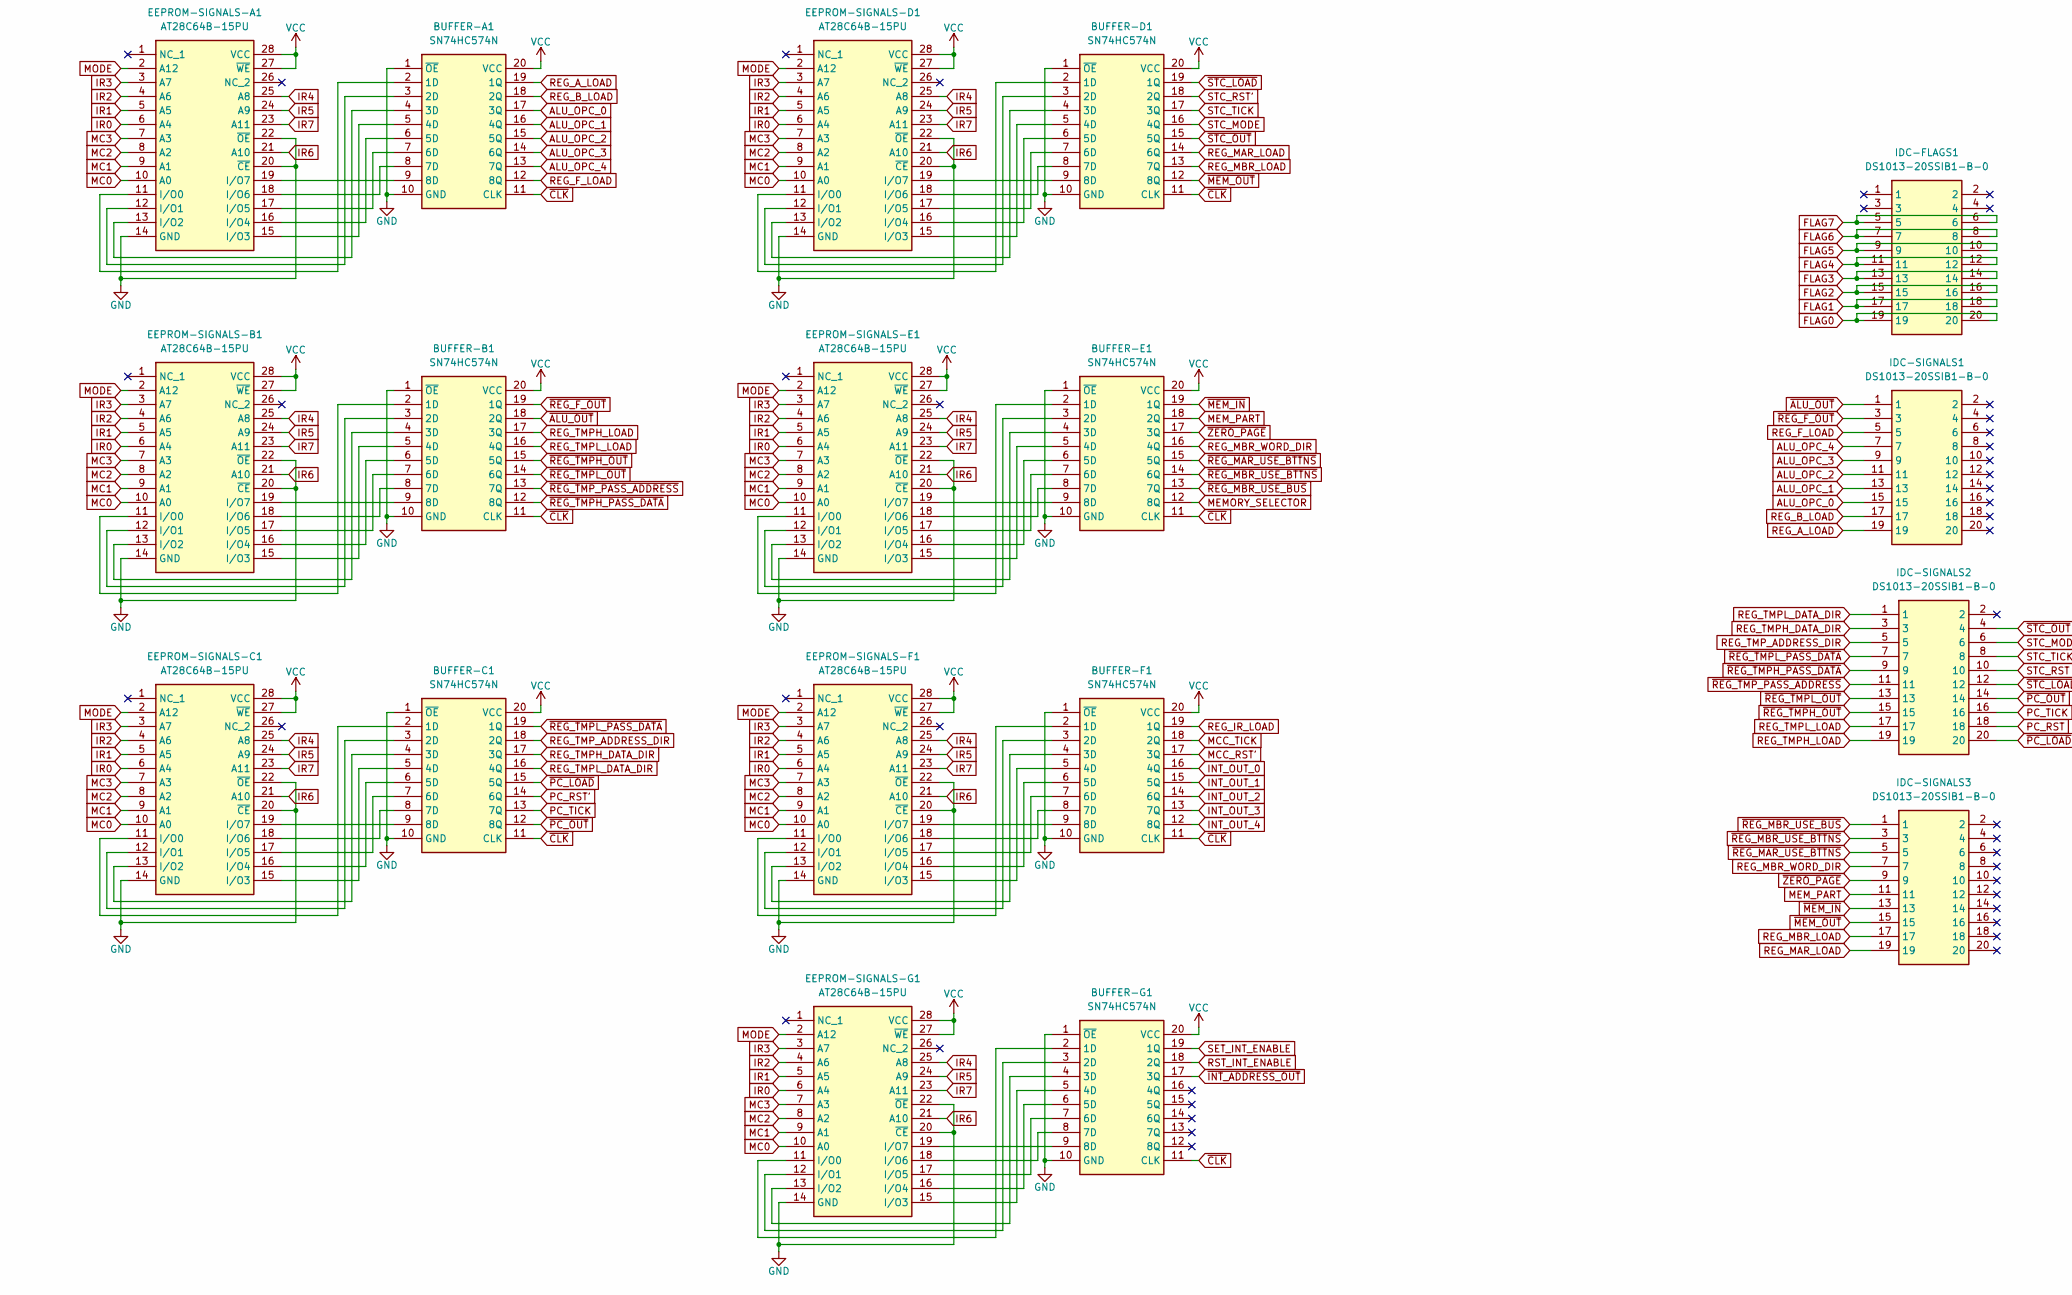
[picture p46: schematic final-cu.kicad_sch, part in row 2, column 1]

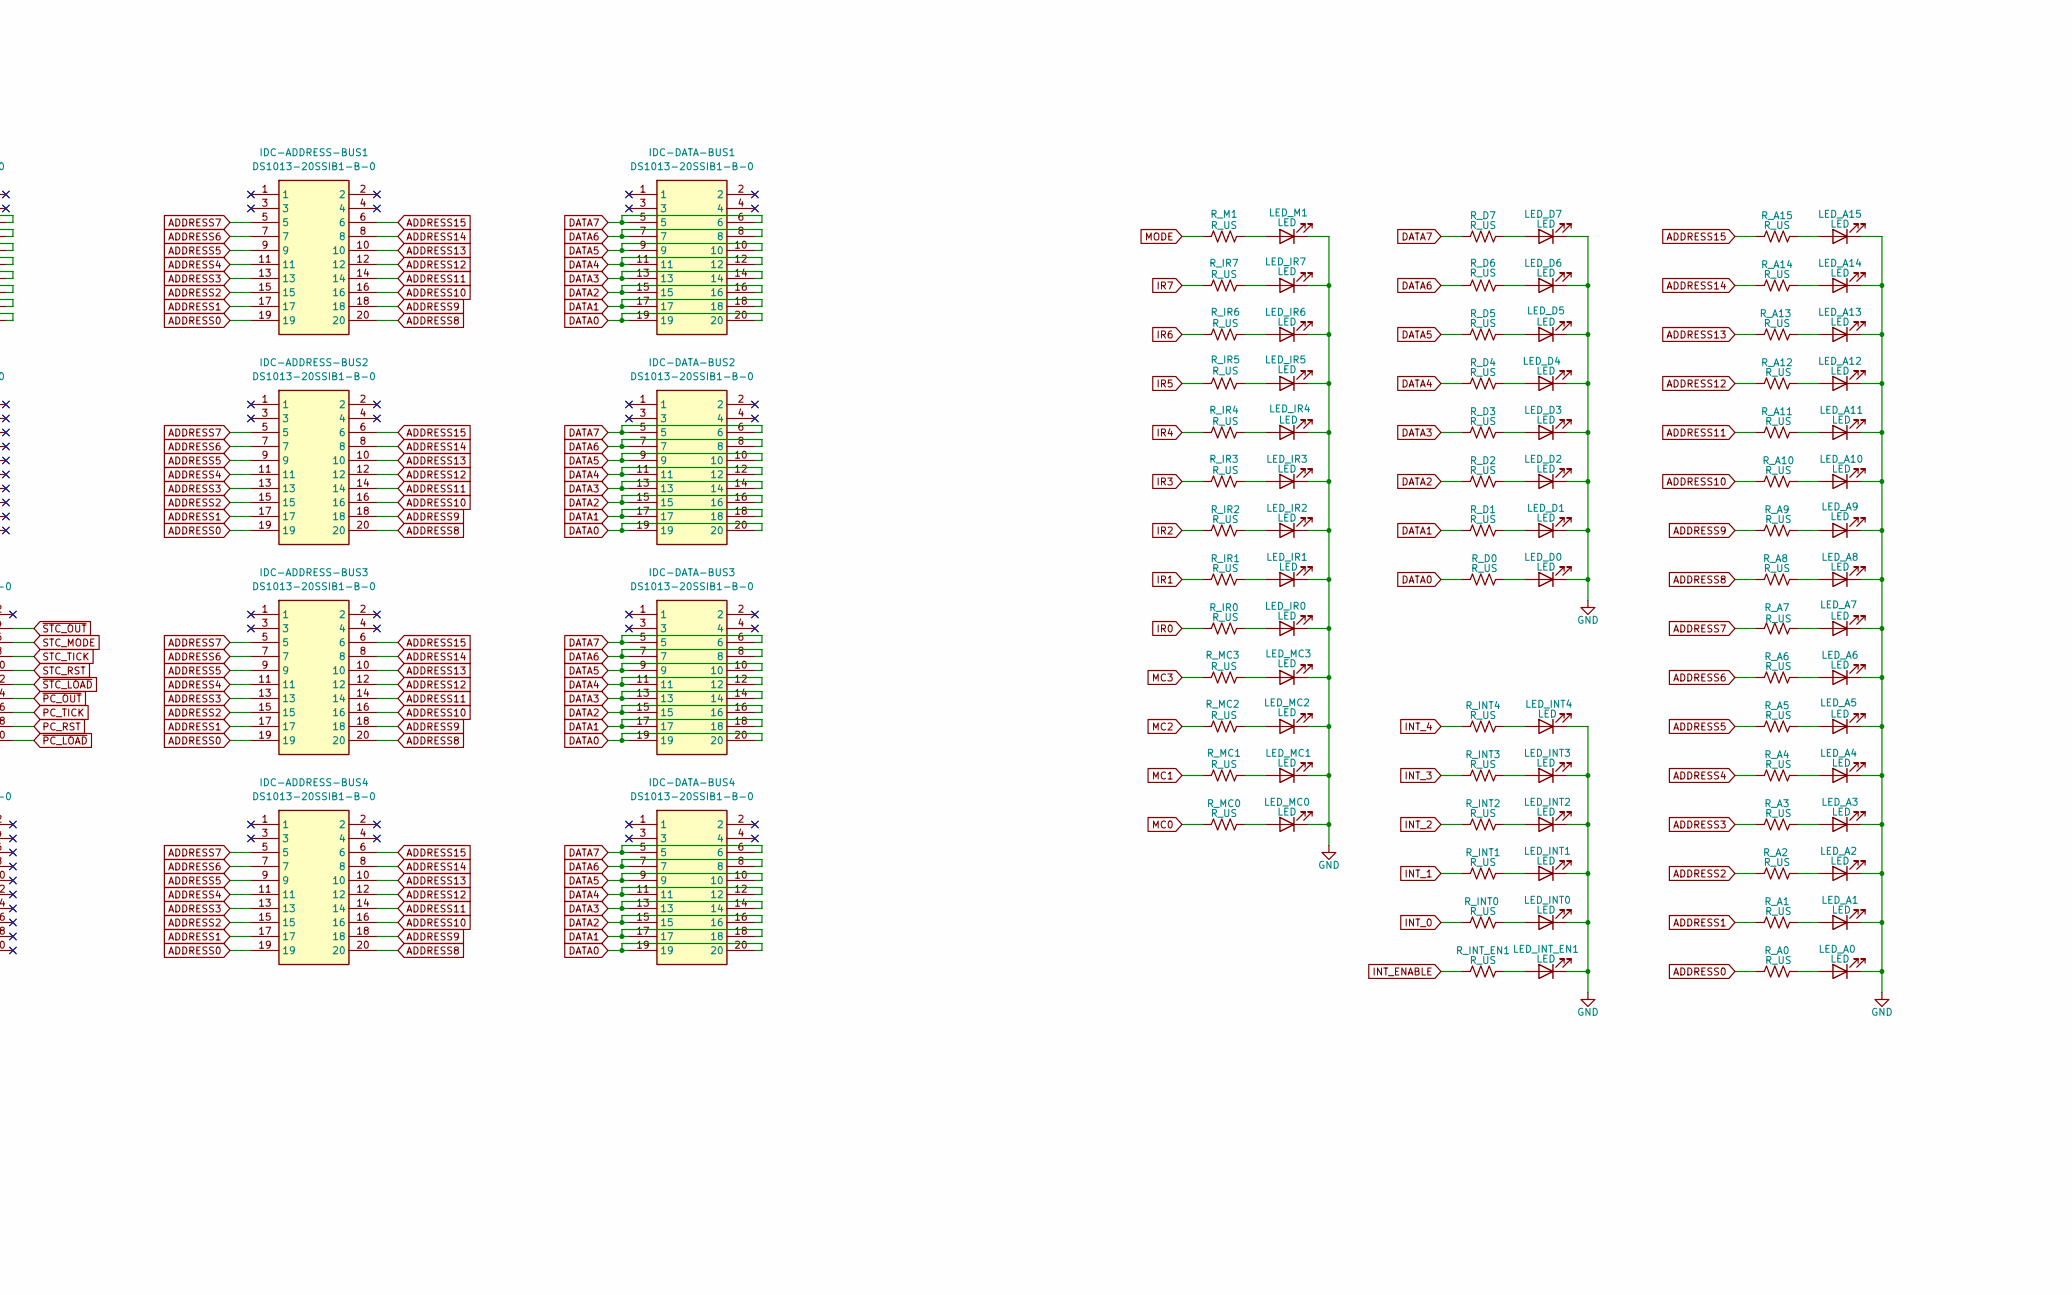
[picture p47: schematic final-cu.kicad_sch, part in row 2, column 2]

Parts:
AND-GATE-INT1, AND-GATE-INT2, AND-GATE-INT3: CD4081BEE4; DIP-14_W7.62mm; Mouser Part Number 595-CD4081BEE4
AND-GATE-SELECTOR1: CD4081BEE4; DIP-14_W7.62mm; Mouser Part Number 595-CD4081BEE4
BOOT-MODE1: SW_MEC_5E; SW_Push_2P1T_Toggle_CK_PVA1xxH1xxxxxxV2
BUFFER-A1: SN74HC574N; DIP-20_W7.62mm; Mouser Part Number 595-SN74HC574N
BUFFER-B1: SN74HC574N; DIP-20_W7.62mm; Mouser Part Number 595-SN74HC574N
BUFFER-C1: SN74HC574N; DIP-20_W7.62mm; Mouser Part Number 595-SN74HC574N
BUFFER-D1: SN74HC574N; DIP-20_W7.62mm; Mouser Part Number 595-SN74HC574N
BUFFER-E1: SN74HC574N; DIP-20_W7.62mm; Mouser Part Number 595-SN74HC574N
BUFFER-F1: SN74HC574N; DIP-20_W7.62mm; Mouser Part Number 595-SN74HC574N
BUFFER-G1: SN74HC574N; DIP-20_W7.62mm; Mouser Part Number 595-SN74HC574N
C1: C_Polarized_US; CP_Radial_D5.0mm_P2.50mm
C2: C; C_Disc_D3.0mm_W1.6mm_P2.50mm
EEPROM-BOOT-MEMORY1: AT28C64B-15PU; DIP-28_W15.24mm; Mouser Part Number 556-AT28C64B15PU
EEPROM-FLAG-CHECK1: AT28C64B-15PU; DIP-28_W15.24mm; Mouser Part Number 556-AT28C64B15PU
EEPROM-INTERRUPT-CHECK1: AT28C64B-15PU; DIP-28_W15.24mm; Mouser Part Number 556-AT28C64B15PU
EEPROM-SIGNALS-A1: AT28C64B-15PU; DIP-28_W15.24mm; Mouser Part Number 556-AT28C64B15PU
EEPROM-SIGNALS-B1: AT28C64B-15PU; DIP-28_W15.24mm; Mouser Part Number 556-AT28C64B15PU
EEPROM-SIGNALS-C1: AT28C64B-15PU; DIP-28_W15.24mm; Mouser Part Number 556-AT28C64B15PU
EEPROM-SIGNALS-D1: AT28C64B-15PU; DIP-28_W15.24mm; Mouser Part Number 556-AT28C64B15PU
EEPROM-SIGNALS-E1: AT28C64B-15PU; DIP-28_W15.24mm; Mouser Part Number 556-AT28C64B15PU
EEPROM-SIGNALS-F1: AT28C64B-15PU; DIP-28_W15.24mm; Mouser Part Number 556-AT28C64B15PU
EEPROM-SIGNALS-G1: AT28C64B-15PU; DIP-28_W15.24mm; Mouser Part Number 556-AT28C64B15PU
ENABLE-INTERRUPTS1, ENABLE-INTERRUPTS2: CD4081BEE4; DIP-14_W7.62mm; Mouser Part Number 595-CD4081BEE4
IDC-ADDRESS-BUS1, IDC-ADDRESS-BUS2, IDC-ADDRESS-BUS3, IDC-ADDRESS-BUS4: DS1013-20SSIB1-B-0; PinSocket_2x10_P2.54mm_Vertical; Manufacturer_Part_Number DS1013-20SSIB1-B-0
IDC-DATA-BUS1, IDC-DATA-BUS2, IDC-DATA-BUS3, IDC-DATA-BUS4: DS1013-20SSIB1-B-0; PinSocket_2x10_P2.54mm_Vertical; Manufacturer_Part_Number DS1013-20SSIB1-B-0
IDC-FLAGS1: DS1013-20SSIB1-B-0; PinSocket_2x10_P2.54mm_Vertical; Manufacturer_Part_Number DS1013-20SSIB1-B-0
IDC-SIGNALS1, IDC-SIGNALS2, IDC-SIGNALS3: DS1013-20SSIB1-B-0; PinSocket_2x10_P2.54mm_Vertical; Manufacturer_Part_Number DS1013-20SSIB1-B-0
INSTRUCTION-REGISTER1: SN74HC574N; DIP-20_W7.62mm; Mouser Part Number 595-SN74HC574N
INTERRUPTS-IN1, INTERRUPTS-IN2: Conn-1x5; PinHeader_1x05_P2.54mm_Vertical
INTERRUPTS-OUT1, INTERRUPTS-OUT2: Conn-1x5; PinHeader_1x05_P2.54mm_Vertical
LED_A0, LED_A1, LED_A2, LED_A3, LED_A4, LED_A5, LED_A6, LED_A7, LED_A8, LED_A9, LED_A10, LED_A11, LED_A12, LED_A13, LED_A14, LED_A15: LED; LED_D5.0mm_FlatTop
LED_D0, LED_D1, LED_D2, LED_D3, LED_D4, LED_D5, LED_D6, LED_D7: LED; LED_D5.0mm_FlatTop
LED_INT0, LED_INT1, LED_INT2, LED_INT3, LED_INT4: LED; LED_D5.0mm_FlatTop
LED_INT_EN1: LED; LED_D5.0mm_FlatTop
LED_IR0, LED_IR1, LED_IR2, LED_IR3, LED_IR4, LED_IR5, LED_IR6, LED_IR7: LED; LED_D5.0mm_FlatTop
LED_M1: LED; LED_D5.0mm_FlatTop
LED_MC0, LED_MC1, LED_MC2, LED_MC3: LED; LED_D5.0mm_FlatTop
MASTER-RESET1: SW_MEC_5E; SW_Push_2P1T_Toggle_CK_PVA1xxH1xxxxxxV2
MICROCODE-COUNTER1: CD74HC193E; DIP-16_W7.62mm; Mouser Part Number 595-CD74HC193E
MODE-SELECTOR-1: SW_DPDT_x2; SW_Slide-03_Wuerth-WS-SLTV_10x2.5x6.4_P2.54mm
NOT-GATE-INT1: CD74HC04E; DIP-14_W7.62mm; Mouser Part Number 595-CD74HC04E
NOT-GATE-SELECTOR1: CD74HC04E; DIP-14_W7.62mm; Mouser Part Number 595-CD74HC04E
OR-GATE-INT1: CD4071BEE4; DIP-14_W7.62mm; Mouser Part Number 595-CD4071BEE4
OR-GATE-RESETS1: CD4071BEE4; DIP-14_W7.62mm; Mouser Part Number 595-CD4071BEE4
R_A0, R_A1, R_A2, R_A3, R_A4, R_A5, R_A6, R_A7, R_A8, R_A9, R_A10, R_A11, R_A12, R_A13, R_A14, R_A15: R_US; R_Axial_DIN0204_L3.6mm_D1.6mm_P7.62mm_Horizontal
R_D0, R_D1, R_D2, R_D3, R_D4, R_D5, R_D6, R_D7: R_US; R_Axial_DIN0204_L3.6mm_D1.6mm_P7.62mm_Horizontal
R_DOWN1: R_US; R_Axial_DIN0204_L3.6mm_D1.6mm_P7.62mm_Horizontal
R_INT0, R_INT1, R_INT2, R_INT3, R_INT4: R_US; R_Axial_DIN0204_L3.6mm_D1.6mm_P7.62mm_Horizontal
R_INT_EN1: R_US; R_Axial_DIN0204_L3.6mm_D1.6mm_P7.62mm_Horizontal
R_IR0, R_IR1, R_IR2, R_IR3, R_IR4, R_IR5, R_IR6, R_IR7: R_US; R_Axial_DIN0204_L3.6mm_D1.6mm_P7.62mm_Horizontal
R_M1: R_US; R_Axial_DIN0204_L3.6mm_D1.6mm_P7.62mm_Horizontal
R_MC0, R_MC1, R_MC2, R_MC3: R_US; R_Axial_DIN0204_L3.6mm_D1.6mm_P7.62mm_Horizontal
R_UP1: R_US; R_Axial_DIN0204_L3.6mm_D1.6mm_P7.62mm_Horizontal
SR-LATCH-INTERRUPTS2: CD4043BEE4; DIP-16_W7.62mm; Mouser Part Number 595-CD4043BEE4
SR-LATCH_INTERRUPTS1: CD4043BEE4; DIP-16_W7.62mm; Mouser Part Number 595-CD4043BEE4
SUPPLY-IN1: Conn-1x2; PinHeader_1x02_P2.54mm_Vertical
SUPPLY-OUT1, SUPPLY-OUT2, SUPPLY-OUT3, SUPPLY-OUT4, SUPPLY-OUT5: Conn-1x2; PinHeader_1x02_P2.54mm_Vertical
TRNS-BOOT-MEMORY1: SN74AC245N; DIP-20_W7.62mm; Mouser Part Number 595-SN74AC245N
TRNS-INT-ADDRESS1, TRNS-INT-ADDRESS2: SN74AC245N; DIP-20_W7.62mm; Mouser Part Number 595-SN74AC245N
TRNS-RAM-MEMORY1: SN74AC245N; DIP-20_W7.62mm; Mouser Part Number 595-SN74AC245N

Connections:
(INT_1``_OR_INT_2``)_AND_(~INT_3``_OR_INT_4``): AND-GATE-INT1.3 (J=A.B), TRNS-INT-ADDRESS1.7 (A6)
(~INT_3``_AND_(~INT_1``_OR_INT_2``))_OR_INT_4``: OR-GATE-INT1.10 (L=E+F), TRNS-INT-ADDRESS1.8 (A7)
ADDRESS0: EEPROM-BOOT-MEMORY1.10 (A0), IDC-ADDRESS-BUS1.19, IDC-ADDRESS-BUS2.19, IDC-ADDRESS-BUS3.19, IDC-ADDRESS-BUS4.19, R_A0.1, TRNS-INT-ADDRESS1.11 (B8)
ADDRESS1: EEPROM-BOOT-MEMORY1.9 (A1), IDC-ADDRESS-BUS1.17, IDC-ADDRESS-BUS2.17, IDC-ADDRESS-BUS3.17, IDC-ADDRESS-BUS4.17, R_A1.1, TRNS-INT-ADDRESS1.12 (B7)
ADDRESS2: EEPROM-BOOT-MEMORY1.8 (A2), IDC-ADDRESS-BUS1.15, IDC-ADDRESS-BUS2.15, IDC-ADDRESS-BUS3.15, IDC-ADDRESS-BUS4.15, R_A2.1, TRNS-INT-ADDRESS1.13 (B6)
ADDRESS3: EEPROM-BOOT-MEMORY1.7 (A3), IDC-ADDRESS-BUS1.13, IDC-ADDRESS-BUS2.13, IDC-ADDRESS-BUS3.13, IDC-ADDRESS-BUS4.13, R_A3.1, TRNS-INT-ADDRESS1.14 (B5)
ADDRESS4: EEPROM-BOOT-MEMORY1.6 (A4), IDC-ADDRESS-BUS1.11, IDC-ADDRESS-BUS2.11, IDC-ADDRESS-BUS3.11, IDC-ADDRESS-BUS4.11, R_A4.1, TRNS-INT-ADDRESS1.15 (B4)
ADDRESS5: EEPROM-BOOT-MEMORY1.5 (A5), IDC-ADDRESS-BUS1.9, IDC-ADDRESS-BUS2.9, IDC-ADDRESS-BUS3.9, IDC-ADDRESS-BUS4.9, R_A5.1, TRNS-INT-ADDRESS1.16 (B3)
ADDRESS6: EEPROM-BOOT-MEMORY1.4 (A6), IDC-ADDRESS-BUS1.7, IDC-ADDRESS-BUS2.7, IDC-ADDRESS-BUS3.7, IDC-ADDRESS-BUS4.7, R_A6.1, TRNS-INT-ADDRESS1.17 (B2)
ADDRESS7: EEPROM-BOOT-MEMORY1.3 (A7), IDC-ADDRESS-BUS1.5, IDC-ADDRESS-BUS2.5, IDC-ADDRESS-BUS3.5, IDC-ADDRESS-BUS4.5, R_A7.1, TRNS-INT-ADDRESS1.18 (B1)
ADDRESS8: EEPROM-BOOT-MEMORY1.25 (A8), IDC-ADDRESS-BUS1.20, IDC-ADDRESS-BUS2.20, IDC-ADDRESS-BUS3.20, IDC-ADDRESS-BUS4.20, R_A8.1, TRNS-INT-ADDRESS2.11 (B8)
ADDRESS9: EEPROM-BOOT-MEMORY1.24 (A9), IDC-ADDRESS-BUS1.18, IDC-ADDRESS-BUS2.18, IDC-ADDRESS-BUS3.18, IDC-ADDRESS-BUS4.18, R_A9.1, TRNS-INT-ADDRESS2.12 (B7)
ADDRESS10: EEPROM-BOOT-MEMORY1.21 (A10), IDC-ADDRESS-BUS1.16, IDC-ADDRESS-BUS2.16, IDC-ADDRESS-BUS3.16, IDC-ADDRESS-BUS4.16, R_A10.1, TRNS-INT-ADDRESS2.13 (B6)
ADDRESS11: EEPROM-BOOT-MEMORY1.23 (A11), IDC-ADDRESS-BUS1.14, IDC-ADDRESS-BUS2.14, IDC-ADDRESS-BUS3.14, IDC-ADDRESS-BUS4.14, R_A11.1, TRNS-INT-ADDRESS2.14 (B5)
ADDRESS12: EEPROM-BOOT-MEMORY1.2 (A12), IDC-ADDRESS-BUS1.12, IDC-ADDRESS-BUS2.12, IDC-ADDRESS-BUS3.12, IDC-ADDRESS-BUS4.12, R_A12.1, TRNS-INT-ADDRESS2.15 (B4)
ADDRESS13: IDC-ADDRESS-BUS1.10, IDC-ADDRESS-BUS2.10, IDC-ADDRESS-BUS3.10, IDC-ADDRESS-BUS4.10, R_A13.1, TRNS-INT-ADDRESS2.16 (B3)
ADDRESS14: IDC-ADDRESS-BUS1.8, IDC-ADDRESS-BUS2.8, IDC-ADDRESS-BUS3.8, IDC-ADDRESS-BUS4.8, R_A14.1, TRNS-INT-ADDRESS2.17 (B2)
ADDRESS15: IDC-ADDRESS-BUS1.6, IDC-ADDRESS-BUS2.6, IDC-ADDRESS-BUS3.6, IDC-ADDRESS-BUS4.6, R_A15.2, TRNS-INT-ADDRESS2.18 (B1)
ALU_OPC_0: BUFFER-A1.17 (3Q), IDC-SIGNALS1.15
ALU_OPC_1: BUFFER-A1.16 (4Q), IDC-SIGNALS1.13
ALU_OPC_2: BUFFER-A1.15 (5Q), IDC-SIGNALS1.11
ALU_OPC_3: BUFFER-A1.14 (6Q), IDC-SIGNALS1.9
ALU_OPC_4: BUFFER-A1.13 (7Q), IDC-SIGNALS1.7
DATA0: IDC-DATA-BUS1.19, IDC-DATA-BUS1.20, IDC-DATA-BUS2.19, IDC-DATA-BUS2.20, IDC-DATA-BUS3.19, IDC-DATA-BUS3.20, IDC-DATA-BUS4.19, IDC-DATA-BUS4.20, R_D0.1, TRNS-RAM-MEMORY1.9 (A8)
DATA1: IDC-DATA-BUS1.17, IDC-DATA-BUS1.18, IDC-DATA-BUS2.17, IDC-DATA-BUS2.18, IDC-DATA-BUS3.17, IDC-DATA-BUS3.18, IDC-DATA-BUS4.17, IDC-DATA-BUS4.18, R_D1.1, TRNS-RAM-MEMORY1.8 (A7)
DATA2: IDC-DATA-BUS1.15, IDC-DATA-BUS1.16, IDC-DATA-BUS2.15, IDC-DATA-BUS2.16, IDC-DATA-BUS3.15, IDC-DATA-BUS3.16, IDC-DATA-BUS4.15, IDC-DATA-BUS4.16, R_D2.1, TRNS-RAM-MEMORY1.7 (A6)
DATA3: IDC-DATA-BUS1.13, IDC-DATA-BUS1.14, IDC-DATA-BUS2.13, IDC-DATA-BUS2.14, IDC-DATA-BUS3.13, IDC-DATA-BUS3.14, IDC-DATA-BUS4.13, IDC-DATA-BUS4.14, R_D3.1, TRNS-RAM-MEMORY1.6 (A5)
DATA4: IDC-DATA-BUS1.11, IDC-DATA-BUS1.12, IDC-DATA-BUS2.11, IDC-DATA-BUS2.12, IDC-DATA-BUS3.11, IDC-DATA-BUS3.12, IDC-DATA-BUS4.11, IDC-DATA-BUS4.12, R_D4.1, TRNS-RAM-MEMORY1.5 (A4)
DATA5: IDC-DATA-BUS1.9, IDC-DATA-BUS1.10, IDC-DATA-BUS2.9, IDC-DATA-BUS2.10, IDC-DATA-BUS3.9, IDC-DATA-BUS3.10, IDC-DATA-BUS4.9, IDC-DATA-BUS4.10, R_D5.1, TRNS-RAM-MEMORY1.4 (A3)
DATA6: IDC-DATA-BUS1.7, IDC-DATA-BUS1.8, IDC-DATA-BUS2.7, IDC-DATA-BUS2.8, IDC-DATA-BUS3.7, IDC-DATA-BUS3.8, IDC-DATA-BUS4.7, IDC-DATA-BUS4.8, R_D6.1, TRNS-RAM-MEMORY1.3 (A2)
DATA7: IDC-DATA-BUS1.5, IDC-DATA-BUS1.6, IDC-DATA-BUS2.5, IDC-DATA-BUS2.6, IDC-DATA-BUS3.5, IDC-DATA-BUS3.6, IDC-DATA-BUS4.5, IDC-DATA-BUS4.6, R_D7.1, TRNS-RAM-MEMORY1.2 (A1)
FLAG0: EEPROM-FLAG-CHECK1.25 (A8), IDC-FLAGS1.19, IDC-FLAGS1.20
FLAG1: EEPROM-FLAG-CHECK1.24 (A9), IDC-FLAGS1.17, IDC-FLAGS1.18
FLAG2: EEPROM-FLAG-CHECK1.21 (A10), IDC-FLAGS1.15, IDC-FLAGS1.16
FLAG3: EEPROM-FLAG-CHECK1.23 (A11), IDC-FLAGS1.13, IDC-FLAGS1.14
FLAG4: EEPROM-FLAG-CHECK1.2 (A12), IDC-FLAGS1.11, IDC-FLAGS1.12
FLAG5: IDC-FLAGS1.9, IDC-FLAGS1.10
FLAG6: IDC-FLAGS1.7, IDC-FLAGS1.8
FLAG7: IDC-FLAGS1.5, IDC-FLAGS1.6
GND: AND-GATE-INT1.7 (VSS), AND-GATE-INT2.7 (VSS), AND-GATE-INT3.7 (VSS), AND-GATE-SELECTOR1.7 (VSS), BOOT-MODE1.2, BUFFER-A1.1 (~OE), BUFFER-A1.10 (GND), BUFFER-B1.1 (~OE), BUFFER-B1.10 (GND), BUFFER-C1.1 (~OE), BUFFER-C1.10 (GND), BUFFER-D1.1 (~OE), BUFFER-D1.10 (GND), BUFFER-E1.1 (~OE), BUFFER-E1.10 (GND), BUFFER-F1.1 (~OE), BUFFER-F1.10 (GND), BUFFER-G1.1 (~OE), BUFFER-G1.10 (GND), C1.2, C2.2, EEPROM-BOOT-MEMORY1.14 (GND), EEPROM-BOOT-MEMORY1.20 (~CE), EEPROM-BOOT-MEMORY1.22 (~OE), EEPROM-FLAG-CHECK1.14 (GND), EEPROM-FLAG-CHECK1.20 (~CE), EEPROM-FLAG-CHECK1.22 (~OE), EEPROM-INTERRUPT-CHECK1.14 (GND), EEPROM-INTERRUPT-CHECK1.20 (~CE), EEPROM-INTERRUPT-CHECK1.22 (~OE), EEPROM-SIGNALS-A1.14 (GND), EEPROM-SIGNALS-A1.20 (~CE), EEPROM-SIGNALS-A1.22 (~OE), EEPROM-SIGNALS-B1.14 (GND), EEPROM-SIGNALS-B1.20 (~CE), EEPROM-SIGNALS-B1.22 (~OE), EEPROM-SIGNALS-C1.14 (GND), EEPROM-SIGNALS-C1.20 (~CE), EEPROM-SIGNALS-C1.22 (~OE), EEPROM-SIGNALS-D1.14 (GND), EEPROM-SIGNALS-D1.20 (~CE), EEPROM-SIGNALS-D1.22 (~OE), EEPROM-SIGNALS-E1.14 (GND), EEPROM-SIGNALS-E1.20 (~CE), EEPROM-SIGNALS-E1.22 (~OE), EEPROM-SIGNALS-F1.14 (GND), EEPROM-SIGNALS-F1.20 (~CE), EEPROM-SIGNALS-F1.22 (~OE), EEPROM-SIGNALS-G1.14 (GND), EEPROM-SIGNALS-G1.20 (~CE), EEPROM-SIGNALS-G1.22 (~OE), ENABLE-INTERRUPTS1.7 (VSS), ENABLE-INTERRUPTS2.7 (VSS), INSTRUCTION-REGISTER1.1 (~OE), INSTRUCTION-REGISTER1.10 (GND), LED_A0.1 (K), LED_A1.1 (K), LED_A2.1 (K), LED_A3.1 (K), LED_A4.1 (K), LED_A5.1 (K), LED_A6.1 (K), LED_A7.1 (K), LED_A8.1 (K), LED_A9.1 (K), LED_A10.1 (K), LED_A11.1 (K), LED_A12.1 (K), LED_A13.1 (K), LED_A14.1 (K), LED_A15.1 (K), LED_D0.1 (K), LED_D1.1 (K), LED_D2.1 (K), LED_D3.1 (K), LED_D4.1 (K), LED_D5.1 (K), LED_D6.1 (K), LED_D7.1 (K), LED_INT0.1 (K), LED_INT1.1 (K), LED_INT2.1 (K), LED_INT3.1 (K), LED_INT4.1 (K), LED_INT_EN1.1 (K), LED_IR0.1 (K), LED_IR1.1 (K), LED_IR2.1 (K), LED_IR3.1 (K), LED_IR4.1 (K), LED_IR5.1 (K), LED_IR6.1 (K), LED_IR7.1 (K), LED_M1.1 (K), LED_MC0.1 (K), LED_MC1.1 (K), LED_MC2.1 (K), LED_MC3.1 (K), MICROCODE-COUNTER1.1, MICROCODE-COUNTER1.8 (GND), MICROCODE-COUNTER1.9 (P3), MICROCODE-COUNTER1.10 (P2), MICROCODE-COUNTER1.15 (P0), MODE-SELECTOR-1.3 (C), NOT-GATE-INT1.7 (GND), NOT-GATE-SELECTOR1.7 (GND), OR-GATE-INT1.7 (VSS), OR-GATE-RESETS1.7 (VSS), R_DOWN1.2, SR-LATCH-INTERRUPTS2.8 (VSS), SR-LATCH_INTERRUPTS1.8 (VSS), SUPPLY-IN1.2, SUPPLY-OUT1.2, SUPPLY-OUT2.2, SUPPLY-OUT3.2, SUPPLY-OUT4.2, SUPPLY-OUT5.2, TRNS-BOOT-MEMORY1.10 (GND), TRNS-INT-ADDRESS1.9 (A8), TRNS-INT-ADDRESS1.10 (GND), TRNS-INT-ADDRESS2.10 (GND), TRNS-RAM-MEMORY1.10 (GND)
INT_0: INTERRUPTS-IN1.5, INTERRUPTS-IN2.5, R_INT0.1, SR-LATCH_INTERRUPTS1.4 (S1)
INT_0`: ENABLE-INTERRUPTS1.1 (A), SR-LATCH_INTERRUPTS1.2 (Q1)
INT_0``: EEPROM-INTERRUPT-CHECK1.25 (A8), ENABLE-INTERRUPTS1.3 (J=A.B)
INT_1: INTERRUPTS-IN1.4, INTERRUPTS-IN2.4, R_INT1.1, SR-LATCH_INTERRUPTS1.6 (S2)
INT_1`: ENABLE-INTERRUPTS1.6 (D), SR-LATCH_INTERRUPTS1.9 (Q2)
INT_1``: AND-GATE-INT3.13 (H), EEPROM-INTERRUPT-CHECK1.24 (A9), ENABLE-INTERRUPTS1.4 (K=C.D), NOT-GATE-INT1.1 (1A), OR-GATE-INT1.1 (A)
INT_1``_AND_~INT_2``_AND_(~INT3``_OR_INT4``): AND-GATE-INT2.13 (H), AND-GATE-INT3.10 (L=E.F)
INT_1``_OR_INT_2``: AND-GATE-INT1.1 (A), NOT-GATE-INT1.11 (5A), OR-GATE-INT1.3 (J=A+B)
INT_2: INTERRUPTS-IN1.3, INTERRUPTS-IN2.3, R_INT2.1, SR-LATCH_INTERRUPTS1.12 (S3)
INT_2`: ENABLE-INTERRUPTS1.8 (E), SR-LATCH_INTERRUPTS1.10 (Q3)
INT_2``: AND-GATE-INT1.9 (F), EEPROM-INTERRUPT-CHECK1.21 (A10), ENABLE-INTERRUPTS1.10 (L=E.F), NOT-GATE-INT1.3 (2A), OR-GATE-INT1.2 (B), OR-GATE-INT1.12 (G)
INT_2``_AND_(~INT_3``_OR_INT_4``): AND-GATE-INT1.10 (L=E.F), AND-GATE-INT2.8 (E)
INT_3: INTERRUPTS-IN1.2, INTERRUPTS-IN2.2, R_INT3.1, SR-LATCH_INTERRUPTS1.14 (S4)
INT_3`: ENABLE-INTERRUPTS1.13 (H), SR-LATCH_INTERRUPTS1.1 (Q4)
INT_3``: AND-GATE-INT1.13 (H), EEPROM-INTERRUPT-CHECK1.23 (A11), ENABLE-INTERRUPTS1.11 (M=G.H), NOT-GATE-INT1.5 (3A), OR-GATE-INT1.5 (C)
INT_3``_AND_~INT_4``: AND-GATE-INT1.11 (M=G.H), AND-GATE-INT2.6 (D)
INT_3``_OR_INT_4``: NOT-GATE-INT1.13 (6A), OR-GATE-INT1.4 (K=C+D), TRNS-INT-ADDRESS1.6 (A5)
INT_4: INTERRUPTS-IN1.1, INTERRUPTS-IN2.1, R_INT4.1, SR-LATCH-INTERRUPTS2.14 (S4)
INT_4`: ENABLE-INTERRUPTS2.1 (A), SR-LATCH-INTERRUPTS2.1 (Q4)
INT_4``: AND-GATE-INT2.1 (A), EEPROM-INTERRUPT-CHECK1.2 (A12), ENABLE-INTERRUPTS2.3 (J=A.B), NOT-GATE-INT1.9 (4A), OR-GATE-INT1.6 (D), OR-GATE-INT1.8 (E)
INT_ENABLE: ENABLE-INTERRUPTS1.2 (B), ENABLE-INTERRUPTS1.5 (C), ENABLE-INTERRUPTS1.9 (F), ENABLE-INTERRUPTS1.12 (G), ENABLE-INTERRUPTS2.2 (B), R_INT_EN1.1, SR-LATCH-INTERRUPTS2.2 (Q1)
INT_OUT_0: BUFFER-F1.16 (4Q), INTERRUPTS-OUT1.5, INTERRUPTS-OUT2.5
INT_OUT_1: BUFFER-F1.15 (5Q), INTERRUPTS-OUT1.4, INTERRUPTS-OUT2.4
INT_OUT_2: BUFFER-F1.14 (6Q), INTERRUPTS-OUT1.3, INTERRUPTS-OUT2.3
INT_OUT_3: BUFFER-F1.13 (7Q), INTERRUPTS-OUT1.2, INTERRUPTS-OUT2.2
INT_OUT_4: BUFFER-F1.12 (8Q), INTERRUPTS-OUT1.1, INTERRUPTS-OUT2.1
IR0: EEPROM-SIGNALS-A1.6 (A4), EEPROM-SIGNALS-B1.6 (A4), EEPROM-SIGNALS-C1.6 (A4), EEPROM-SIGNALS-D1.6 (A4), EEPROM-SIGNALS-E1.6 (A4), EEPROM-SIGNALS-F1.6 (A4), EEPROM-SIGNALS-G1.6 (A4), INSTRUCTION-REGISTER1.19 (1Q), R_IR0.1
IR1: EEPROM-SIGNALS-A1.5 (A5), EEPROM-SIGNALS-B1.5 (A5), EEPROM-SIGNALS-C1.5 (A5), EEPROM-SIGNALS-D1.5 (A5), EEPROM-SIGNALS-E1.5 (A5), EEPROM-SIGNALS-F1.5 (A5), EEPROM-SIGNALS-G1.5 (A5), INSTRUCTION-REGISTER1.18 (2Q), R_IR1.1
IR2: EEPROM-SIGNALS-A1.4 (A6), EEPROM-SIGNALS-B1.4 (A6), EEPROM-SIGNALS-C1.4 (A6), EEPROM-SIGNALS-D1.4 (A6), EEPROM-SIGNALS-E1.4 (A6), EEPROM-SIGNALS-F1.4 (A6), EEPROM-SIGNALS-G1.4 (A6), INSTRUCTION-REGISTER1.17 (3Q), R_IR2.1
IR3: EEPROM-SIGNALS-A1.3 (A7), EEPROM-SIGNALS-B1.3 (A7), EEPROM-SIGNALS-C1.3 (A7), EEPROM-SIGNALS-D1.3 (A7), EEPROM-SIGNALS-E1.3 (A7), EEPROM-SIGNALS-F1.3 (A7), EEPROM-SIGNALS-G1.3 (A7), INSTRUCTION-REGISTER1.16 (4Q), R_IR3.1
IR4: EEPROM-SIGNALS-A1.25 (A8), EEPROM-SIGNALS-B1.25 (A8), EEPROM-SIGNALS-C1.25 (A8), EEPROM-SIGNALS-D1.25 (A8), EEPROM-SIGNALS-E1.25 (A8), EEPROM-SIGNALS-F1.25 (A8), EEPROM-SIGNALS-G1.25 (A8), INSTRUCTION-REGISTER1.15 (5Q), R_IR4.1
IR5: EEPROM-SIGNALS-A1.24 (A9), EEPROM-SIGNALS-B1.24 (A9), EEPROM-SIGNALS-C1.24 (A9), EEPROM-SIGNALS-D1.24 (A9), EEPROM-SIGNALS-E1.24 (A9), EEPROM-SIGNALS-F1.24 (A9), EEPROM-SIGNALS-G1.24 (A9), INSTRUCTION-REGISTER1.14 (6Q), R_IR5.1
IR6: EEPROM-SIGNALS-A1.21 (A10), EEPROM-SIGNALS-B1.21 (A10), EEPROM-SIGNALS-C1.21 (A10), EEPROM-SIGNALS-D1.21 (A10), EEPROM-SIGNALS-E1.21 (A10), EEPROM-SIGNALS-F1.21 (A10), EEPROM-SIGNALS-G1.21 (A10), INSTRUCTION-REGISTER1.13 (7Q), R_IR6.2
IR7: EEPROM-SIGNALS-A1.23 (A11), EEPROM-SIGNALS-B1.23 (A11), EEPROM-SIGNALS-C1.23 (A11), EEPROM-SIGNALS-D1.23 (A11), EEPROM-SIGNALS-E1.23 (A11), EEPROM-SIGNALS-F1.23 (A11), EEPROM-SIGNALS-G1.23 (A11), INSTRUCTION-REGISTER1.12 (8Q), R_IR7.1
MASTER_RESET: MASTER-RESET1.4 (A), OR-GATE-RESETS1.2 (B), OR-GATE-RESETS1.5 (C), OR-GATE-RESETS1.9 (F), OR-GATE-RESETS1.12 (G)
MC0: EEPROM-SIGNALS-A1.10 (A0), EEPROM-SIGNALS-B1.10 (A0), EEPROM-SIGNALS-C1.10 (A0), EEPROM-SIGNALS-D1.10 (A0), EEPROM-SIGNALS-E1.10 (A0), EEPROM-SIGNALS-F1.10 (A0), EEPROM-SIGNALS-G1.10 (A0), MICROCODE-COUNTER1.3 (Q0), R_MC0.1
MC1: EEPROM-SIGNALS-A1.9 (A1), EEPROM-SIGNALS-B1.9 (A1), EEPROM-SIGNALS-C1.9 (A1), EEPROM-SIGNALS-D1.9 (A1), EEPROM-SIGNALS-E1.9 (A1), EEPROM-SIGNALS-F1.9 (A1), EEPROM-SIGNALS-G1.9 (A1), MICROCODE-COUNTER1.2 (Q1), R_MC1.1
MC2: EEPROM-SIGNALS-A1.8 (A2), EEPROM-SIGNALS-B1.8 (A2), EEPROM-SIGNALS-C1.8 (A2), EEPROM-SIGNALS-D1.8 (A2), EEPROM-SIGNALS-E1.8 (A2), EEPROM-SIGNALS-F1.8 (A2), EEPROM-SIGNALS-G1.8 (A2), MICROCODE-COUNTER1.6 (Q2), R_MC2.1
MC3: EEPROM-SIGNALS-A1.7 (A3), EEPROM-SIGNALS-B1.7 (A3), EEPROM-SIGNALS-C1.7 (A3), EEPROM-SIGNALS-D1.7 (A3), EEPROM-SIGNALS-E1.7 (A3), EEPROM-SIGNALS-F1.7 (A3), EEPROM-SIGNALS-G1.7 (A3), MICROCODE-COUNTER1.7 (Q3), R_MC3.1
MCC_RST: MICROCODE-COUNTER1.14 (MR), OR-GATE-RESETS1.11 (M=G+H)
MCC_RST': BUFFER-F1.17 (3Q), OR-GATE-RESETS1.13 (H)
MCC_TICK: BUFFER-F1.18 (2Q), MICROCODE-COUNTER1.5 (CPU)
MEMORY_SELECTOR: AND-GATE-SELECTOR1.12 (G), BUFFER-E1.12 (8Q)
MEM_PART: BUFFER-E1.18 (2Q), IDC-SIGNALS3.11
MODE: EEPROM-SIGNALS-A1.2 (A12), EEPROM-SIGNALS-B1.2 (A12), EEPROM-SIGNALS-C1.2 (A12), EEPROM-SIGNALS-D1.2 (A12), EEPROM-SIGNALS-E1.2 (A12), EEPROM-SIGNALS-F1.2 (A12), EEPROM-SIGNALS-G1.2 (A12), MODE-SELECTOR-1.2 (B), R_M1.1
unnamed: AND-GATE-INT3.1 (A), AND-GATE-INT3.4 (K=C.D)
unnamed: AND-GATE-INT3.9 (F), AND-GATE-INT3.11 (M=G.H)
unnamed: AND-GATE-SELECTOR1.13 (H), BOOT-MODE1.3 (K)
unnamed: AND-GATE-SELECTOR1.11 (M=G.H), NOT-GATE-SELECTOR1.13 (6A), TRNS-BOOT-MEMORY1.19 (~OE)
unnamed: BOOT-MODE1.4 (A), R_UP1.2
unnamed: BUFFER-A1.2 (1D), EEPROM-SIGNALS-A1.11 (I/O0)
unnamed: BUFFER-A1.3 (2D), EEPROM-SIGNALS-A1.12 (I/O1)
unnamed: BUFFER-A1.4 (3D), EEPROM-SIGNALS-A1.13 (I/O2)
unnamed: BUFFER-A1.5 (4D), EEPROM-SIGNALS-A1.15 (I/O3)
unnamed: BUFFER-A1.6 (5D), EEPROM-SIGNALS-A1.16 (I/O4)
unnamed: BUFFER-A1.7 (6D), EEPROM-SIGNALS-A1.17 (I/O5)
unnamed: BUFFER-A1.8 (7D), EEPROM-SIGNALS-A1.18 (I/O6)
unnamed: BUFFER-A1.9 (8D), EEPROM-SIGNALS-A1.19 (I/O7)
unnamed: BUFFER-B1.2 (1D), EEPROM-SIGNALS-B1.11 (I/O0)
unnamed: BUFFER-B1.3 (2D), EEPROM-SIGNALS-B1.12 (I/O1)
unnamed: BUFFER-B1.4 (3D), EEPROM-SIGNALS-B1.13 (I/O2)
unnamed: BUFFER-B1.5 (4D), EEPROM-SIGNALS-B1.15 (I/O3)
unnamed: BUFFER-B1.6 (5D), EEPROM-SIGNALS-B1.16 (I/O4)
unnamed: BUFFER-B1.7 (6D), EEPROM-SIGNALS-B1.17 (I/O5)
unnamed: BUFFER-B1.8 (7D), EEPROM-SIGNALS-B1.18 (I/O6)
unnamed: BUFFER-B1.9 (8D), EEPROM-SIGNALS-B1.19 (I/O7)
unnamed: BUFFER-C1.2 (1D), EEPROM-SIGNALS-C1.11 (I/O0)
unnamed: BUFFER-C1.3 (2D), EEPROM-SIGNALS-C1.12 (I/O1)
unnamed: BUFFER-C1.4 (3D), EEPROM-SIGNALS-C1.13 (I/O2)
unnamed: BUFFER-C1.5 (4D), EEPROM-SIGNALS-C1.15 (I/O3)
unnamed: BUFFER-C1.6 (5D), EEPROM-SIGNALS-C1.16 (I/O4)
unnamed: BUFFER-C1.7 (6D), EEPROM-SIGNALS-C1.17 (I/O5)
unnamed: BUFFER-C1.8 (7D), EEPROM-SIGNALS-C1.18 (I/O6)
unnamed: BUFFER-C1.9 (8D), EEPROM-SIGNALS-C1.19 (I/O7)
unnamed: BUFFER-D1.2 (1D), EEPROM-SIGNALS-D1.11 (I/O0)
unnamed: BUFFER-D1.3 (2D), EEPROM-SIGNALS-D1.12 (I/O1)
unnamed: BUFFER-D1.4 (3D), EEPROM-SIGNALS-D1.13 (I/O2)
unnamed: BUFFER-D1.5 (4D), EEPROM-SIGNALS-D1.15 (I/O3)
unnamed: BUFFER-D1.6 (5D), EEPROM-SIGNALS-D1.16 (I/O4)
unnamed: BUFFER-D1.7 (6D), EEPROM-SIGNALS-D1.17 (I/O5)
unnamed: BUFFER-D1.8 (7D), EEPROM-SIGNALS-D1.18 (I/O6)
unnamed: BUFFER-D1.9 (8D), EEPROM-SIGNALS-D1.19 (I/O7)
unnamed: BUFFER-E1.2 (1D), EEPROM-SIGNALS-E1.11 (I/O0)
unnamed: BUFFER-E1.3 (2D), EEPROM-SIGNALS-E1.12 (I/O1)
unnamed: BUFFER-E1.4 (3D), EEPROM-SIGNALS-E1.13 (I/O2)
unnamed: BUFFER-E1.5 (4D), EEPROM-SIGNALS-E1.15 (I/O3)
unnamed: BUFFER-E1.6 (5D), EEPROM-SIGNALS-E1.16 (I/O4)
unnamed: BUFFER-E1.7 (6D), EEPROM-SIGNALS-E1.17 (I/O5)
unnamed: BUFFER-E1.8 (7D), EEPROM-SIGNALS-E1.18 (I/O6)
unnamed: BUFFER-E1.9 (8D), EEPROM-SIGNALS-E1.19 (I/O7)
unnamed: BUFFER-F1.2 (1D), EEPROM-SIGNALS-F1.11 (I/O0)
unnamed: BUFFER-F1.3 (2D), EEPROM-SIGNALS-F1.12 (I/O1)
unnamed: BUFFER-F1.4 (3D), EEPROM-SIGNALS-F1.13 (I/O2)
unnamed: BUFFER-F1.5 (4D), EEPROM-SIGNALS-F1.15 (I/O3)
unnamed: BUFFER-F1.6 (5D), EEPROM-SIGNALS-F1.16 (I/O4)
unnamed: BUFFER-F1.7 (6D), EEPROM-SIGNALS-F1.17 (I/O5)
unnamed: BUFFER-F1.8 (7D), EEPROM-SIGNALS-F1.18 (I/O6)
unnamed: BUFFER-F1.9 (8D), EEPROM-SIGNALS-F1.19 (I/O7)
unnamed: BUFFER-G1.2 (1D), EEPROM-SIGNALS-G1.11 (I/O0)
unnamed: BUFFER-G1.3 (2D), EEPROM-SIGNALS-G1.12 (I/O1)
unnamed: BUFFER-G1.4 (3D), EEPROM-SIGNALS-G1.13 (I/O2)
unnamed: BUFFER-G1.5 (4D), EEPROM-SIGNALS-G1.15 (I/O3)
unnamed: BUFFER-G1.6 (5D), EEPROM-SIGNALS-G1.16 (I/O4)
unnamed: BUFFER-G1.7 (6D), EEPROM-SIGNALS-G1.17 (I/O5)
unnamed: BUFFER-G1.8 (7D), EEPROM-SIGNALS-G1.18 (I/O6)
unnamed: BUFFER-G1.9 (8D), EEPROM-SIGNALS-G1.19 (I/O7)
unnamed: EEPROM-BOOT-MEMORY1.11 (I/O0), TRNS-BOOT-MEMORY1.2 (A1)
unnamed: EEPROM-BOOT-MEMORY1.12 (I/O1), TRNS-BOOT-MEMORY1.3 (A2)
unnamed: EEPROM-BOOT-MEMORY1.13 (I/O2), TRNS-BOOT-MEMORY1.4 (A3)
unnamed: EEPROM-BOOT-MEMORY1.15 (I/O3), TRNS-BOOT-MEMORY1.5 (A4)
unnamed: EEPROM-BOOT-MEMORY1.16 (I/O4), TRNS-BOOT-MEMORY1.6 (A5)
unnamed: EEPROM-BOOT-MEMORY1.17 (I/O5), TRNS-BOOT-MEMORY1.7 (A6)
unnamed: EEPROM-BOOT-MEMORY1.18 (I/O6), TRNS-BOOT-MEMORY1.8 (A7)
unnamed: EEPROM-BOOT-MEMORY1.19 (I/O7), TRNS-BOOT-MEMORY1.9 (A8)
unnamed: EEPROM-FLAG-CHECK1.10 (A0), EEPROM-INTERRUPT-CHECK1.11 (I/O0)
unnamed: EEPROM-FLAG-CHECK1.9 (A1), EEPROM-INTERRUPT-CHECK1.12 (I/O1)
unnamed: EEPROM-FLAG-CHECK1.8 (A2), EEPROM-INTERRUPT-CHECK1.13 (I/O2)
unnamed: EEPROM-FLAG-CHECK1.7 (A3), EEPROM-INTERRUPT-CHECK1.15 (I/O3)
unnamed: EEPROM-FLAG-CHECK1.6 (A4), EEPROM-INTERRUPT-CHECK1.16 (I/O4)
unnamed: EEPROM-FLAG-CHECK1.5 (A5), EEPROM-INTERRUPT-CHECK1.17 (I/O5)
unnamed: EEPROM-FLAG-CHECK1.4 (A6), EEPROM-INTERRUPT-CHECK1.18 (I/O6)
unnamed: EEPROM-FLAG-CHECK1.3 (A7), EEPROM-INTERRUPT-CHECK1.19 (I/O7)
unnamed: EEPROM-FLAG-CHECK1.11 (I/O0), INSTRUCTION-REGISTER1.2 (1D)
unnamed: EEPROM-FLAG-CHECK1.12 (I/O1), INSTRUCTION-REGISTER1.3 (2D)
unnamed: EEPROM-FLAG-CHECK1.13 (I/O2), INSTRUCTION-REGISTER1.4 (3D)
unnamed: EEPROM-FLAG-CHECK1.15 (I/O3), INSTRUCTION-REGISTER1.5 (4D)
unnamed: EEPROM-FLAG-CHECK1.16 (I/O4), INSTRUCTION-REGISTER1.6 (5D)
unnamed: EEPROM-FLAG-CHECK1.17 (I/O5), INSTRUCTION-REGISTER1.7 (6D)
unnamed: EEPROM-FLAG-CHECK1.18 (I/O6), INSTRUCTION-REGISTER1.8 (7D)
unnamed: EEPROM-FLAG-CHECK1.19 (I/O7), INSTRUCTION-REGISTER1.9 (8D)
unnamed: EEPROM-INTERRUPT-CHECK1.10 (A0), TRNS-BOOT-MEMORY1.18 (B1), TRNS-RAM-MEMORY1.11 (B8)
unnamed: EEPROM-INTERRUPT-CHECK1.9 (A1), TRNS-BOOT-MEMORY1.17 (B2), TRNS-RAM-MEMORY1.12 (B7)
unnamed: EEPROM-INTERRUPT-CHECK1.8 (A2), TRNS-BOOT-MEMORY1.16 (B3), TRNS-RAM-MEMORY1.13 (B6)
unnamed: EEPROM-INTERRUPT-CHECK1.7 (A3), TRNS-BOOT-MEMORY1.15 (B4), TRNS-RAM-MEMORY1.14 (B5)
unnamed: EEPROM-INTERRUPT-CHECK1.6 (A4), TRNS-BOOT-MEMORY1.14 (B5), TRNS-RAM-MEMORY1.15 (B4)
unnamed: EEPROM-INTERRUPT-CHECK1.5 (A5), TRNS-BOOT-MEMORY1.13 (B6), TRNS-RAM-MEMORY1.16 (B3)
unnamed: EEPROM-INTERRUPT-CHECK1.4 (A6), TRNS-BOOT-MEMORY1.12 (B7), TRNS-RAM-MEMORY1.17 (B2)
unnamed: EEPROM-INTERRUPT-CHECK1.3 (A7), TRNS-BOOT-MEMORY1.11 (B8), TRNS-RAM-MEMORY1.18 (B1)
unnamed: LED_A0.2 (A), R_A0.2
unnamed: LED_A1.2 (A), R_A1.2
unnamed: LED_A2.2 (A), R_A2.2
unnamed: LED_A3.2 (A), R_A3.2
unnamed: LED_A4.2 (A), R_A4.2
unnamed: LED_A5.2 (A), R_A5.2
unnamed: LED_A6.2 (A), R_A6.2
unnamed: LED_A7.2 (A), R_A7.2
unnamed: LED_A8.2 (A), R_A8.2
unnamed: LED_A9.2 (A), R_A9.2
unnamed: LED_A10.2 (A), R_A10.2
unnamed: LED_A11.2 (A), R_A11.2
unnamed: LED_A12.2 (A), R_A12.2
unnamed: LED_A13.2 (A), R_A13.2
unnamed: LED_A14.2 (A), R_A14.2
unnamed: LED_A15.2 (A), R_A15.1
unnamed: LED_D0.2 (A), R_D0.2
unnamed: LED_D1.2 (A), R_D1.2
unnamed: LED_D2.2 (A), R_D2.2
unnamed: LED_D3.2 (A), R_D3.2
unnamed: LED_D4.2 (A), R_D4.2
unnamed: LED_D5.2 (A), R_D5.2
unnamed: LED_D6.2 (A), R_D6.2
unnamed: LED_D7.2 (A), R_D7.2
unnamed: LED_INT0.2 (A), R_INT0.2
unnamed: LED_INT1.2 (A), R_INT1.2
unnamed: LED_INT2.2 (A), R_INT2.2
unnamed: LED_INT3.2 (A), R_INT3.2
unnamed: LED_INT4.2 (A), R_INT4.2
unnamed: LED_INT_EN1.2 (A), R_INT_EN1.2
unnamed: LED_IR0.2 (A), R_IR0.2
unnamed: LED_IR1.2 (A), R_IR1.2
unnamed: LED_IR2.2 (A), R_IR2.2
unnamed: LED_IR3.2 (A), R_IR3.2
unnamed: LED_IR4.2 (A), R_IR4.2
unnamed: LED_IR5.2 (A), R_IR5.2
unnamed: LED_IR6.2 (A), R_IR6.1
unnamed: LED_IR7.2 (A), R_IR7.2
unnamed: LED_M1.2 (A), R_M1.2
unnamed: LED_MC0.2 (A), R_MC0.2
unnamed: LED_MC1.2 (A), R_MC1.2
unnamed: LED_MC2.2 (A), R_MC2.2
unnamed: LED_MC3.2 (A), R_MC3.2
unnamed: MASTER-RESET1.3 (K), R_DOWN1.1
unnamed: NOT-GATE-SELECTOR1.12 (~6Y), TRNS-RAM-MEMORY1.19 (~OE)
PC_RST: IDC-SIGNALS2.18, OR-GATE-RESETS1.3 (J=A+B)
PC_RST': BUFFER-C1.14 (6Q), OR-GATE-RESETS1.1 (A)
PC_TICK: BUFFER-C1.13 (7Q), IDC-SIGNALS2.16
REG_A_LOAD: BUFFER-A1.19 (1Q), IDC-SIGNALS1.19
REG_B_LOAD: BUFFER-A1.18 (2Q), IDC-SIGNALS1.17
REG_F_LOAD: BUFFER-A1.12 (8Q), IDC-SIGNALS1.5
REG_IR_LOAD: BUFFER-F1.19 (1Q), INSTRUCTION-REGISTER1.11 (CLK)
REG_MAR_LOAD: BUFFER-D1.14 (6Q), IDC-SIGNALS3.19
REG_MBR_LOAD: BUFFER-D1.13 (7Q), IDC-SIGNALS3.17
REG_MBR_WORD_DIR: BUFFER-E1.16 (4Q), IDC-SIGNALS3.7
REG_TMPH_DATA_DIR: BUFFER-C1.17 (3Q), IDC-SIGNALS2.3
REG_TMPH_LOAD: BUFFER-B1.17 (3Q), IDC-SIGNALS2.19
REG_TMPL_DATA_DIR: BUFFER-C1.16 (4Q), IDC-SIGNALS2.1
REG_TMPL_LOAD: BUFFER-B1.16 (4Q), IDC-SIGNALS2.17
REG_TMP_ADDRESS_DIR: BUFFER-C1.18 (2Q), IDC-SIGNALS2.5
RST_INT_0: AND-GATE-INT3.3 (J=A.B), SR-LATCH_INTERRUPTS1.3 (R1)
RST_INT_1: AND-GATE-INT2.11 (M=G.H), SR-LATCH_INTERRUPTS1.7 (R2)
RST_INT_2: AND-GATE-INT2.10 (L=E.F), SR-LATCH_INTERRUPTS1.11 (R3)
RST_INT_3: AND-GATE-INT2.4 (K=C.D), SR-LATCH_INTERRUPTS1.15 (R4)
RST_INT_4: AND-GATE-INT2.3 (J=A.B), SR-LATCH-INTERRUPTS2.15 (R4)
RST_INT_ENABLE: BUFFER-G1.18 (2Q), OR-GATE-RESETS1.8 (E)
RST_INT_ENABLE`: OR-GATE-RESETS1.10 (L=E+F), SR-LATCH-INTERRUPTS2.3 (R1)
SET_INT_ENABLE: AND-GATE-INT2.2 (B), AND-GATE-INT2.5 (C), AND-GATE-INT2.9 (F), AND-GATE-INT2.12 (G), AND-GATE-INT3.2 (B), BUFFER-G1.19 (1Q), SR-LATCH-INTERRUPTS2.4 (S1)
STC_MODE: BUFFER-D1.16 (4Q), IDC-SIGNALS2.6
STC_RST: IDC-SIGNALS2.10, OR-GATE-RESETS1.4 (K=C+D)
STC_RST': BUFFER-D1.18 (2Q), OR-GATE-RESETS1.6 (D)
STC_TICK: BUFFER-D1.17 (3Q), IDC-SIGNALS2.8
VCC: AND-GATE-INT1.14 (VDD), AND-GATE-INT2.14 (VDD), AND-GATE-INT3.14 (VDD), AND-GATE-SELECTOR1.14 (VDD), BUFFER-A1.20 (VCC), BUFFER-B1.20 (VCC), BUFFER-C1.20 (VCC), BUFFER-D1.20 (VCC), BUFFER-E1.20 (VCC), BUFFER-F1.20 (VCC), BUFFER-G1.20 (VCC), C1.1, C2.1, EEPROM-BOOT-MEMORY1.27 (~WE), EEPROM-BOOT-MEMORY1.28 (VCC), EEPROM-FLAG-CHECK1.27 (~WE), EEPROM-FLAG-CHECK1.28 (VCC), EEPROM-INTERRUPT-CHECK1.27 (~WE), EEPROM-INTERRUPT-CHECK1.28 (VCC), EEPROM-SIGNALS-A1.27 (~WE), EEPROM-SIGNALS-A1.28 (VCC), EEPROM-SIGNALS-B1.27 (~WE), EEPROM-SIGNALS-B1.28 (VCC), EEPROM-SIGNALS-C1.27 (~WE), EEPROM-SIGNALS-C1.28 (VCC), EEPROM-SIGNALS-D1.27 (~WE), EEPROM-SIGNALS-D1.28 (VCC), EEPROM-SIGNALS-E1.27 (~WE), EEPROM-SIGNALS-E1.28 (VCC), EEPROM-SIGNALS-F1.27 (~WE), EEPROM-SIGNALS-F1.28 (VCC), EEPROM-SIGNALS-G1.27 (~WE), EEPROM-SIGNALS-G1.28 (VCC), ENABLE-INTERRUPTS1.14 (VDD), ENABLE-INTERRUPTS2.14 (VDD), INSTRUCTION-REGISTER1.20 (VCC), MASTER-RESET1.2, MICROCODE-COUNTER1.4 (CPD), MICROCODE-COUNTER1.16 (VCC), MODE-SELECTOR-1.1 (A), NOT-GATE-INT1.14 (VCC), NOT-GATE-SELECTOR1.14 (VCC), OR-GATE-INT1.14 (VDD), OR-GATE-RESETS1.14 (VDD), R_UP1.1, SR-LATCH-INTERRUPTS2.5 (ENABLE), SR-LATCH-INTERRUPTS2.16 (VDD), SR-LATCH_INTERRUPTS1.5 (ENABLE), SR-LATCH_INTERRUPTS1.16 (VDD), SUPPLY-IN1.1, SUPPLY-OUT1.1, SUPPLY-OUT2.1, SUPPLY-OUT3.1, SUPPLY-OUT4.1, SUPPLY-OUT5.1, TRNS-BOOT-MEMORY1.1 (DIR), TRNS-BOOT-MEMORY1.20 (VCC), TRNS-INT-ADDRESS1.1 (DIR), TRNS-INT-ADDRESS1.2 (A1), TRNS-INT-ADDRESS1.3 (A2), TRNS-INT-ADDRESS1.4 (A3), TRNS-INT-ADDRESS1.5 (A4), TRNS-INT-ADDRESS1.20 (VCC), TRNS-INT-ADDRESS2.1 (DIR), TRNS-INT-ADDRESS2.2 (A1), TRNS-INT-ADDRESS2.3 (A2), TRNS-INT-ADDRESS2.4 (A3), TRNS-INT-ADDRESS2.5 (A4), TRNS-INT-ADDRESS2.6 (A5), TRNS-INT-ADDRESS2.7 (A6), TRNS-INT-ADDRESS2.8 (A7), TRNS-INT-ADDRESS2.9 (A8), TRNS-INT-ADDRESS2.20 (VCC), TRNS-RAM-MEMORY1.1 (DIR), TRNS-RAM-MEMORY1.20 (VCC)
~ALU_OUT: BUFFER-B1.18 (2Q), IDC-SIGNALS1.1
~CLK: BUFFER-A1.11 (CLK), BUFFER-B1.11 (CLK), BUFFER-C1.11 (CLK), BUFFER-D1.11 (CLK), BUFFER-E1.11 (CLK), BUFFER-F1.11 (CLK), BUFFER-G1.11 (CLK)
~INT3``_OR_INT4``: AND-GATE-INT3.8 (E)
~INT_1``_OR_INT_2``: AND-GATE-INT3.6 (D), NOT-GATE-INT1.10 (~5Y)
~INT_1``: NOT-GATE-INT1.2 (~1Y), OR-GATE-INT1.13 (H)
~INT_1``_OR_INT_2``: AND-GATE-INT1.6 (D), OR-GATE-INT1.11 (M=G+H)
~INT_2``: AND-GATE-INT3.12 (G), NOT-GATE-INT1.4 (~2Y)
~INT_3``_OR_INT_4``: AND-GATE-INT1.2 (B), AND-GATE-INT1.8 (E), AND-GATE-INT3.5 (C), NOT-GATE-INT1.12 (~6Y)
~INT_3``: AND-GATE-INT1.5 (C), NOT-GATE-INT1.6 (~3Y)
~INT_3``_AND_(~INT_1``_OR_INT_2``): AND-GATE-INT1.4 (K=C.D), OR-GATE-INT1.9 (F)
~INT_4``: AND-GATE-INT1.12 (G), NOT-GATE-INT1.8 (~4Y)
~INT_ADDRESS_OUT: BUFFER-G1.17 (3Q), TRNS-INT-ADDRESS1.19 (~OE), TRNS-INT-ADDRESS2.19 (~OE)
~MEM_IN: BUFFER-E1.19 (1Q), IDC-SIGNALS3.13
~MEM_OUT: BUFFER-D1.12 (8Q), IDC-SIGNALS3.15
~PC_LOAD: BUFFER-C1.15 (5Q), IDC-SIGNALS2.20
~PC_OUT: BUFFER-C1.12 (8Q), IDC-SIGNALS2.14
~REG_F_OUT: BUFFER-B1.19 (1Q), IDC-SIGNALS1.3
~REG_MAR_USE_BTTNS: BUFFER-E1.15 (5Q), IDC-SIGNALS3.5
~REG_MBR_USE_BTTNS: BUFFER-E1.14 (6Q), IDC-SIGNALS3.3
~REG_MBR_USE_BUS: BUFFER-E1.13 (7Q), IDC-SIGNALS3.1
~REG_TMPH_OUT: BUFFER-B1.15 (5Q), IDC-SIGNALS2.15
~REG_TMPH_PASS_DATA: BUFFER-B1.12 (8Q), IDC-SIGNALS2.9
~REG_TMPL_OUT: BUFFER-B1.14 (6Q), IDC-SIGNALS2.13
~REG_TMPL_PASS_DATA: BUFFER-C1.19 (1Q), IDC-SIGNALS2.7
~REG_TMP_PASS_ADDRESS: BUFFER-B1.13 (7Q), IDC-SIGNALS2.11
~STC_LOAD: BUFFER-D1.19 (1Q), IDC-SIGNALS2.12
~STC_OUT: BUFFER-D1.15 (5Q), IDC-SIGNALS2.4
~ZERO_PAGE: BUFFER-E1.17 (3Q), IDC-SIGNALS3.9

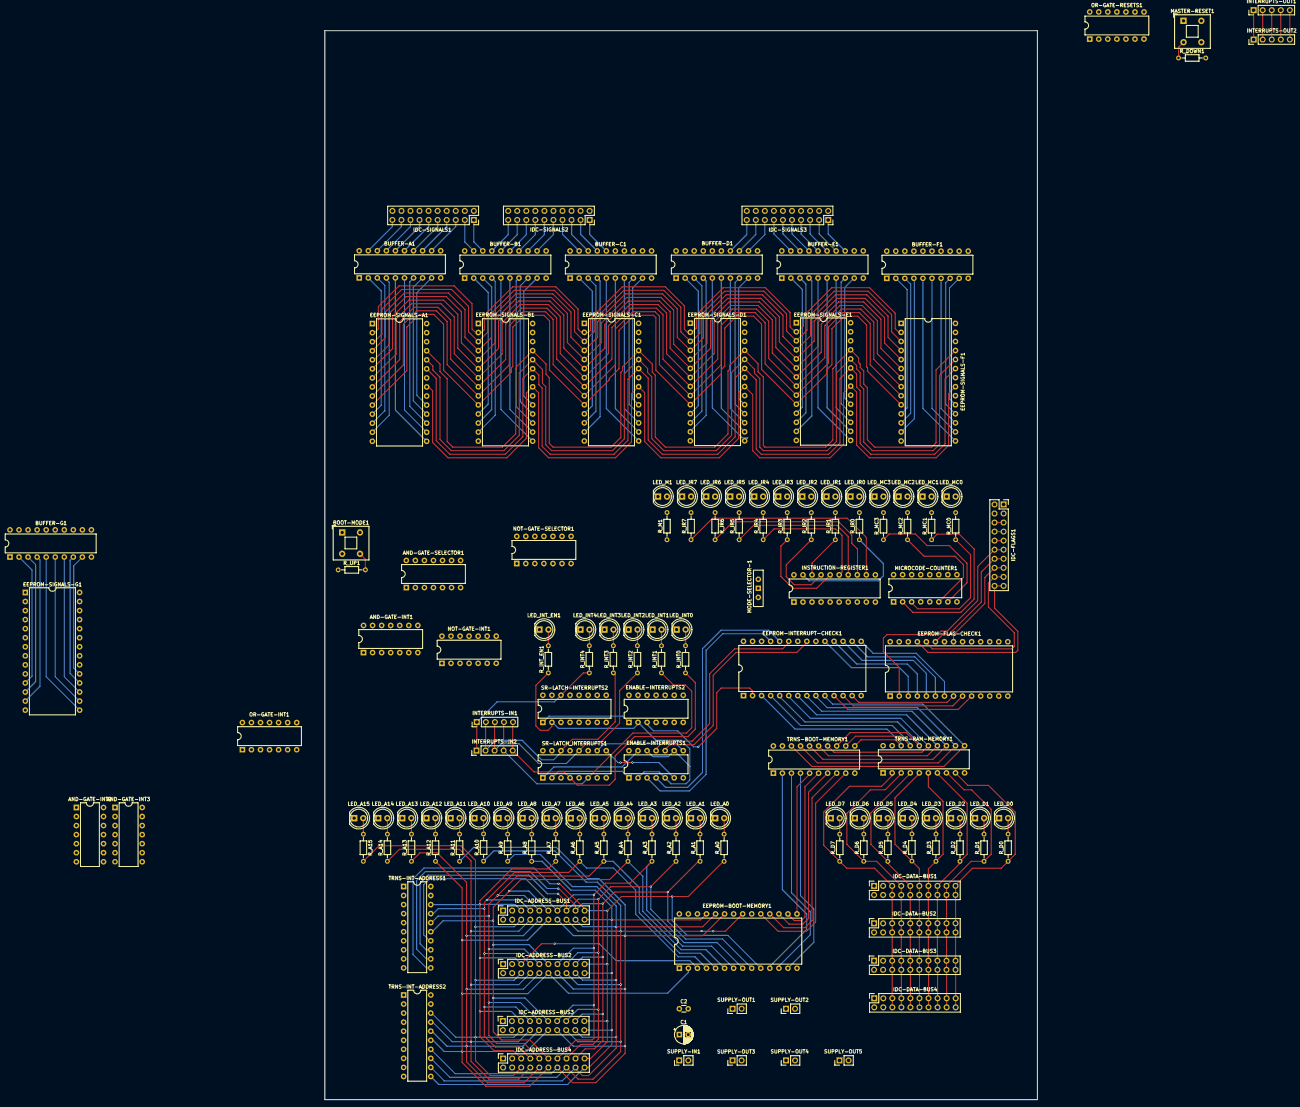
[picture p48: board final-cu.kicad_pcb from above]

Board: 2 copper layers, 200.0 x 300.0 mm, 150 parts (0 on the bottom side), 278 nets.
