KN-Breadboard-Computing/computer/schematics/final-memory/final-memory.kicad_pcb

## KiCad design schematics/final-memory/final-memory.kicad_pcb (2024-05-09)

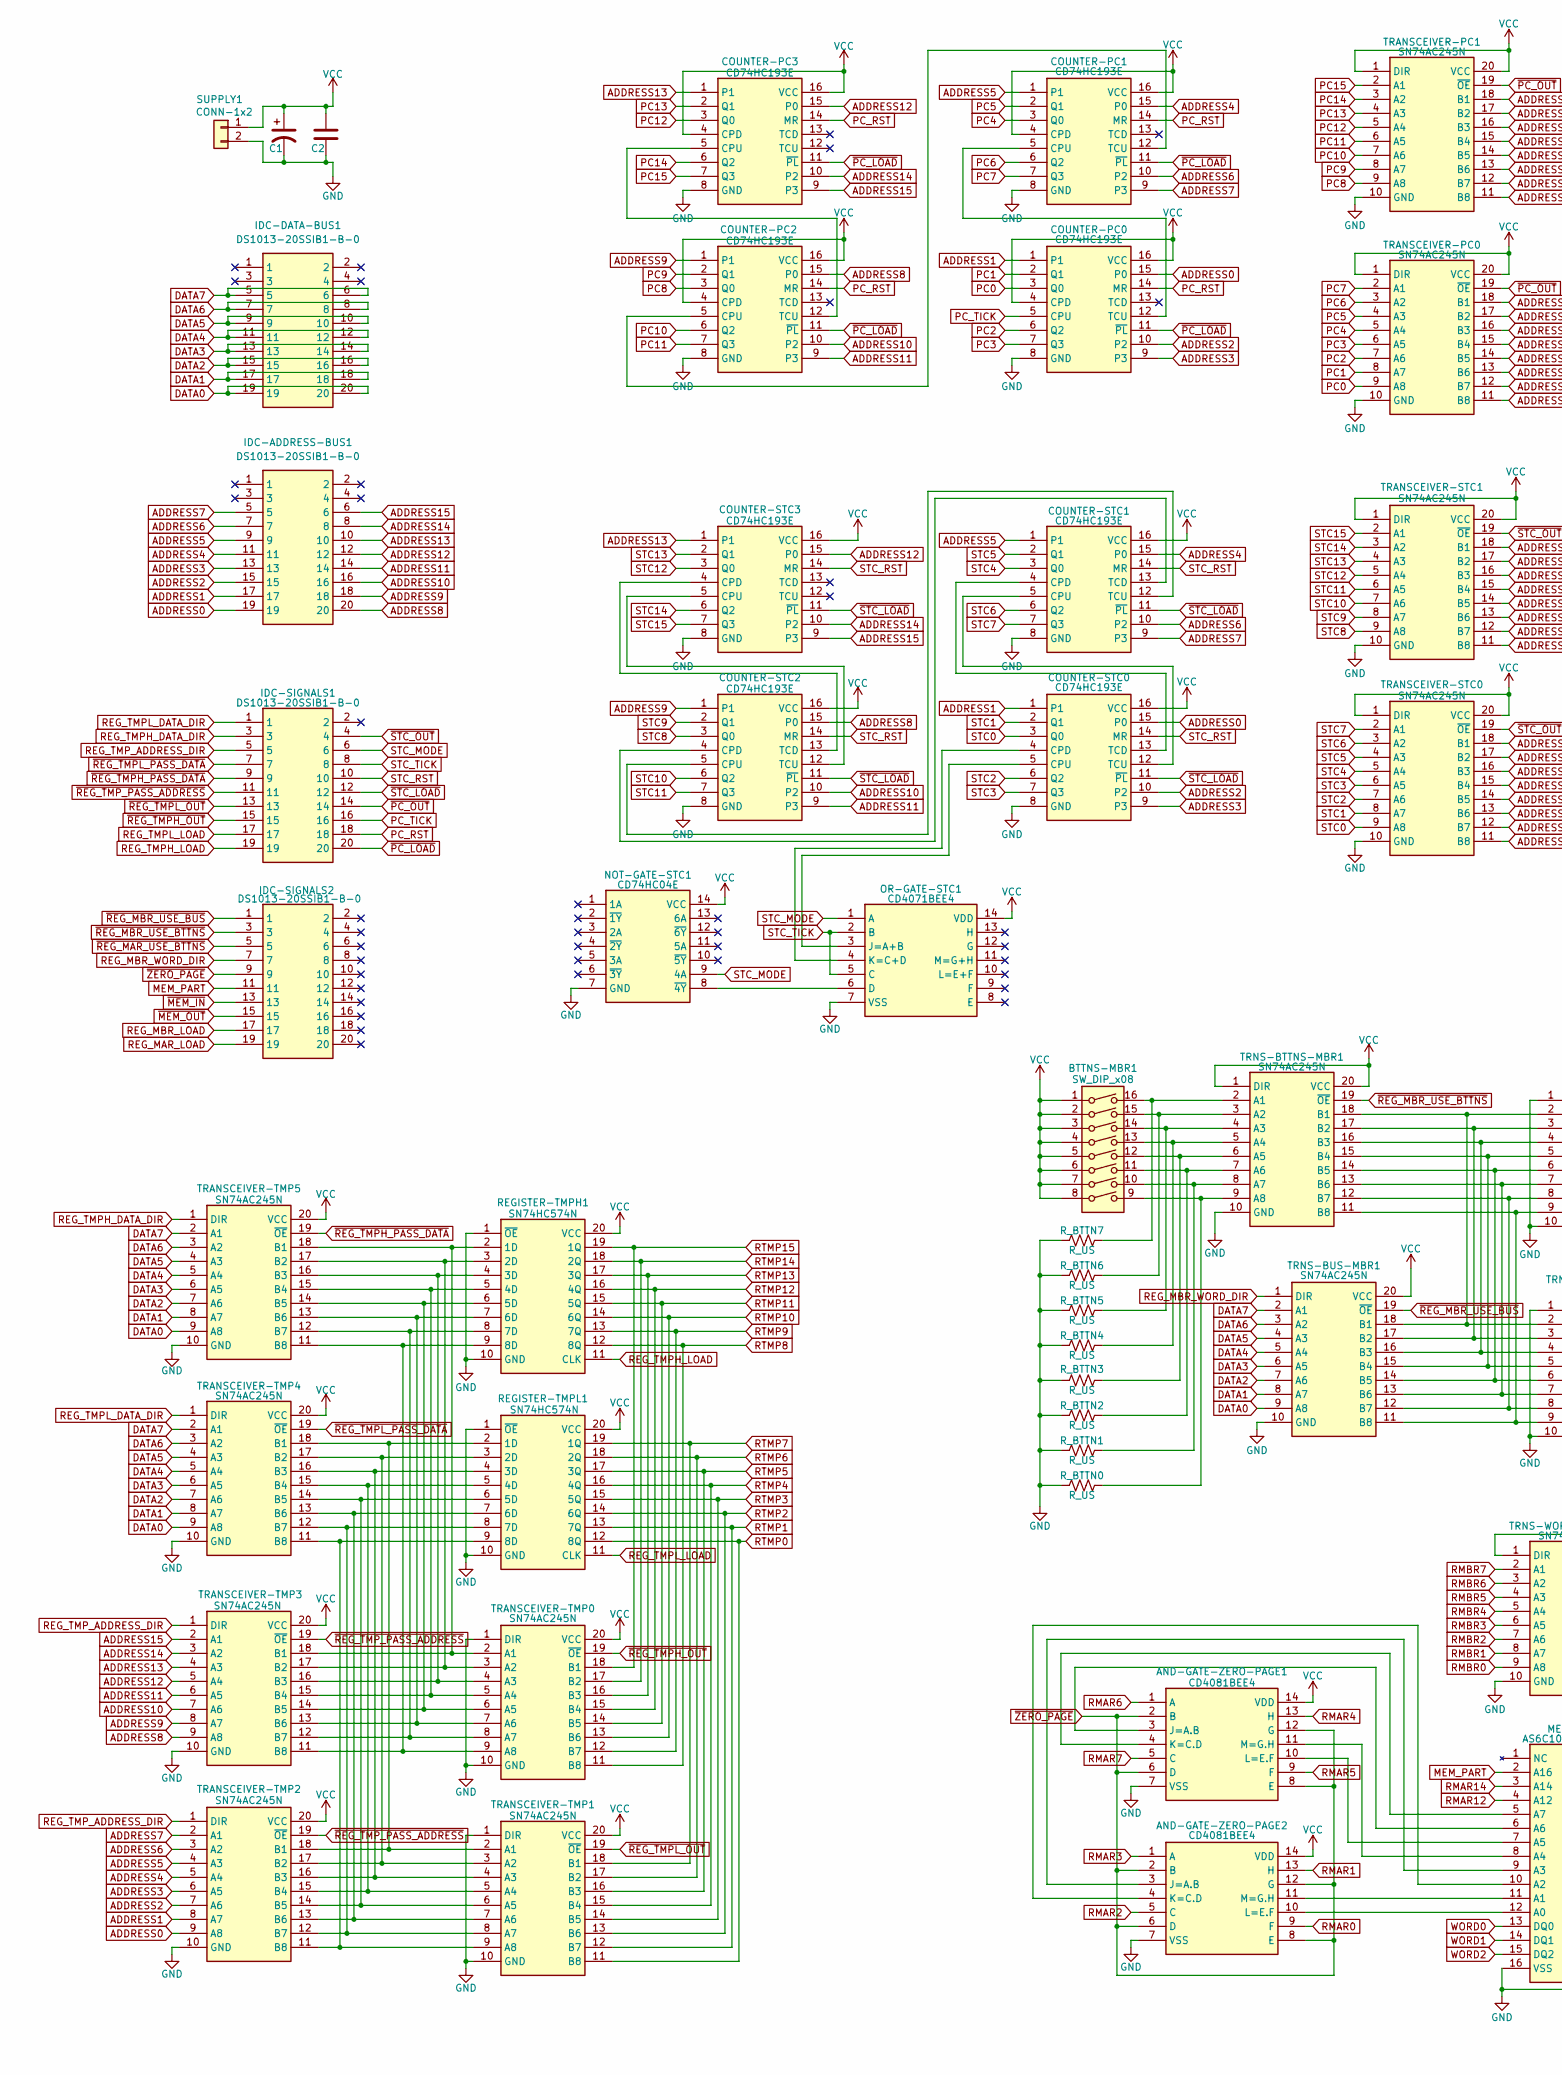
[picture p49: schematic final-memory.kicad_sch, part in row 1, column 1]

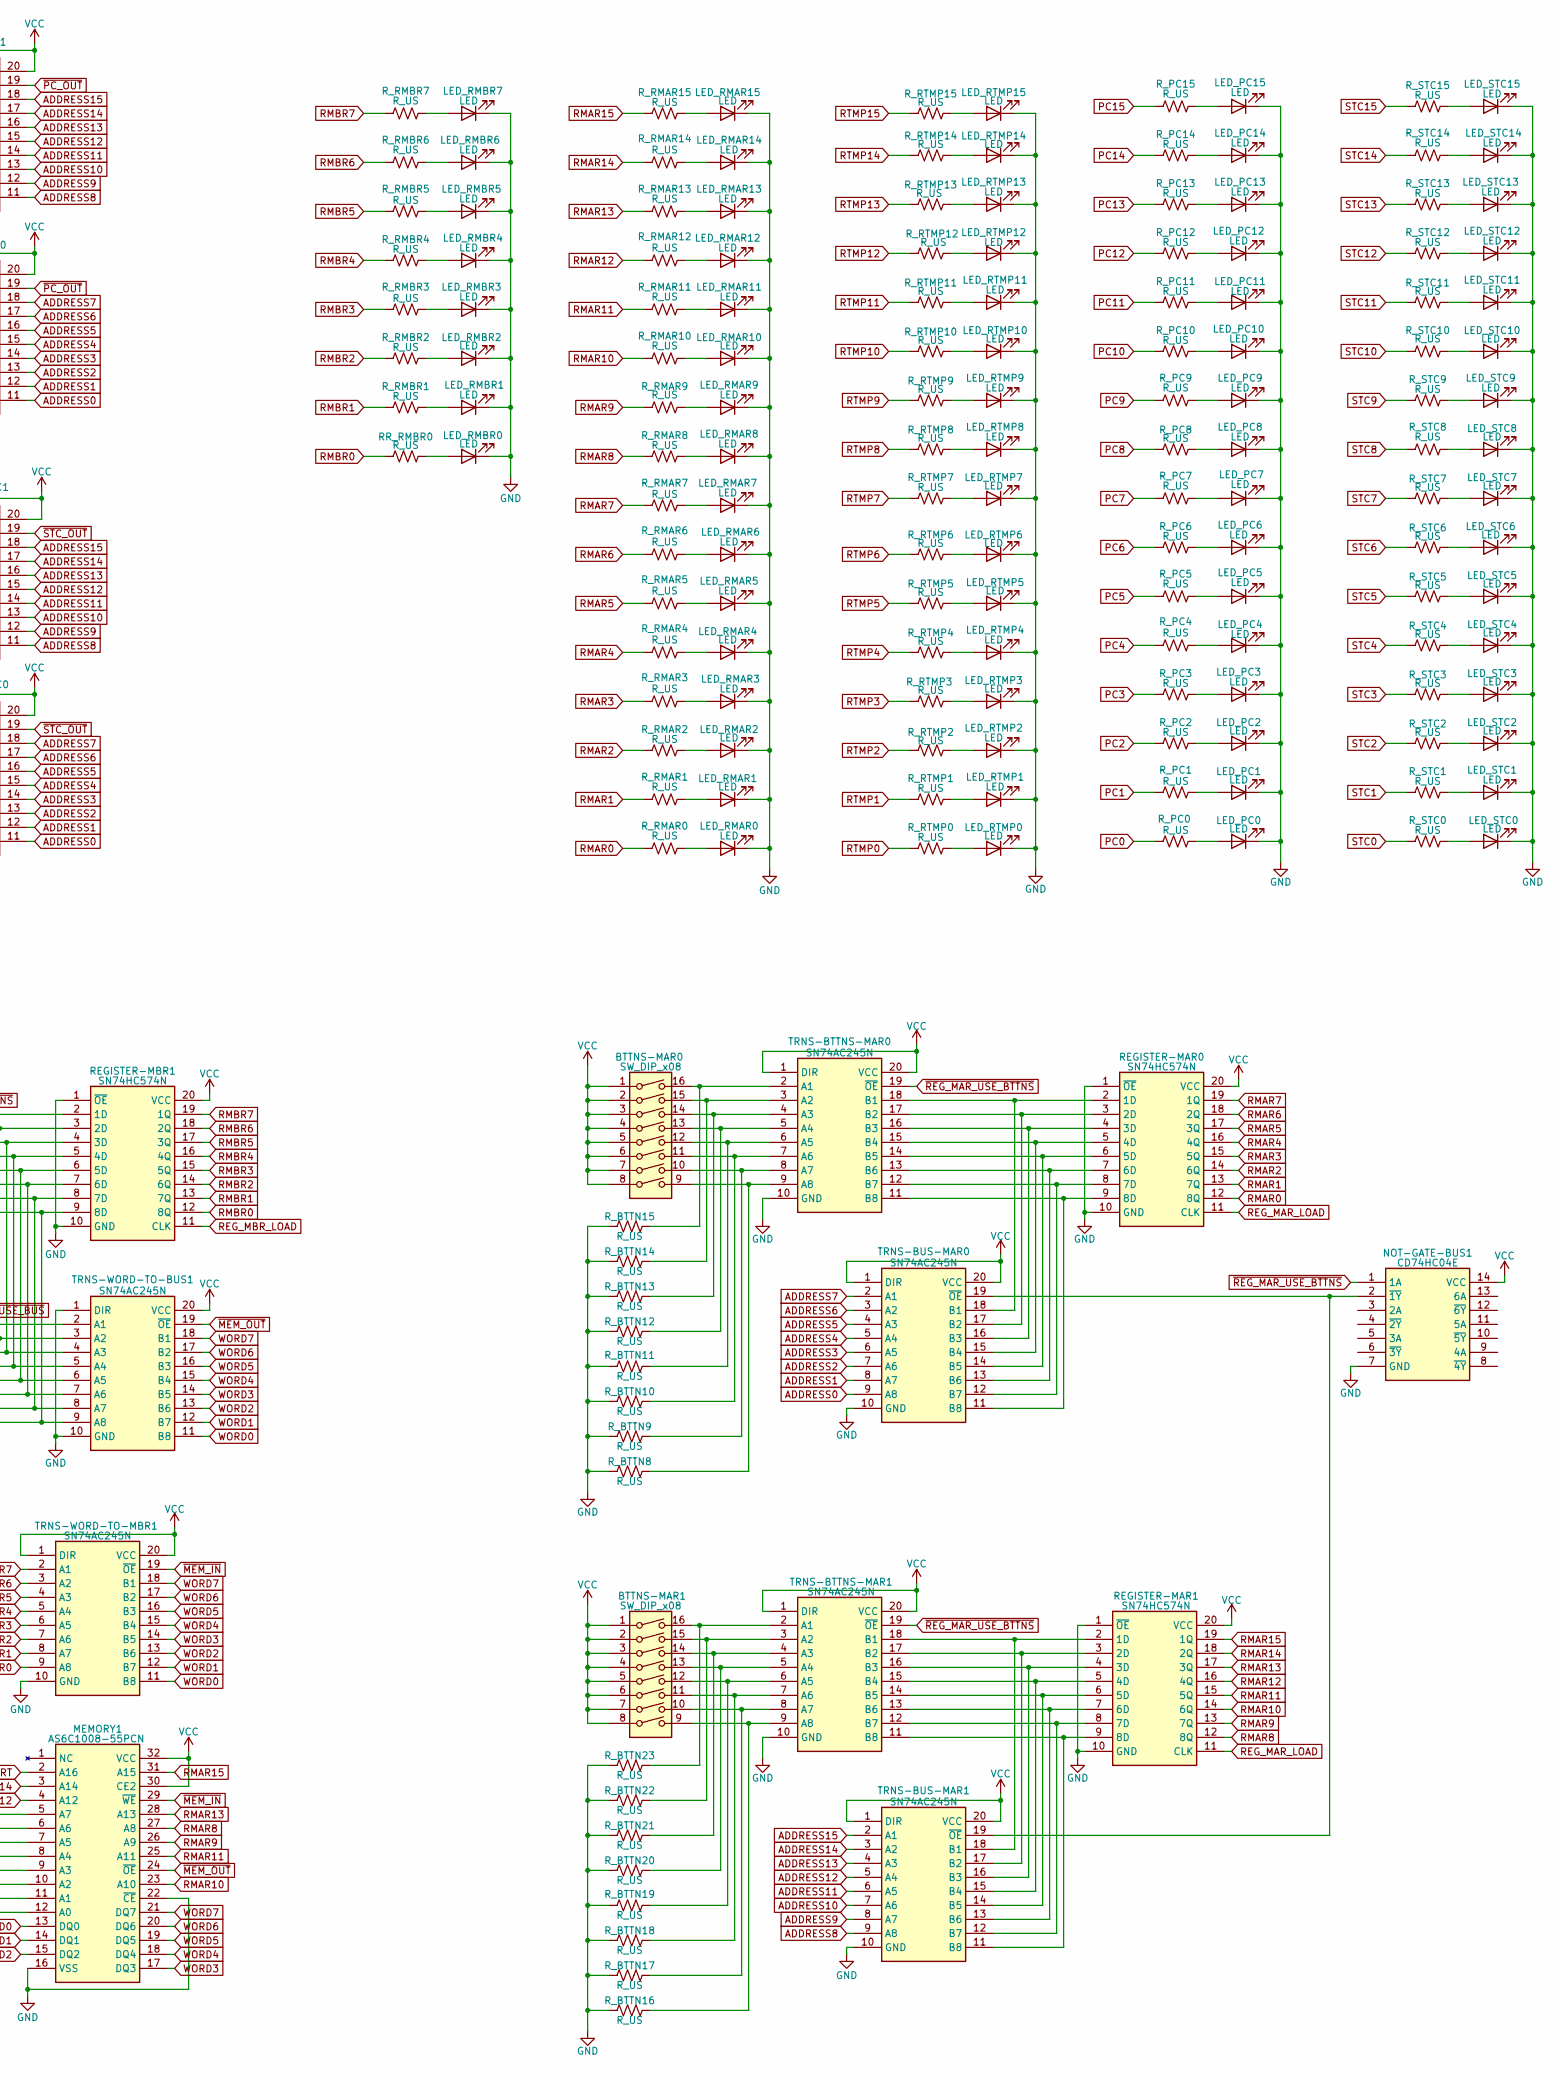
[picture p50: schematic final-memory.kicad_sch, part in row 1, column 2]

Parts:
AND-GATE-ZERO-PAGE1, AND-GATE-ZERO-PAGE2: CD4081BEE4; DIP-14_W7.62mm; Mouser Part Number 595-CD4081BEE4
BTTNS-MAR0, BTTNS-MAR1: SW_DIP_x08; SW_DIP_SPSTx08_Slide_6.7x21.88mm_W7.62mm_P2.54mm_LowProfile
BTTNS-MBR1: SW_DIP_x08; SW_DIP_SPSTx08_Slide_6.7x21.88mm_W7.62mm_P2.54mm_LowProfile
C1: C_Polarized_US; CP_Radial_D5.0mm_P2.50mm
C2: C; C_Disc_D3.0mm_W1.6mm_P2.50mm
COUNTER-PC0, COUNTER-PC1, COUNTER-PC2, COUNTER-PC3: CD74HC193E; DIP-16_W7.62mm; Mouser Part Number 595-CD74HC193E
COUNTER-STC0, COUNTER-STC1, COUNTER-STC2, COUNTER-STC3: CD74HC193E; DIP-16_W7.62mm; Mouser Part Number 595-CD74HC193E
IDC-ADDRESS-BUS1: DS1013-20SSIB1-B-0; PinSocket_2x10_P2.54mm_Vertical; Manufacturer_Part_Number DS1013-20SSIB1-B-0
IDC-DATA-BUS1: DS1013-20SSIB1-B-0; PinSocket_2x10_P2.54mm_Vertical; Manufacturer_Part_Number DS1013-20SSIB1-B-0
IDC-SIGNALS1, IDC-SIGNALS2: DS1013-20SSIB1-B-0; PinSocket_2x10_P2.54mm_Vertical; Manufacturer_Part_Number DS1013-20SSIB1-B-0
LED_PC0, LED_PC1, LED_PC2, LED_PC3, LED_PC4, LED_PC5, LED_PC6, LED_PC7, LED_PC8, LED_PC9, LED_PC10, LED_PC11, LED_PC12, LED_PC13, LED_PC14, LED_PC15: LED; LED_D5.0mm_FlatTop
LED_RMAR0, LED_RMAR1, LED_RMAR2, LED_RMAR3, LED_RMAR4, LED_RMAR5, LED_RMAR6, LED_RMAR7, LED_RMAR8, LED_RMAR9, LED_RMAR10, LED_RMAR11, LED_RMAR12, LED_RMAR13, LED_RMAR14, LED_RMAR15: LED; LED_D5.0mm_FlatTop
LED_RMBR0, LED_RMBR1, LED_RMBR2, LED_RMBR3, LED_RMBR4, LED_RMBR5, LED_RMBR6, LED_RMBR7: LED; LED_D5.0mm_FlatTop
LED_RTMP0, LED_RTMP1, LED_RTMP2, LED_RTMP3, LED_RTMP4, LED_RTMP5, LED_RTMP6, LED_RTMP7, LED_RTMP8, LED_RTMP9, LED_RTMP10, LED_RTMP11, LED_RTMP12, LED_RTMP13, LED_RTMP14, LED_RTMP15: LED; LED_D5.0mm_FlatTop
LED_STC0, LED_STC1, LED_STC2, LED_STC3, LED_STC4, LED_STC5, LED_STC6, LED_STC7, LED_STC8, LED_STC9, LED_STC10, LED_STC11, LED_STC12, LED_STC13, LED_STC14, LED_STC15: LED; LED_D5.0mm_FlatTop
MEMORY1: AS6C1008-55PCN; DIP-32_W15.24mm; Mouser Part Number 913-AS6C1008-55PCN
NOT-GATE-BUS1: CD74HC04E; DIP-14_W7.62mm; Mouser Part Number 595-CD74HC04E
NOT-GATE-STC1: CD74HC04E; DIP-14_W7.62mm; Mouser Part Number 595-CD74HC04E
OR-GATE-STC1: CD4071BEE4; DIP-14_W7.62mm; Mouser Part Number 595-CD4071BEE4
REGISTER-MAR0, REGISTER-MAR1: SN74HC574N; DIP-20_W7.62mm; Mouser Part Number 595-SN74HC574N
REGISTER-MBR1: SN74HC574N; DIP-20_W7.62mm; Mouser Part Number 595-SN74HC574N
REGISTER-TMPH1: SN74HC574N; DIP-20_W7.62mm; Mouser Part Number 595-SN74HC574N
REGISTER-TMPL1: SN74HC574N; DIP-20_W7.62mm; Mouser Part Number 595-SN74HC574N
RR_RMBR0: R_US; R_Axial_DIN0204_L3.6mm_D1.6mm_P7.62mm_Horizontal
R_BTTN0, R_BTTN1, R_BTTN2, R_BTTN3, R_BTTN4, R_BTTN5, R_BTTN6, R_BTTN7, R_BTTN8, R_BTTN9, R_BTTN10, R_BTTN11, R_BTTN12, R_BTTN13, R_BTTN14, R_BTTN15, R_BTTN16, R_BTTN17, R_BTTN18, R_BTTN19, R_BTTN20, R_BTTN21, R_BTTN22, R_BTTN23: R_US; R_Axial_DIN0204_L3.6mm_D1.6mm_P7.62mm_Horizontal
R_PC0, R_PC1, R_PC2, R_PC3, R_PC4, R_PC5, R_PC6, R_PC7, R_PC8, R_PC9, R_PC10, R_PC11, R_PC12, R_PC13, R_PC14, R_PC15: R_US; R_Axial_DIN0204_L3.6mm_D1.6mm_P7.62mm_Horizontal
R_RMAR0, R_RMAR1, R_RMAR2, R_RMAR3, R_RMAR4, R_RMAR5, R_RMAR6, R_RMAR7, R_RMAR8, R_RMAR9, R_RMAR10, R_RMAR11, R_RMAR12, R_RMAR13, R_RMAR14, R_RMAR15: R_US; R_Axial_DIN0204_L3.6mm_D1.6mm_P7.62mm_Horizontal
R_RMBR1, R_RMBR2, R_RMBR3, R_RMBR4, R_RMBR5, R_RMBR6, R_RMBR7: R_US; R_Axial_DIN0204_L3.6mm_D1.6mm_P7.62mm_Horizontal
R_RTMP0, R_RTMP1, R_RTMP2, R_RTMP3, R_RTMP4, R_RTMP5, R_RTMP6, R_RTMP7, R_RTMP8, R_RTMP9, R_RTMP10, R_RTMP11, R_RTMP12, R_RTMP13, R_RTMP14, R_RTMP15: R_US; R_Axial_DIN0204_L3.6mm_D1.6mm_P7.62mm_Horizontal
R_STC0, R_STC1, R_STC2, R_STC3, R_STC4, R_STC5, R_STC6, R_STC7, R_STC8, R_STC9, R_STC10, R_STC11, R_STC12, R_STC13, R_STC14, R_STC15: R_US; R_Axial_DIN0204_L3.6mm_D1.6mm_P7.62mm_Horizontal
SUPPLY1: CONN-1x2; PinHeader_1x02_P2.54mm_Vertical
TRANSCEIVER-PC0, TRANSCEIVER-PC1: SN74AC245N; DIP-20_W7.62mm; Mouser Part Number 595-SN74AC245N
TRANSCEIVER-STC0, TRANSCEIVER-STC1: SN74AC245N; DIP-20_W7.62mm; Mouser Part Number 595-SN74AC245N
TRANSCEIVER-TMP0, TRANSCEIVER-TMP1, TRANSCEIVER-TMP2, TRANSCEIVER-TMP3, TRANSCEIVER-TMP4, TRANSCEIVER-TMP5: SN74AC245N; DIP-20_W7.62mm; Mouser Part Number 595-SN74AC245N
TRNS-BTTNS-MAR0, TRNS-BTTNS-MAR1: SN74AC245N; DIP-20_W7.62mm; Mouser Part Number 595-SN74AC245N
TRNS-BTTNS-MBR1: SN74AC245N; DIP-20_W7.62mm; Mouser Part Number 595-SN74AC245N
TRNS-BUS-MAR0, TRNS-BUS-MAR1: SN74AC245N; DIP-20_W7.62mm; Mouser Part Number 595-SN74AC245N
TRNS-BUS-MBR1: SN74AC245N; DIP-20_W7.62mm; Mouser Part Number 595-SN74AC245N
TRNS-WORD-TO-BUS1: SN74AC245N; DIP-20_W7.62mm; Mouser Part Number 595-SN74AC245N
TRNS-WORD-TO-MBR1: SN74AC245N; DIP-20_W7.62mm; Mouser Part Number 595-SN74AC245N

Connections:
ADDRESS0: COUNTER-PC0.15 (P0), COUNTER-STC0.15 (P0), IDC-ADDRESS-BUS1.19, TRANSCEIVER-PC0.11 (B8), TRANSCEIVER-STC0.11 (B8), TRANSCEIVER-TMP2.9 (A8), TRNS-BUS-MAR0.9 (A8)
ADDRESS1: COUNTER-PC0.1, COUNTER-STC0.1, IDC-ADDRESS-BUS1.17, TRANSCEIVER-PC0.12 (B7), TRANSCEIVER-STC0.12 (B7), TRANSCEIVER-TMP2.8 (A7), TRNS-BUS-MAR0.8 (A7)
ADDRESS2: COUNTER-PC0.10 (P2), COUNTER-STC0.10 (P2), IDC-ADDRESS-BUS1.15, TRANSCEIVER-PC0.13 (B6), TRANSCEIVER-STC0.13 (B6), TRANSCEIVER-TMP2.7 (A6), TRNS-BUS-MAR0.7 (A6)
ADDRESS3: COUNTER-PC0.9 (P3), COUNTER-STC0.9 (P3), IDC-ADDRESS-BUS1.13, TRANSCEIVER-PC0.14 (B5), TRANSCEIVER-STC0.14 (B5), TRANSCEIVER-TMP2.6 (A5), TRNS-BUS-MAR0.6 (A5)
ADDRESS4: COUNTER-PC1.15 (P0), COUNTER-STC1.15 (P0), IDC-ADDRESS-BUS1.11, TRANSCEIVER-PC0.15 (B4), TRANSCEIVER-STC0.15 (B4), TRANSCEIVER-TMP2.5 (A4), TRNS-BUS-MAR0.5 (A4)
ADDRESS5: COUNTER-PC1.1, COUNTER-STC1.1, IDC-ADDRESS-BUS1.9, TRANSCEIVER-PC0.16 (B3), TRANSCEIVER-STC0.16 (B3), TRANSCEIVER-TMP2.4 (A3), TRNS-BUS-MAR0.4 (A3)
ADDRESS6: COUNTER-PC1.10 (P2), COUNTER-STC1.10 (P2), IDC-ADDRESS-BUS1.7, TRANSCEIVER-PC0.17 (B2), TRANSCEIVER-STC0.17 (B2), TRANSCEIVER-TMP2.3 (A2), TRNS-BUS-MAR0.3 (A2)
ADDRESS7: COUNTER-PC1.9 (P3), COUNTER-STC1.9 (P3), IDC-ADDRESS-BUS1.5, TRANSCEIVER-PC0.18 (B1), TRANSCEIVER-STC0.18 (B1), TRANSCEIVER-TMP2.2 (A1), TRNS-BUS-MAR0.2 (A1)
ADDRESS8: COUNTER-PC2.15 (P0), COUNTER-STC2.15 (P0), IDC-ADDRESS-BUS1.20, TRANSCEIVER-PC1.11 (B8), TRANSCEIVER-STC1.11 (B8), TRANSCEIVER-TMP3.9 (A8), TRNS-BUS-MAR1.9 (A8)
ADDRESS9: COUNTER-PC2.1, COUNTER-STC2.1, IDC-ADDRESS-BUS1.18, TRANSCEIVER-PC1.12 (B7), TRANSCEIVER-STC1.12 (B7), TRANSCEIVER-TMP3.8 (A7), TRNS-BUS-MAR1.8 (A7)
ADDRESS10: COUNTER-PC2.10 (P2), COUNTER-STC2.10 (P2), IDC-ADDRESS-BUS1.16, TRANSCEIVER-PC1.13 (B6), TRANSCEIVER-STC1.13 (B6), TRANSCEIVER-TMP3.7 (A6), TRNS-BUS-MAR1.7 (A6)
ADDRESS11: COUNTER-PC2.9 (P3), COUNTER-STC2.9 (P3), IDC-ADDRESS-BUS1.14, TRANSCEIVER-PC1.14 (B5), TRANSCEIVER-STC1.14 (B5), TRANSCEIVER-TMP3.6 (A5), TRNS-BUS-MAR1.6 (A5)
ADDRESS12: COUNTER-PC3.15 (P0), COUNTER-STC3.15 (P0), IDC-ADDRESS-BUS1.12, TRANSCEIVER-PC1.15 (B4), TRANSCEIVER-STC1.15 (B4), TRANSCEIVER-TMP3.5 (A4), TRNS-BUS-MAR1.5 (A4)
ADDRESS13: COUNTER-PC3.1, COUNTER-STC3.1, IDC-ADDRESS-BUS1.10, TRANSCEIVER-PC1.16 (B3), TRANSCEIVER-STC1.16 (B3), TRANSCEIVER-TMP3.4 (A3), TRNS-BUS-MAR1.4 (A3)
ADDRESS14: COUNTER-PC3.10 (P2), COUNTER-STC3.10 (P2), IDC-ADDRESS-BUS1.8, TRANSCEIVER-PC1.17 (B2), TRANSCEIVER-STC1.17 (B2), TRANSCEIVER-TMP3.3 (A2), TRNS-BUS-MAR1.3 (A2)
ADDRESS15: COUNTER-PC3.9 (P3), COUNTER-STC3.9 (P3), IDC-ADDRESS-BUS1.6, TRANSCEIVER-PC1.18 (B1), TRANSCEIVER-STC1.18 (B1), TRANSCEIVER-TMP3.2 (A1), TRNS-BUS-MAR1.2 (A1)
DATA0: IDC-DATA-BUS1.19, IDC-DATA-BUS1.20, TRANSCEIVER-TMP4.9 (A8), TRANSCEIVER-TMP5.9 (A8), TRNS-BUS-MBR1.9 (A8)
DATA1: IDC-DATA-BUS1.17, IDC-DATA-BUS1.18, TRANSCEIVER-TMP4.8 (A7), TRANSCEIVER-TMP5.8 (A7), TRNS-BUS-MBR1.8 (A7)
DATA2: IDC-DATA-BUS1.15, IDC-DATA-BUS1.16, TRANSCEIVER-TMP4.7 (A6), TRANSCEIVER-TMP5.7 (A6), TRNS-BUS-MBR1.7 (A6)
DATA3: IDC-DATA-BUS1.13, IDC-DATA-BUS1.14, TRANSCEIVER-TMP4.6 (A5), TRANSCEIVER-TMP5.6 (A5), TRNS-BUS-MBR1.6 (A5)
DATA4: IDC-DATA-BUS1.11, IDC-DATA-BUS1.12, TRANSCEIVER-TMP4.5 (A4), TRANSCEIVER-TMP5.5 (A4), TRNS-BUS-MBR1.5 (A4)
DATA5: IDC-DATA-BUS1.9, IDC-DATA-BUS1.10, TRANSCEIVER-TMP4.4 (A3), TRANSCEIVER-TMP5.4 (A3), TRNS-BUS-MBR1.4 (A3)
DATA6: IDC-DATA-BUS1.7, IDC-DATA-BUS1.8, TRANSCEIVER-TMP4.3 (A2), TRANSCEIVER-TMP5.3 (A2), TRNS-BUS-MBR1.3 (A2)
DATA7: IDC-DATA-BUS1.5, IDC-DATA-BUS1.6, TRANSCEIVER-TMP4.2 (A1), TRANSCEIVER-TMP5.2 (A1), TRNS-BUS-MBR1.2 (A1)
GND: AND-GATE-ZERO-PAGE1.7 (VSS), AND-GATE-ZERO-PAGE2.7 (VSS), C1.2, C2.2, COUNTER-PC0.8 (GND), COUNTER-PC1.8 (GND), COUNTER-PC2.8 (GND), COUNTER-PC3.8 (GND), COUNTER-STC0.8 (GND), COUNTER-STC1.8 (GND), COUNTER-STC2.8 (GND), COUNTER-STC3.8 (GND), LED_PC0.1 (K), LED_PC1.1 (K), LED_PC2.1 (K), LED_PC3.1 (K), LED_PC4.1 (K), LED_PC5.1 (K), LED_PC6.1 (K), LED_PC7.1 (K), LED_PC8.1 (K), LED_PC9.1 (K), LED_PC10.1 (K), LED_PC11.1 (K), LED_PC12.1 (K), LED_PC13.1 (K), LED_PC14.1 (K), LED_PC15.1 (K), LED_RMAR0.1 (K), LED_RMAR1.1 (K), LED_RMAR2.1 (K), LED_RMAR3.1 (K), LED_RMAR4.1 (K), LED_RMAR5.1 (K), LED_RMAR6.1 (K), LED_RMAR7.1 (K), LED_RMAR8.1 (K), LED_RMAR9.1 (K), LED_RMAR10.1 (K), LED_RMAR11.1 (K), LED_RMAR12.1 (K), LED_RMAR13.1 (K), LED_RMAR14.1 (K), LED_RMAR15.1 (K), LED_RMBR0.1 (K), LED_RMBR1.1 (K), LED_RMBR2.1 (K), LED_RMBR3.1 (K), LED_RMBR4.1 (K), LED_RMBR5.1 (K), LED_RMBR6.1 (K), LED_RMBR7.1 (K), LED_RTMP0.1 (K), LED_RTMP1.1 (K), LED_RTMP2.1 (K), LED_RTMP3.1 (K), LED_RTMP4.1 (K), LED_RTMP5.1 (K), LED_RTMP6.1 (K), LED_RTMP7.1 (K), LED_RTMP8.1 (K), LED_RTMP9.1 (K), LED_RTMP10.1 (K), LED_RTMP11.1 (K), LED_RTMP12.1 (K), LED_RTMP13.1 (K), LED_RTMP14.1 (K), LED_RTMP15.1 (K), LED_STC0.1 (K), LED_STC1.1 (K), LED_STC2.1 (K), LED_STC3.1 (K), LED_STC4.1 (K), LED_STC5.1 (K), LED_STC6.1 (K), LED_STC7.1 (K), LED_STC8.1 (K), LED_STC9.1 (K), LED_STC10.1 (K), LED_STC11.1 (K), LED_STC12.1 (K), LED_STC13.1 (K), LED_STC14.1 (K), LED_STC15.1 (K), MEMORY1.16 (VSS), MEMORY1.22 (~CE), NOT-GATE-BUS1.7 (GND), NOT-GATE-STC1.7 (GND), OR-GATE-STC1.7 (VSS), REGISTER-MAR0.1 (~OE), REGISTER-MAR0.10 (GND), REGISTER-MAR1.1 (~OE), REGISTER-MAR1.10 (GND), REGISTER-MBR1.1 (~OE), REGISTER-MBR1.10 (GND), REGISTER-TMPH1.1 (~OE), REGISTER-TMPH1.10 (GND), REGISTER-TMPL1.1 (~OE), REGISTER-TMPL1.10 (GND), R_BTTN0.1, R_BTTN1.1, R_BTTN2.1, R_BTTN3.1, R_BTTN4.1, R_BTTN5.1, R_BTTN6.1, R_BTTN7.1, R_BTTN8.1, R_BTTN9.1, R_BTTN10.1, R_BTTN11.1, R_BTTN12.1, R_BTTN13.1, R_BTTN14.1, R_BTTN15.1, R_BTTN16.1, R_BTTN17.1, R_BTTN18.1, R_BTTN19.1, R_BTTN20.1, R_BTTN21.1, R_BTTN22.1, R_BTTN23.1, SUPPLY1.2, TRANSCEIVER-PC0.10 (GND), TRANSCEIVER-PC1.10 (GND), TRANSCEIVER-STC0.10 (GND), TRANSCEIVER-STC1.10 (GND), TRANSCEIVER-TMP0.1 (DIR), TRANSCEIVER-TMP0.10 (GND), TRANSCEIVER-TMP1.1 (DIR), TRANSCEIVER-TMP1.10 (GND), TRANSCEIVER-TMP2.10 (GND), TRANSCEIVER-TMP3.10 (GND), TRANSCEIVER-TMP4.10 (GND), TRANSCEIVER-TMP5.10 (GND), TRNS-BTTNS-MAR0.10 (GND), TRNS-BTTNS-MAR1.10 (GND), TRNS-BTTNS-MBR1.10 (GND), TRNS-BUS-MAR0.10 (GND), TRNS-BUS-MAR1.10 (GND), TRNS-BUS-MBR1.10 (GND), TRNS-WORD-TO-BUS1.1 (DIR), TRNS-WORD-TO-BUS1.10 (GND), TRNS-WORD-TO-MBR1.10 (GND)
MEM_PART: IDC-SIGNALS2.11, MEMORY1.2 (A16)
unnamed: AND-GATE-ZERO-PAGE1.3 (J=A.B), MEMORY1.6 (A6)
unnamed: AND-GATE-ZERO-PAGE1.4 (K=C.D), MEMORY1.5 (A7)
unnamed: AND-GATE-ZERO-PAGE1.10 (L=E.F), MEMORY1.7 (A5)
unnamed: AND-GATE-ZERO-PAGE1.11 (M=G.H), MEMORY1.8 (A4)
unnamed: AND-GATE-ZERO-PAGE2.3 (J=A.B), MEMORY1.9 (A3)
unnamed: AND-GATE-ZERO-PAGE2.4 (K=C.D), MEMORY1.10 (A2)
unnamed: AND-GATE-ZERO-PAGE2.10 (L=E.F), MEMORY1.12 (A0)
unnamed: AND-GATE-ZERO-PAGE2.11 (M=G.H), MEMORY1.11 (A1)
unnamed: COUNTER-PC0.12 (TCU), COUNTER-PC1.5 (CPU)
unnamed: COUNTER-PC1.12 (TCU), COUNTER-PC2.5 (CPU)
unnamed: COUNTER-PC2.12 (TCU), COUNTER-PC3.5 (CPU)
unnamed: COUNTER-STC0.4 (CPD), OR-GATE-STC1.4 (K=C+D)
unnamed: COUNTER-STC0.5 (CPU), OR-GATE-STC1.3 (J=A+B)
unnamed: COUNTER-STC0.13 (TCD), COUNTER-STC1.4 (CPD)
unnamed: COUNTER-STC0.12 (TCU), COUNTER-STC1.5 (CPU)
unnamed: COUNTER-STC1.13 (TCD), COUNTER-STC2.4 (CPD)
unnamed: COUNTER-STC1.12 (TCU), COUNTER-STC2.5 (CPU)
unnamed: COUNTER-STC2.13 (TCD), COUNTER-STC3.4 (CPD)
unnamed: COUNTER-STC2.12 (TCU), COUNTER-STC3.5 (CPU)
unnamed: LED_PC0.2 (A), R_PC0.2
unnamed: LED_PC1.2 (A), R_PC1.2
unnamed: LED_PC2.2 (A), R_PC2.2
unnamed: LED_PC3.2 (A), R_PC3.2
unnamed: LED_PC4.2 (A), R_PC4.2
unnamed: LED_PC5.2 (A), R_PC5.2
unnamed: LED_PC6.2 (A), R_PC6.2
unnamed: LED_PC7.2 (A), R_PC7.2
unnamed: LED_PC8.2 (A), R_PC8.2
unnamed: LED_PC9.2 (A), R_PC9.2
unnamed: LED_PC10.2 (A), R_PC10.2
unnamed: LED_PC11.2 (A), R_PC11.2
unnamed: LED_PC12.2 (A), R_PC12.2
unnamed: LED_PC13.2 (A), R_PC13.2
unnamed: LED_PC14.2 (A), R_PC14.2
unnamed: LED_PC15.2 (A), R_PC15.2
unnamed: LED_RMAR0.2 (A), R_RMAR0.2
unnamed: LED_RMAR1.2 (A), R_RMAR1.2
unnamed: LED_RMAR2.2 (A), R_RMAR2.2
unnamed: LED_RMAR3.2 (A), R_RMAR3.2
unnamed: LED_RMAR4.2 (A), R_RMAR4.2
unnamed: LED_RMAR5.2 (A), R_RMAR5.2
unnamed: LED_RMAR6.2 (A), R_RMAR6.2
unnamed: LED_RMAR7.2 (A), R_RMAR7.2
unnamed: LED_RMAR8.2 (A), R_RMAR8.2
unnamed: LED_RMAR9.2 (A), R_RMAR9.2
unnamed: LED_RMAR10.2 (A), R_RMAR10.2
unnamed: LED_RMAR11.2 (A), R_RMAR11.2
unnamed: LED_RMAR12.2 (A), R_RMAR12.2
unnamed: LED_RMAR13.2 (A), R_RMAR13.2
unnamed: LED_RMAR14.2 (A), R_RMAR14.2
unnamed: LED_RMAR15.2 (A), R_RMAR15.2
unnamed: LED_RMBR0.2 (A), RR_RMBR0.2
unnamed: LED_RMBR1.2 (A), R_RMBR1.2
unnamed: LED_RMBR2.2 (A), R_RMBR2.2
unnamed: LED_RMBR3.2 (A), R_RMBR3.2
unnamed: LED_RMBR4.2 (A), R_RMBR4.2
unnamed: LED_RMBR5.2 (A), R_RMBR5.2
unnamed: LED_RMBR6.2 (A), R_RMBR6.2
unnamed: LED_RMBR7.2 (A), R_RMBR7.2
unnamed: LED_RTMP0.2 (A), R_RTMP0.2
unnamed: LED_RTMP1.2 (A), R_RTMP1.2
unnamed: LED_RTMP2.2 (A), R_RTMP2.2
unnamed: LED_RTMP3.2 (A), R_RTMP3.2
unnamed: LED_RTMP4.2 (A), R_RTMP4.2
unnamed: LED_RTMP5.2 (A), R_RTMP5.2
unnamed: LED_RTMP6.2 (A), R_RTMP6.2
unnamed: LED_RTMP7.2 (A), R_RTMP7.2
unnamed: LED_RTMP8.2 (A), R_RTMP8.2
unnamed: LED_RTMP9.2 (A), R_RTMP9.2
unnamed: LED_RTMP10.2 (A), R_RTMP10.2
unnamed: LED_RTMP11.2 (A), R_RTMP11.2
unnamed: LED_RTMP12.2 (A), R_RTMP12.2
unnamed: LED_RTMP13.2 (A), R_RTMP13.2
unnamed: LED_RTMP14.2 (A), R_RTMP14.2
unnamed: LED_RTMP15.2 (A), R_RTMP15.2
unnamed: LED_STC0.2 (A), R_STC0.2
unnamed: LED_STC1.2 (A), R_STC1.2
unnamed: LED_STC2.2 (A), R_STC2.2
unnamed: LED_STC3.2 (A), R_STC3.2
unnamed: LED_STC4.2 (A), R_STC4.2
unnamed: LED_STC5.2 (A), R_STC5.2
unnamed: LED_STC6.2 (A), R_STC6.2
unnamed: LED_STC7.2 (A), R_STC7.2
unnamed: LED_STC8.2 (A), R_STC8.2
unnamed: LED_STC9.2 (A), R_STC9.2
unnamed: LED_STC10.2 (A), R_STC10.2
unnamed: LED_STC11.2 (A), R_STC11.2
unnamed: LED_STC12.2 (A), R_STC12.2
unnamed: LED_STC13.2 (A), R_STC13.2
unnamed: LED_STC14.2 (A), R_STC14.2
unnamed: LED_STC15.2 (A), R_STC15.2
unnamed: NOT-GATE-BUS1.2 (~1Y), TRNS-BUS-MAR0.19 (~OE), TRNS-BUS-MAR1.19 (~OE)
unnamed: NOT-GATE-STC1.8 (~4Y), OR-GATE-STC1.6 (D)
unnamed: REGISTER-MAR0.2 (1D), TRNS-BTTNS-MAR0.18 (B1), TRNS-BUS-MAR0.18 (B1)
unnamed: REGISTER-MAR0.3 (2D), TRNS-BTTNS-MAR0.17 (B2), TRNS-BUS-MAR0.17 (B2)
unnamed: REGISTER-MAR0.4 (3D), TRNS-BTTNS-MAR0.16 (B3), TRNS-BUS-MAR0.16 (B3)
unnamed: REGISTER-MAR0.5 (4D), TRNS-BTTNS-MAR0.15 (B4), TRNS-BUS-MAR0.15 (B4)
unnamed: REGISTER-MAR0.6 (5D), TRNS-BTTNS-MAR0.14 (B5), TRNS-BUS-MAR0.14 (B5)
unnamed: REGISTER-MAR0.7 (6D), TRNS-BTTNS-MAR0.13 (B6), TRNS-BUS-MAR0.13 (B6)
unnamed: REGISTER-MAR0.8 (7D), TRNS-BTTNS-MAR0.12 (B7), TRNS-BUS-MAR0.12 (B7)
unnamed: REGISTER-MAR0.9 (8D), TRNS-BTTNS-MAR0.11 (B8), TRNS-BUS-MAR0.11 (B8)
unnamed: REGISTER-MAR1.2 (1D), TRNS-BTTNS-MAR1.18 (B1), TRNS-BUS-MAR1.18 (B1)
unnamed: REGISTER-MAR1.3 (2D), TRNS-BTTNS-MAR1.17 (B2), TRNS-BUS-MAR1.17 (B2)
unnamed: REGISTER-MAR1.4 (3D), TRNS-BTTNS-MAR1.16 (B3), TRNS-BUS-MAR1.16 (B3)
unnamed: REGISTER-MAR1.5 (4D), TRNS-BTTNS-MAR1.15 (B4), TRNS-BUS-MAR1.15 (B4)
unnamed: REGISTER-MAR1.6 (5D), TRNS-BTTNS-MAR1.14 (B5), TRNS-BUS-MAR1.14 (B5)
unnamed: REGISTER-MAR1.7 (6D), TRNS-BTTNS-MAR1.13 (B6), TRNS-BUS-MAR1.13 (B6)
unnamed: REGISTER-MAR1.8 (7D), TRNS-BTTNS-MAR1.12 (B7), TRNS-BUS-MAR1.12 (B7)
unnamed: REGISTER-MAR1.9 (8D), TRNS-BTTNS-MAR1.11 (B8), TRNS-BUS-MAR1.11 (B8)
unnamed: REGISTER-MBR1.2 (1D), TRNS-BTTNS-MBR1.18 (B1), TRNS-BUS-MBR1.18 (B1), TRNS-WORD-TO-BUS1.2 (A1)
unnamed: REGISTER-MBR1.3 (2D), TRNS-BTTNS-MBR1.17 (B2), TRNS-BUS-MBR1.17 (B2), TRNS-WORD-TO-BUS1.3 (A2)
unnamed: REGISTER-MBR1.4 (3D), TRNS-BTTNS-MBR1.16 (B3), TRNS-BUS-MBR1.16 (B3), TRNS-WORD-TO-BUS1.4 (A3)
unnamed: REGISTER-MBR1.5 (4D), TRNS-BTTNS-MBR1.15 (B4), TRNS-BUS-MBR1.15 (B4), TRNS-WORD-TO-BUS1.5 (A4)
unnamed: REGISTER-MBR1.6 (5D), TRNS-BTTNS-MBR1.14 (B5), TRNS-BUS-MBR1.14 (B5), TRNS-WORD-TO-BUS1.6 (A5)
unnamed: REGISTER-MBR1.7 (6D), TRNS-BTTNS-MBR1.13 (B6), TRNS-BUS-MBR1.13 (B6), TRNS-WORD-TO-BUS1.7 (A6)
unnamed: REGISTER-MBR1.8 (7D), TRNS-BTTNS-MBR1.12 (B7), TRNS-BUS-MBR1.12 (B7), TRNS-WORD-TO-BUS1.8 (A7)
unnamed: REGISTER-MBR1.9 (8D), TRNS-BTTNS-MBR1.11 (B8), TRNS-BUS-MBR1.11 (B8), TRNS-WORD-TO-BUS1.9 (A8)
unnamed: REGISTER-TMPH1.2 (1D), TRANSCEIVER-TMP0.2 (A1), TRANSCEIVER-TMP3.18 (B1), TRANSCEIVER-TMP5.18 (B1)
unnamed: REGISTER-TMPH1.3 (2D), TRANSCEIVER-TMP0.3 (A2), TRANSCEIVER-TMP3.17 (B2), TRANSCEIVER-TMP5.17 (B2)
unnamed: REGISTER-TMPH1.4 (3D), TRANSCEIVER-TMP0.4 (A3), TRANSCEIVER-TMP3.16 (B3), TRANSCEIVER-TMP5.16 (B3)
unnamed: REGISTER-TMPH1.5 (4D), TRANSCEIVER-TMP0.5 (A4), TRANSCEIVER-TMP3.15 (B4), TRANSCEIVER-TMP5.15 (B4)
unnamed: REGISTER-TMPH1.6 (5D), TRANSCEIVER-TMP0.6 (A5), TRANSCEIVER-TMP3.14 (B5), TRANSCEIVER-TMP5.14 (B5)
unnamed: REGISTER-TMPH1.7 (6D), TRANSCEIVER-TMP0.7 (A6), TRANSCEIVER-TMP3.13 (B6), TRANSCEIVER-TMP5.13 (B6)
unnamed: REGISTER-TMPH1.8 (7D), TRANSCEIVER-TMP0.8 (A7), TRANSCEIVER-TMP3.12 (B7), TRANSCEIVER-TMP5.12 (B7)
unnamed: REGISTER-TMPH1.9 (8D), TRANSCEIVER-TMP0.9 (A8), TRANSCEIVER-TMP3.11 (B8), TRANSCEIVER-TMP5.11 (B8)
unnamed: REGISTER-TMPL1.2 (1D), TRANSCEIVER-TMP1.2 (A1), TRANSCEIVER-TMP2.18 (B1), TRANSCEIVER-TMP4.18 (B1)
unnamed: REGISTER-TMPL1.3 (2D), TRANSCEIVER-TMP1.3 (A2), TRANSCEIVER-TMP2.17 (B2), TRANSCEIVER-TMP4.17 (B2)
unnamed: REGISTER-TMPL1.4 (3D), TRANSCEIVER-TMP1.4 (A3), TRANSCEIVER-TMP2.16 (B3), TRANSCEIVER-TMP4.16 (B3)
unnamed: REGISTER-TMPL1.5 (4D), TRANSCEIVER-TMP1.5 (A4), TRANSCEIVER-TMP2.15 (B4), TRANSCEIVER-TMP4.15 (B4)
unnamed: REGISTER-TMPL1.6 (5D), TRANSCEIVER-TMP1.6 (A5), TRANSCEIVER-TMP2.14 (B5), TRANSCEIVER-TMP4.14 (B5)
unnamed: REGISTER-TMPL1.7 (6D), TRANSCEIVER-TMP1.7 (A6), TRANSCEIVER-TMP2.13 (B6), TRANSCEIVER-TMP4.13 (B6)
unnamed: REGISTER-TMPL1.8 (7D), TRANSCEIVER-TMP1.8 (A7), TRANSCEIVER-TMP2.12 (B7), TRANSCEIVER-TMP4.12 (B7)
unnamed: REGISTER-TMPL1.9 (8D), TRANSCEIVER-TMP1.9 (A8), TRANSCEIVER-TMP2.11 (B8), TRANSCEIVER-TMP4.11 (B8)
unnamed: BTTNS-MAR0.16, R_BTTN15.2, TRNS-BTTNS-MAR0.2 (A1)
unnamed: BTTNS-MAR0.15, R_BTTN14.2, TRNS-BTTNS-MAR0.3 (A2)
unnamed: BTTNS-MAR0.14, R_BTTN13.2, TRNS-BTTNS-MAR0.4 (A3)
unnamed: BTTNS-MAR0.13, R_BTTN12.2, TRNS-BTTNS-MAR0.5 (A4)
unnamed: BTTNS-MAR0.12, R_BTTN11.2, TRNS-BTTNS-MAR0.6 (A5)
unnamed: BTTNS-MAR0.11, R_BTTN10.2, TRNS-BTTNS-MAR0.7 (A6)
unnamed: BTTNS-MAR0.10, R_BTTN9.2, TRNS-BTTNS-MAR0.8 (A7)
unnamed: BTTNS-MAR0.9, R_BTTN8.2, TRNS-BTTNS-MAR0.9 (A8)
unnamed: BTTNS-MAR1.16, R_BTTN23.2, TRNS-BTTNS-MAR1.2 (A1)
unnamed: BTTNS-MAR1.15, R_BTTN22.2, TRNS-BTTNS-MAR1.3 (A2)
unnamed: BTTNS-MAR1.14, R_BTTN21.2, TRNS-BTTNS-MAR1.4 (A3)
unnamed: BTTNS-MAR1.13, R_BTTN20.2, TRNS-BTTNS-MAR1.5 (A4)
unnamed: BTTNS-MAR1.12, R_BTTN19.2, TRNS-BTTNS-MAR1.6 (A5)
unnamed: BTTNS-MAR1.11, R_BTTN18.2, TRNS-BTTNS-MAR1.7 (A6)
unnamed: BTTNS-MAR1.10, R_BTTN17.2, TRNS-BTTNS-MAR1.8 (A7)
unnamed: BTTNS-MAR1.9, R_BTTN16.2, TRNS-BTTNS-MAR1.9 (A8)
unnamed: BTTNS-MBR1.16, R_BTTN7.2, TRNS-BTTNS-MBR1.2 (A1)
unnamed: BTTNS-MBR1.15, R_BTTN6.2, TRNS-BTTNS-MBR1.3 (A2)
unnamed: BTTNS-MBR1.14, R_BTTN5.2, TRNS-BTTNS-MBR1.4 (A3)
unnamed: BTTNS-MBR1.13, R_BTTN4.2, TRNS-BTTNS-MBR1.5 (A4)
unnamed: BTTNS-MBR1.12, R_BTTN3.2, TRNS-BTTNS-MBR1.6 (A5)
unnamed: BTTNS-MBR1.11, R_BTTN2.2, TRNS-BTTNS-MBR1.7 (A6)
unnamed: BTTNS-MBR1.10, R_BTTN1.2, TRNS-BTTNS-MBR1.8 (A7)
unnamed: BTTNS-MBR1.9, R_BTTN0.2, TRNS-BTTNS-MBR1.9 (A8)
PC0: COUNTER-PC0.3 (Q0), R_PC0.1, TRANSCEIVER-PC0.9 (A8)
PC1: COUNTER-PC0.2 (Q1), R_PC1.1, TRANSCEIVER-PC0.8 (A7)
PC2: COUNTER-PC0.6 (Q2), R_PC2.1, TRANSCEIVER-PC0.7 (A6)
PC3: COUNTER-PC0.7 (Q3), R_PC3.1, TRANSCEIVER-PC0.6 (A5)
PC4: COUNTER-PC1.3 (Q0), R_PC4.1, TRANSCEIVER-PC0.5 (A4)
PC5: COUNTER-PC1.2 (Q1), R_PC5.1, TRANSCEIVER-PC0.4 (A3)
PC6: COUNTER-PC1.6 (Q2), R_PC6.1, TRANSCEIVER-PC0.3 (A2)
PC7: COUNTER-PC1.7 (Q3), R_PC7.1, TRANSCEIVER-PC0.2 (A1)
PC8: COUNTER-PC2.3 (Q0), R_PC8.1, TRANSCEIVER-PC1.9 (A8)
PC9: COUNTER-PC2.2 (Q1), R_PC9.1, TRANSCEIVER-PC1.8 (A7)
PC10: COUNTER-PC2.6 (Q2), R_PC10.1, TRANSCEIVER-PC1.7 (A6)
PC11: COUNTER-PC2.7 (Q3), R_PC11.1, TRANSCEIVER-PC1.6 (A5)
PC12: COUNTER-PC3.3 (Q0), R_PC12.1, TRANSCEIVER-PC1.5 (A4)
PC13: COUNTER-PC3.2 (Q1), R_PC13.1, TRANSCEIVER-PC1.4 (A3)
PC14: COUNTER-PC3.6 (Q2), R_PC14.1, TRANSCEIVER-PC1.3 (A2)
PC15: COUNTER-PC3.7 (Q3), R_PC15.1, TRANSCEIVER-PC1.2 (A1)
PC_RST: COUNTER-PC0.14 (MR), COUNTER-PC1.14 (MR), COUNTER-PC2.14 (MR), COUNTER-PC3.14 (MR), IDC-SIGNALS1.18
PC_TICK: COUNTER-PC0.5 (CPU), IDC-SIGNALS1.16
REG_MAR_LOAD: IDC-SIGNALS2.19, REGISTER-MAR0.11 (CLK), REGISTER-MAR1.11 (CLK)
REG_MBR_LOAD: IDC-SIGNALS2.17, REGISTER-MBR1.11 (CLK)
REG_MBR_WORD_DIR: IDC-SIGNALS2.7, TRNS-BUS-MBR1.1 (DIR)
REG_TMPH_DATA_DIR: IDC-SIGNALS1.3, TRANSCEIVER-TMP5.1 (DIR)
REG_TMPH_LOAD: IDC-SIGNALS1.19, REGISTER-TMPH1.11 (CLK)
REG_TMPL_DATA_DIR: IDC-SIGNALS1.1, TRANSCEIVER-TMP4.1 (DIR)
REG_TMPL_LOAD: IDC-SIGNALS1.17, REGISTER-TMPL1.11 (CLK)
REG_TMP_ADDRESS_DIR: IDC-SIGNALS1.5, TRANSCEIVER-TMP2.1 (DIR), TRANSCEIVER-TMP3.1 (DIR)
RMAR0: AND-GATE-ZERO-PAGE2.9 (F), REGISTER-MAR0.12 (8Q), R_RMAR0.1
RMAR1: AND-GATE-ZERO-PAGE2.13 (H), REGISTER-MAR0.13 (7Q), R_RMAR1.1
RMAR2: AND-GATE-ZERO-PAGE2.5 (C), REGISTER-MAR0.14 (6Q), R_RMAR2.1
RMAR3: AND-GATE-ZERO-PAGE2.1 (A), REGISTER-MAR0.15 (5Q), R_RMAR3.1
RMAR4: AND-GATE-ZERO-PAGE1.13 (H), REGISTER-MAR0.16 (4Q), R_RMAR4.1
RMAR5: AND-GATE-ZERO-PAGE1.9 (F), REGISTER-MAR0.17 (3Q), R_RMAR5.1
RMAR6: AND-GATE-ZERO-PAGE1.1 (A), REGISTER-MAR0.18 (2Q), R_RMAR6.1
RMAR7: AND-GATE-ZERO-PAGE1.5 (C), REGISTER-MAR0.19 (1Q), R_RMAR7.1
RMAR8: MEMORY1.27 (A8), REGISTER-MAR1.12 (8Q), R_RMAR8.1
RMAR9: MEMORY1.26 (A9), REGISTER-MAR1.13 (7Q), R_RMAR9.1
RMAR10: MEMORY1.23 (A10), REGISTER-MAR1.14 (6Q), R_RMAR10.1
RMAR11: MEMORY1.25 (A11), REGISTER-MAR1.15 (5Q), R_RMAR11.1
RMAR12: MEMORY1.4 (A12), REGISTER-MAR1.16 (4Q), R_RMAR12.1
RMAR13: MEMORY1.28 (A13), REGISTER-MAR1.17 (3Q), R_RMAR13.1
RMAR14: MEMORY1.3 (A14), REGISTER-MAR1.18 (2Q), R_RMAR14.1
RMAR15: MEMORY1.31 (A15), REGISTER-MAR1.19 (1Q), R_RMAR15.1
RMBR0: REGISTER-MBR1.12 (8Q), RR_RMBR0.1, TRNS-WORD-TO-MBR1.9 (A8)
RMBR1: REGISTER-MBR1.13 (7Q), R_RMBR1.1, TRNS-WORD-TO-MBR1.8 (A7)
RMBR2: REGISTER-MBR1.14 (6Q), R_RMBR2.1, TRNS-WORD-TO-MBR1.7 (A6)
RMBR3: REGISTER-MBR1.15 (5Q), R_RMBR3.1, TRNS-WORD-TO-MBR1.6 (A5)
RMBR4: REGISTER-MBR1.16 (4Q), R_RMBR4.1, TRNS-WORD-TO-MBR1.5 (A4)
RMBR5: REGISTER-MBR1.17 (3Q), R_RMBR5.1, TRNS-WORD-TO-MBR1.4 (A3)
RMBR6: REGISTER-MBR1.18 (2Q), R_RMBR6.1, TRNS-WORD-TO-MBR1.3 (A2)
RMBR7: REGISTER-MBR1.19 (1Q), R_RMBR7.1, TRNS-WORD-TO-MBR1.2 (A1)
RTMP0: REGISTER-TMPL1.12 (8Q), R_RTMP0.1, TRANSCEIVER-TMP1.11 (B8)
RTMP1: REGISTER-TMPL1.13 (7Q), R_RTMP1.1, TRANSCEIVER-TMP1.12 (B7)
RTMP2: REGISTER-TMPL1.14 (6Q), R_RTMP2.1, TRANSCEIVER-TMP1.13 (B6)
RTMP3: REGISTER-TMPL1.15 (5Q), R_RTMP3.1, TRANSCEIVER-TMP1.14 (B5)
RTMP4: REGISTER-TMPL1.16 (4Q), R_RTMP4.1, TRANSCEIVER-TMP1.15 (B4)
RTMP5: REGISTER-TMPL1.17 (3Q), R_RTMP5.1, TRANSCEIVER-TMP1.16 (B3)
RTMP6: REGISTER-TMPL1.18 (2Q), R_RTMP6.1, TRANSCEIVER-TMP1.17 (B2)
RTMP7: REGISTER-TMPL1.19 (1Q), R_RTMP7.1, TRANSCEIVER-TMP1.18 (B1)
RTMP8: REGISTER-TMPH1.12 (8Q), R_RTMP8.1, TRANSCEIVER-TMP0.11 (B8)
RTMP9: REGISTER-TMPH1.13 (7Q), R_RTMP9.1, TRANSCEIVER-TMP0.12 (B7)
RTMP10: REGISTER-TMPH1.14 (6Q), R_RTMP10.1, TRANSCEIVER-TMP0.13 (B6)
RTMP11: REGISTER-TMPH1.15 (5Q), R_RTMP11.1, TRANSCEIVER-TMP0.14 (B5)
RTMP12: REGISTER-TMPH1.16 (4Q), R_RTMP12.1, TRANSCEIVER-TMP0.15 (B4)
RTMP13: REGISTER-TMPH1.17 (3Q), R_RTMP13.1, TRANSCEIVER-TMP0.16 (B3)
RTMP14: REGISTER-TMPH1.18 (2Q), R_RTMP14.1, TRANSCEIVER-TMP0.17 (B2)
RTMP15: REGISTER-TMPH1.19 (1Q), R_RTMP15.1, TRANSCEIVER-TMP0.18 (B1)
STC0: COUNTER-STC0.3 (Q0), R_STC0.1, TRANSCEIVER-STC0.9 (A8)
STC1: COUNTER-STC0.2 (Q1), R_STC1.1, TRANSCEIVER-STC0.8 (A7)
STC2: COUNTER-STC0.6 (Q2), R_STC2.1, TRANSCEIVER-STC0.7 (A6)
STC3: COUNTER-STC0.7 (Q3), R_STC3.1, TRANSCEIVER-STC0.6 (A5)
STC4: COUNTER-STC1.3 (Q0), R_STC4.1, TRANSCEIVER-STC0.5 (A4)
STC5: COUNTER-STC1.2 (Q1), R_STC5.1, TRANSCEIVER-STC0.4 (A3)
STC6: COUNTER-STC1.6 (Q2), R_STC6.1, TRANSCEIVER-STC0.3 (A2)
STC7: COUNTER-STC1.7 (Q3), R_STC7.1, TRANSCEIVER-STC0.2 (A1)
STC8: COUNTER-STC2.3 (Q0), R_STC8.1, TRANSCEIVER-STC1.9 (A8)
STC9: COUNTER-STC2.2 (Q1), R_STC9.1, TRANSCEIVER-STC1.8 (A7)
STC10: COUNTER-STC2.6 (Q2), R_STC10.1, TRANSCEIVER-STC1.7 (A6)
STC11: COUNTER-STC2.7 (Q3), R_STC11.1, TRANSCEIVER-STC1.6 (A5)
STC12: COUNTER-STC3.3 (Q0), R_STC12.1, TRANSCEIVER-STC1.5 (A4)
STC13: COUNTER-STC3.2 (Q1), R_STC13.1, TRANSCEIVER-STC1.4 (A3)
STC14: COUNTER-STC3.6 (Q2), R_STC14.1, TRANSCEIVER-STC1.3 (A2)
STC15: COUNTER-STC3.7 (Q3), R_STC15.1, TRANSCEIVER-STC1.2 (A1)
STC_MODE: IDC-SIGNALS1.6, NOT-GATE-STC1.9 (4A), OR-GATE-STC1.1 (A)
STC_RST: COUNTER-STC0.14 (MR), COUNTER-STC1.14 (MR), COUNTER-STC2.14 (MR), COUNTER-STC3.14 (MR), IDC-SIGNALS1.10
STC_TICK: IDC-SIGNALS1.8, OR-GATE-STC1.2 (B), OR-GATE-STC1.5 (C)
VCC: AND-GATE-ZERO-PAGE1.14 (VDD), AND-GATE-ZERO-PAGE2.14 (VDD), BTTNS-MAR0.1, BTTNS-MAR0.2, BTTNS-MAR0.3, BTTNS-MAR0.4, BTTNS-MAR0.5, BTTNS-MAR0.6, BTTNS-MAR0.7, BTTNS-MAR0.8, BTTNS-MAR1.1, BTTNS-MAR1.2, BTTNS-MAR1.3, BTTNS-MAR1.4, BTTNS-MAR1.5, BTTNS-MAR1.6, BTTNS-MAR1.7, BTTNS-MAR1.8, BTTNS-MBR1.1, BTTNS-MBR1.2, BTTNS-MBR1.3, BTTNS-MBR1.4, BTTNS-MBR1.5, BTTNS-MBR1.6, BTTNS-MBR1.7, BTTNS-MBR1.8, C1.1, C2.1, COUNTER-PC0.4 (CPD), COUNTER-PC0.16 (VCC), COUNTER-PC1.4 (CPD), COUNTER-PC1.16 (VCC), COUNTER-PC2.4 (CPD), COUNTER-PC2.16 (VCC), COUNTER-PC3.4 (CPD), COUNTER-PC3.16 (VCC), COUNTER-STC0.16 (VCC), COUNTER-STC1.16 (VCC), COUNTER-STC2.16 (VCC), COUNTER-STC3.16 (VCC), MEMORY1.30 (CE2), MEMORY1.32 (VCC), NOT-GATE-BUS1.14 (VCC), NOT-GATE-STC1.14 (VCC), OR-GATE-STC1.14 (VDD), REGISTER-MAR0.20 (VCC), REGISTER-MAR1.20 (VCC), REGISTER-MBR1.20 (VCC), REGISTER-TMPH1.20 (VCC), REGISTER-TMPL1.20 (VCC), SUPPLY1.1, TRANSCEIVER-PC0.1 (DIR), TRANSCEIVER-PC0.20 (VCC), TRANSCEIVER-PC1.1 (DIR), TRANSCEIVER-PC1.20 (VCC), TRANSCEIVER-STC0.1 (DIR), TRANSCEIVER-STC0.20 (VCC), TRANSCEIVER-STC1.1 (DIR), TRANSCEIVER-STC1.20 (VCC), TRANSCEIVER-TMP0.20 (VCC), TRANSCEIVER-TMP1.20 (VCC), TRANSCEIVER-TMP2.20 (VCC), TRANSCEIVER-TMP3.20 (VCC), TRANSCEIVER-TMP4.20 (VCC), TRANSCEIVER-TMP5.20 (VCC), TRNS-BTTNS-MAR0.1 (DIR), TRNS-BTTNS-MAR0.20 (VCC), TRNS-BTTNS-MAR1.1 (DIR), TRNS-BTTNS-MAR1.20 (VCC), TRNS-BTTNS-MBR1.1 (DIR), TRNS-BTTNS-MBR1.20 (VCC), TRNS-BUS-MAR0.1 (DIR), TRNS-BUS-MAR0.20 (VCC), TRNS-BUS-MAR1.1 (DIR), TRNS-BUS-MAR1.20 (VCC), TRNS-BUS-MBR1.20 (VCC), TRNS-WORD-TO-BUS1.20 (VCC), TRNS-WORD-TO-MBR1.1 (DIR), TRNS-WORD-TO-MBR1.20 (VCC)
WORD0: MEMORY1.13 (DQ0), TRNS-WORD-TO-BUS1.11 (B8), TRNS-WORD-TO-MBR1.11 (B8)
WORD1: MEMORY1.14 (DQ1), TRNS-WORD-TO-BUS1.12 (B7), TRNS-WORD-TO-MBR1.12 (B7)
WORD2: MEMORY1.15 (DQ2), TRNS-WORD-TO-BUS1.13 (B6), TRNS-WORD-TO-MBR1.13 (B6)
WORD3: MEMORY1.17 (DQ3), TRNS-WORD-TO-BUS1.14 (B5), TRNS-WORD-TO-MBR1.14 (B5)
WORD4: MEMORY1.18 (DQ4), TRNS-WORD-TO-BUS1.15 (B4), TRNS-WORD-TO-MBR1.15 (B4)
WORD5: MEMORY1.19 (DQ5), TRNS-WORD-TO-BUS1.16 (B3), TRNS-WORD-TO-MBR1.16 (B3)
WORD6: MEMORY1.20 (DQ6), TRNS-WORD-TO-BUS1.17 (B2), TRNS-WORD-TO-MBR1.17 (B2)
WORD7: MEMORY1.21 (DQ7), TRNS-WORD-TO-BUS1.18 (B1), TRNS-WORD-TO-MBR1.18 (B1)
~MEM_IN: IDC-SIGNALS2.13, MEMORY1.29 (~WE), TRNS-WORD-TO-MBR1.19 (~OE)
~MEM_OUT: IDC-SIGNALS2.15, MEMORY1.24 (~OE), TRNS-WORD-TO-BUS1.19 (~OE)
~PC_LOAD: COUNTER-PC0.11 (~PL), COUNTER-PC1.11 (~PL), COUNTER-PC2.11 (~PL), COUNTER-PC3.11 (~PL), IDC-SIGNALS1.20
~PC_OUT: IDC-SIGNALS1.14, TRANSCEIVER-PC0.19 (~OE), TRANSCEIVER-PC1.19 (~OE)
~REG_MAR_USE_BTTNS: IDC-SIGNALS2.5, NOT-GATE-BUS1.1 (1A), TRNS-BTTNS-MAR0.19 (~OE), TRNS-BTTNS-MAR1.19 (~OE)
~REG_MBR_USE_BTTNS: IDC-SIGNALS2.3, TRNS-BTTNS-MBR1.19 (~OE)
~REG_MBR_USE_BUS: IDC-SIGNALS2.1, TRNS-BUS-MBR1.19 (~OE)
~REG_TMPH_OUT: IDC-SIGNALS1.15, TRANSCEIVER-TMP0.19 (~OE)
~REG_TMPH_PASS_DATA: IDC-SIGNALS1.9, TRANSCEIVER-TMP5.19 (~OE)
~REG_TMPL_OUT: IDC-SIGNALS1.13, TRANSCEIVER-TMP1.19 (~OE)
~REG_TMPL_PASS_DATA: IDC-SIGNALS1.7, TRANSCEIVER-TMP4.19 (~OE)
~REG_TMP_PASS_ADDRESS: IDC-SIGNALS1.11, TRANSCEIVER-TMP2.19 (~OE), TRANSCEIVER-TMP3.19 (~OE)
~STC_LOAD: COUNTER-STC0.11 (~PL), COUNTER-STC1.11 (~PL), COUNTER-STC2.11 (~PL), COUNTER-STC3.11 (~PL), IDC-SIGNALS1.12
~STC_OUT: IDC-SIGNALS1.4, TRANSCEIVER-STC0.19 (~OE), TRANSCEIVER-STC1.19 (~OE)
~ZERO_PAGE: AND-GATE-ZERO-PAGE1.2 (B), AND-GATE-ZERO-PAGE1.6 (D), AND-GATE-ZERO-PAGE1.8 (E), AND-GATE-ZERO-PAGE1.12 (G), AND-GATE-ZERO-PAGE2.2 (B), AND-GATE-ZERO-PAGE2.6 (D), AND-GATE-ZERO-PAGE2.8 (E), AND-GATE-ZERO-PAGE2.12 (G), IDC-SIGNALS2.9

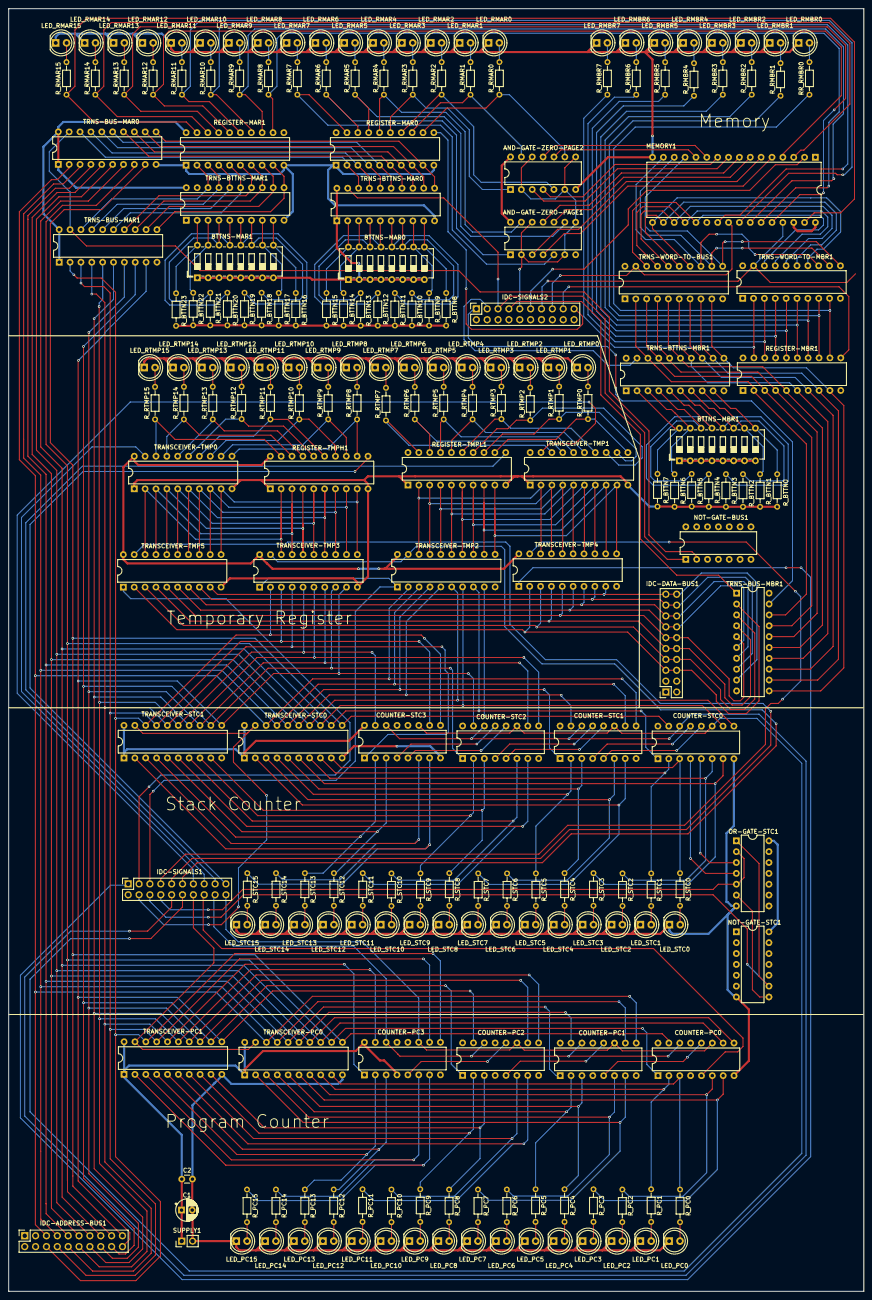
[picture p51: board final-memory.kicad_pcb from above]

Board: 2 copper layers, 200.0 x 300.0 mm, 215 parts (0 on the bottom side), 292 nets.
