KN-Breadboard-Computing/computer/schematics/program-counter/program-counter.kicad_pcb

## KiCad design schematics/program-counter/program-counter.kicad_pcb (2023-07-06)

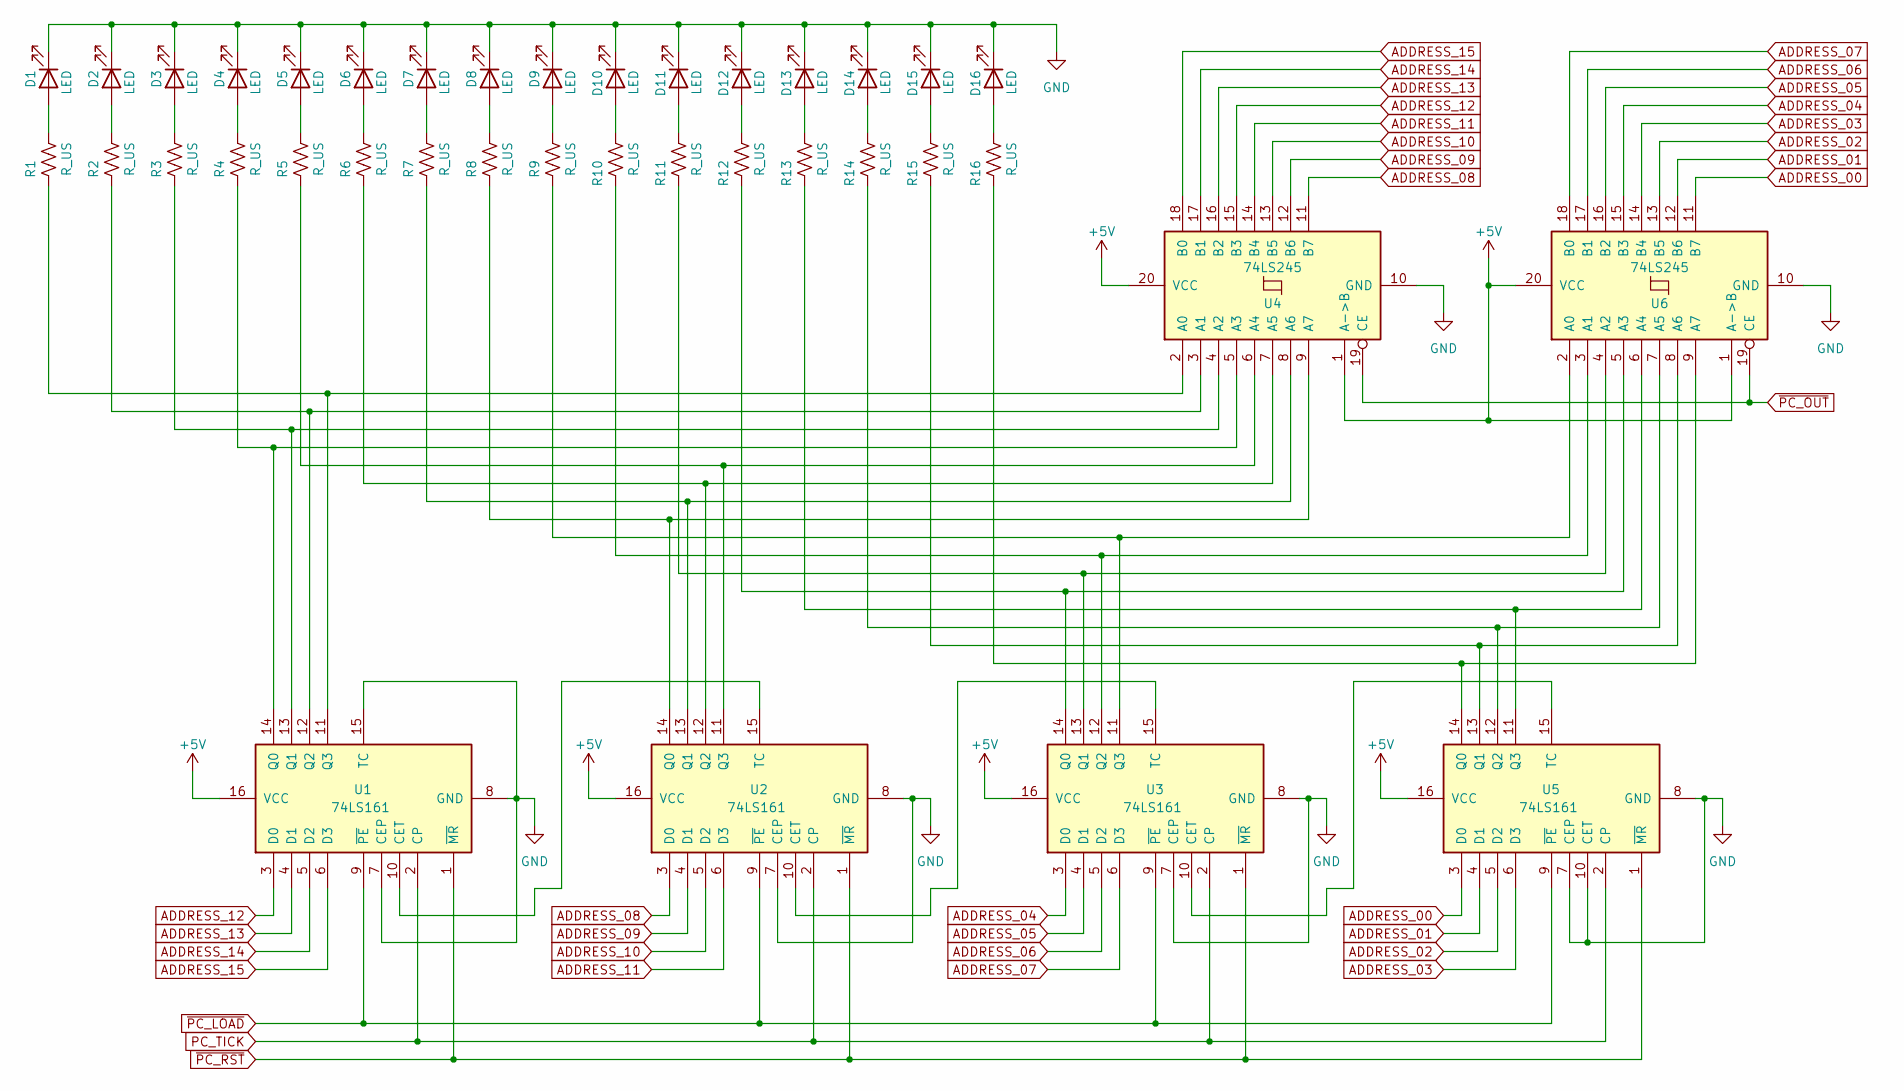
[picture p52: schematic program-counter.kicad_sch]

Parts:
D1, D2, D3, D4, D5, D6, D7, D8, D9, D10, D11, D12, D13, D14, D15, D16: LED; LED_D3.0mm
R1, R2, R3, R4, R5, R6, R7, R8, R9, R10, R11, R12, R13, R14, R15, R16: R_US; R_Axial_DIN0207_L6.3mm_D2.5mm_P10.16mm_Horizontal
U1, U2, U3, U5: 74LS161; DIP-16_W7.62mm_LongPads
U4, U6: 74LS245; DIP-20_W7.62mm_LongPads

Connections:
+5V: U1.16 (VCC), U2.16 (VCC), U3.16 (VCC), U4.1 (A->B), U4.20 (VCC), U5.16 (VCC), U6.1 (A->B), U6.20 (VCC)
ADDRESS_00: U5.3 (D0), U6.11 (B7)
ADDRESS_01: U5.4 (D1), U6.12 (B6)
ADDRESS_02: U5.5 (D2), U6.13 (B5)
ADDRESS_03: U5.6 (D3), U6.14 (B4)
ADDRESS_04: U3.3 (D0), U6.15 (B3)
ADDRESS_05: U3.4 (D1), U6.16 (B2)
ADDRESS_06: U3.5 (D2), U6.17 (B1)
ADDRESS_07: U3.6 (D3), U6.18 (B0)
ADDRESS_08: U2.3 (D0), U4.11 (B7)
ADDRESS_09: U2.4 (D1), U4.12 (B6)
ADDRESS_10: U2.5 (D2), U4.13 (B5)
ADDRESS_11: U2.6 (D3), U4.14 (B4)
ADDRESS_12: U1.3 (D0), U4.15 (B3)
ADDRESS_13: U1.4 (D1), U4.16 (B2)
ADDRESS_14: U1.5 (D2), U4.17 (B1)
ADDRESS_15: U1.6 (D3), U4.18 (B0)
GND: D1.1 (K), D2.1 (K), D3.1 (K), D4.1 (K), D5.1 (K), D6.1 (K), D7.1 (K), D8.1 (K), D9.1 (K), D10.1 (K), D11.1 (K), D12.1 (K), D13.1 (K), D14.1 (K), D15.1 (K), D16.1 (K), U1.7 (CEP), U1.8 (GND), U1.15 (TC), U2.7 (CEP), U2.8 (GND), U3.7 (CEP), U3.8 (GND), U4.10 (GND), U5.7 (CEP), U5.8 (GND), U5.10 (CET), U6.10 (GND)
unnamed: D1.2 (A), R1.2
unnamed: D2.2 (A), R2.2
unnamed: D3.2 (A), R3.2
unnamed: D4.2 (A), R4.2
unnamed: D5.2 (A), R5.2
unnamed: D6.2 (A), R6.2
unnamed: D7.2 (A), R7.2
unnamed: D8.2 (A), R8.2
unnamed: D9.2 (A), R9.2
unnamed: D10.2 (A), R10.2
unnamed: D11.2 (A), R11.2
unnamed: D12.2 (A), R12.2
unnamed: D13.2 (A), R13.2
unnamed: D14.2 (A), R14.2
unnamed: D15.2 (A), R15.2
unnamed: D16.2 (A), R16.2
unnamed: U1.10 (CET), U2.15 (TC)
unnamed: R4.1, U1.14 (Q0), U4.5 (A3)
unnamed: R3.1, U1.13 (Q1), U4.4 (A2)
unnamed: R2.1, U1.12 (Q2), U4.3 (A1)
unnamed: R1.1, U1.11 (Q3), U4.2 (A0)
unnamed: U2.10 (CET), U3.15 (TC)
unnamed: R8.1, U2.14 (Q0), U4.9 (A7)
unnamed: R7.1, U2.13 (Q1), U4.8 (A6)
unnamed: R6.1, U2.12 (Q2), U4.7 (A5)
unnamed: R5.1, U2.11 (Q3), U4.6 (A4)
unnamed: U3.10 (CET), U5.15 (TC)
unnamed: R12.1, U3.14 (Q0), U6.5 (A3)
unnamed: R11.1, U3.13 (Q1), U6.4 (A2)
unnamed: R10.1, U3.12 (Q2), U6.3 (A1)
unnamed: R9.1, U3.11 (Q3), U6.2 (A0)
unnamed: R16.1, U5.14 (Q0), U6.9 (A7)
unnamed: R15.1, U5.13 (Q1), U6.8 (A6)
unnamed: R14.1, U5.12 (Q2), U6.7 (A5)
unnamed: R13.1, U5.11 (Q3), U6.6 (A4)
PC_INC: U1.2 (CP), U2.2 (CP), U3.2 (CP), U5.2 (CP)
~PC_LOAD: U1.9 (~PE), U2.9 (~PE), U3.9 (~PE), U5.9 (~PE)
~PC_OUT: U4.19 (CE), U6.19 (CE)
~PC_RST: U1.1 (~MR), U2.1 (~MR), U3.1 (~MR), U5.1 (~MR)

Board: 2 copper layers, 38 parts (0 on the bottom side), 57 nets, no tracks yet.
