KN-Breadboard-Computing/computer/(commit log)

2022-12-15 Created program counter project in logisim
    [pcv1.circ]
2023-04-07 Changes in eeproms code
    [schematics.kicad_pcb, schematics.kicad_sch]
2023-04-09 Deleted old and useless files
    [pcv1.circ, schematics.kicad_pcb, schematics.kicad_sch]
2023-04-09 Initial schematic projects
    [Komputer.ods, arithmetic-logic-unit.kicad_pcb, arithmetic-logic-unit.kicad_sch, clock-unit.kicad_pcb, clock-unit.kicad_sch, control-unit.kicad_pcb, control-unit.kicad_sch, memory-unit.kicad_pcb]
2023-07-06 Created almost all schematics
    [arithmetic-logic-unit.kicad_sch, control-unit.kicad_sch, memory-unit.kicad_sch, program-counter.kicad_pcb, program-counter.kicad_sch, registers.kicad_sch, stack-counter.kicad_sch]
2023-07-06 Arduino code updates
2023-07-31 Directories refactor
    [Komputer.ods]
2023-07-31 Base of architecture manual and arduino memory writer
2023-07-31 Corrected ALU schematic after diy pcb soldered
    [arithmetic-logic-unit.kicad_sch]
2023-07-31 Photo report - stage 1
2023-08-21 Corrections after second diy pcb soldered
    [memory-unit.kicad_sch, program-counter.kicad_sch, registers.kicad_sch]
2023-08-25 Control unit build
    [control-unit.kicad_sch]
2024-02-23 Added missing microcodes to the generator
    - Now all microcodes present in the `config/instructions.json` are
    generated
    - Increment and decrement microcodes are noops for now, due to lack of
    support in the ALU config (at least)
    [generate_microcodes_config.py]
2024-02-24 Fixed EEPROM import and config paths
    - At least on my machine when run from `eeprom-design` directory
    everything is now imported properly
    - Config file paths are no longer hardcoded and can be now provided by
    users of EEPROM classes
    [control_unit_eeproms.py]
2024-02-26 Fixed stack related issues in microcode generator
    - Some microcodes that should have operated on the stack, did not
    [generate_microcodes_config.py]
2024-03-18 Added INT signals
    - Currently hard wired to 0, support from EEPROMs is needed to actually
    do something useful
2024-04-29 Schematics and interrupts
    [arithmetic-logic-unit.kicad_sch, control-unit.kicad_sch, final-alu.kicad_pcb, final-alu.kicad_sch, final-cu.kicad_pcb, final-cu.kicad_sch, final-memory.kicad_pcb, final-memory.kicad_sch]
2024-05-03 Made CPU jump to ISR
    - Return from ISR does not work yet
    [control_unit_eeproms.py, dump_eeproms.py, generate_microcodes_config.py]
2024-05-05 Improved details
    [final-cu.kicad_pcb, final-cu.kicad_sch]
2024-05-08 Instructions moving interrupt data
2024-05-08 Int enable set/reset swapped
    [generate_microcodes_config.py]
2024-05-14 Addded instructions triggering interrupts
2024-05-14 GPU interrupts part 1 (debugging functionality)
2024-05-14 GPU interrupts part 2 (working set_glyph, off by one display)
2024-05-19 PCBs done
    [1825967-1.stp, 18259671.psm, AT28C64B-15PU.SchLib, AT28C64B-15PU.stp, CD4030BEE4.SchLib, CD4030BEE4.stp, CD4043BEE4.stp, CD4071BEE4.SchLib]
2024-05-23 Generated gerber files
    [final-alu-B_Cu.gbr, final-alu-B_Mask.gbr, final-alu-B_Paste.gbr, final-alu-B_Silkscreen.gbr, final-alu-Edge_Cuts.gbr, final-alu-F_Cu.gbr, final-alu-F_Mask.gbr, final-alu-F_Paste.gbr]
2025-01-28 Math mode generation correction
    [generate_instructions_config.py]
