KN-Breadboard-Computing/computer/photos/diy_pcbs/20240428_115800.jpg

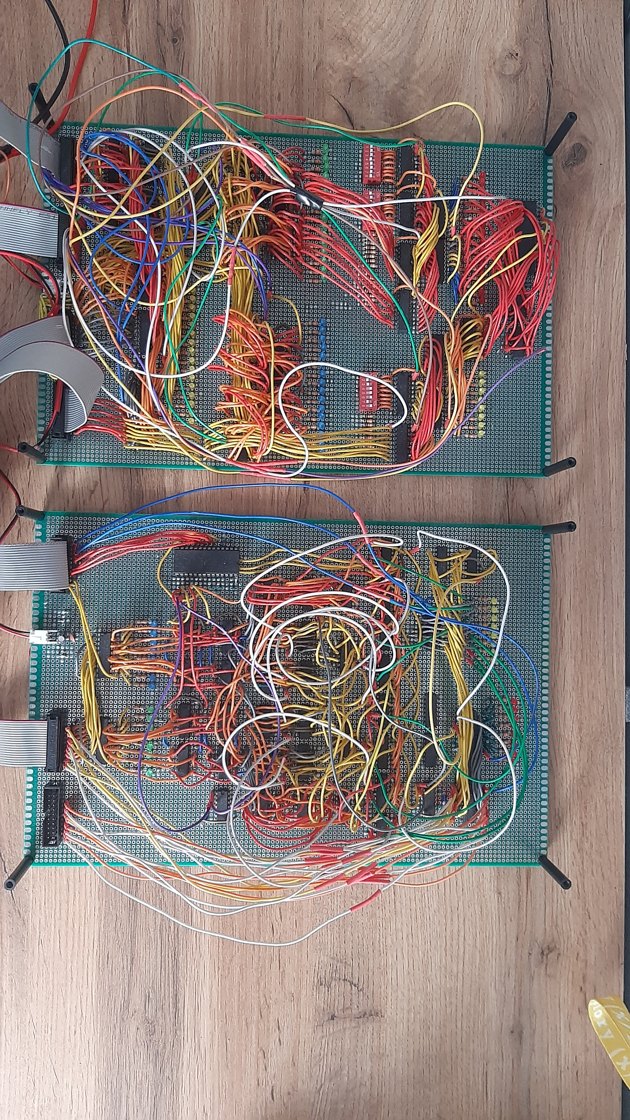
photos/diy_pcbs/20240428_115800.jpg
