KN-Breadboard-Computing/computer/photos/diy_pcbs/20240428_121831.jpg

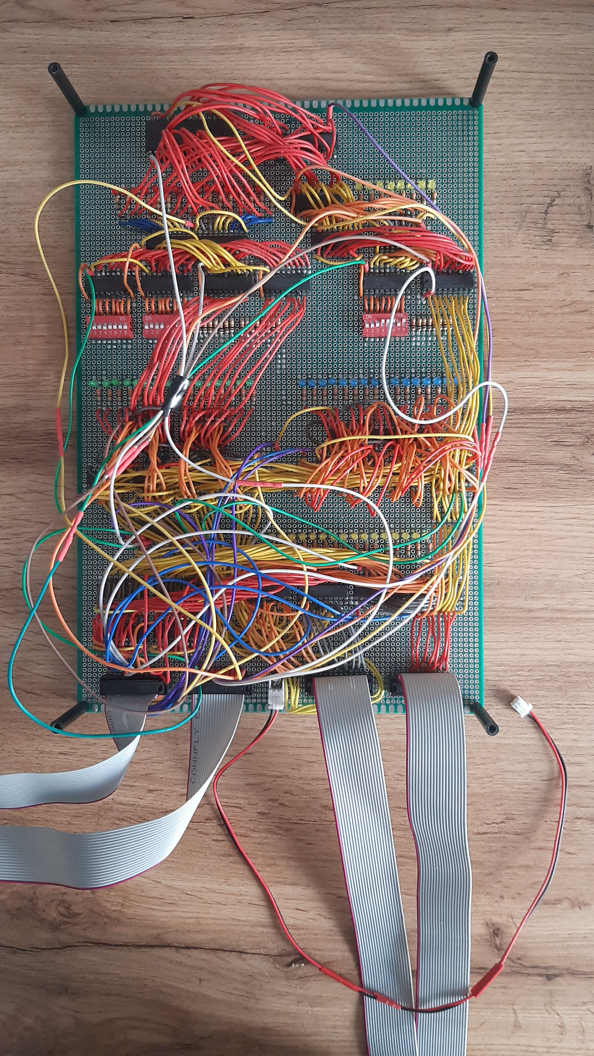
photos/diy_pcbs/20240428_121831.jpg
